siddharthnarayanan/RCI/schematics_review_240215_sidharth.xlsx

Sheet: Processor Design checklist
Schematics Review - T1020 based 12 port AFDX switch
Processor Design schematics from datasheet
S. No | PIN | SIGNAL | IN SCHEMATICS | IN DATASHEET | DESCRIPTION | COMMENTS
1 | L24 | D1_MECC0 | NO CONNECT | G1VDD | Error Correcting Code | why is it unconnected
2 | N23 | D1_MECC1 | NO CONNECT | G1VDD | Error Correcting Code | why is it unconnected
3 | T23 | D1_MECC2 | NO CONNECT | G1VDD | Error Correcting Code | why is it unconnected
4 | U23 | D1_MECC3 | NO CONNECT | G1VDD | Error Correcting Code | why is it unconnected
5 | L23 | D1_MECC4 | NO CONNECT | G1VDD | Error Correcting Code | why is it unconnected
6 | M23 | D1_MECC5 | NO CONNECT | G1VDD | Error Correcting Code | why is it unconnected
7 | R24 | D1_MECC6 | NO CONNECT | G1VDD | Error Correcting Code | why is it unconnected
8 | T24 | D1_MECC7 | NO CONNECT | G1VDD | Error Correcting Code | why is it unconnected
9 | C21 | D1_MDQ00 | DDR_DQ[0..63] | G1VDD | Data
10 | A22 | D1_MDQ01 | DDR_DQ[0..63] | G1VDD | Data
11 | A26 | D1_MDQ02 | DDR_DQ[0..63] | G1VDD | Data
12 | B26 | D1_MDQ03 | DDR_DQ[0..63] | G1VDD | Data
13 | B21 | D1_MDQ04 | DDR_DQ[0..63] | G1VDD | Data
14 | A21 | D1_MDQ05 | DDR_DQ[0..63] | G1VDD | Data
15 | B24 | D1_MDQ06 | DDR_DQ[0..63] | G1VDD | Data
16 | A25 | D1_MDQ07 | DDR_DQ[0..63] | G1VDD | Data
17 | C23 | D1_MDQ08 | DDR_DQ[0..63] | G1VDD | Data
18 | C24 | D1_MDQ09 | DDR_DQ[0..63] | G1VDD | Data
19 | F25 | D1_MDQ10 | DDR_DQ[0..63] | G1VDD | Data
20 | F26 | D1_MDQ11 | DDR_DQ[0..63] | G1VDD | Data
21 | D22 | D1_MDQ12 | DDR_DQ[0..63] | G1VDD | Data
22 | D23 | D1_MDQ13 | DDR_DQ[0..63] | G1VDD | Data
23 | B27 | D1_MDQ14 | DDR_DQ[0..63] | G1VDD | Data
24 | E25 | D1_MDQ15 | DDR_DQ[0..63] | G1VDD | Data
25 | E23 | D1_MDQ16 | DDR_DQ[0..63] | G1VDD | Data
26 | E24 | D1_MDQ17 | DDR_DQ[0..63] | G1VDD | Data
27 | J23 | D1_MDQ18 | DDR_DQ[0..63] | G1VDD | Data
28 | K23 | D1_MDQ19 | DDR_DQ[0..63] | G1VDD | Data
29 | F22 | D1_MDQ20 | DDR_DQ[0..63] | G1VDD | Data
30 | H22 | D1_MDQ21 | DDR_DQ[0..63] | G1VDD | Data
31 | H23 | D1_MDQ22 | DDR_DQ[0..63] | G1VDD | Data
32 | J24 | D1_MDQ23 | DDR_DQ[0..63] | G1VDD | Data
33 | H26 | D1_MDQ24 | DDR_DQ[0..63] | G1VDD | Data
34 | J25 | D1_MDQ25 | DDR_DQ[0..63] | G1VDD | Data
35 | P26 | D1_MDQ26 | DDR_DQ[0..63] | G1VDD | Data
36 | N25 | D1_MDQ27 | DDR_DQ[0..63] | G1VDD | Data
37 | G25 | D1_MDQ28 | DDR_DQ[0..63] | G1VDD | Data
38 | H25 | D1_MDQ29 | DDR_DQ[0..63] | G1VDD | Data
39 | M26 | D1_MDQ30 | DDR_DQ[0..63] | G1VDD | Data
40 | M25 | D1_MDQ31 | DDR_DQ[0..63] | G1VDD | Data
41 | T25 | D1_MDQ32 | DDR_DQ[0..63] | G1VDD | Data
42 | U25 | D1_MDQ33 | DDR_DQ[0..63] | G1VDD | Data
43 | AA26 | D1_MDQ34 | DDR_DQ[0..63] | G1VDD | Data
44 | AA25 | D1_MDQ35 | DDR_DQ[0..63] | G1VDD | Data
45 | P25 | D1_MDQ36 | DDR_DQ[0..63] | G1VDD | Data
46 | R25 | D1_MDQ37 | DDR_DQ[0..63] | G1VDD | Data
47 | W26 | D1_MDQ38 | DDR_DQ[0..63] | G1VDD | Data
48 | Y25 | D1_MDQ39 | DDR_DQ[0..63] | G1VDD | Data
49 | V24 | D1_MDQ40 | DDR_DQ[0..63] | G1VDD | Data
50 | W23 | D1_MDQ41 | DDR_DQ[0..63] | G1VDD | Data
51 | AA22 | D1_MDQ42 | DDR_DQ[0..63] | G1VDD | Data
52 | AC22 | D1_MDQ43 | DDR_DQ[0..63] | G1VDD | Data
53 | W22 | D1_MDQ44 | DDR_DQ[0..63] | G1VDD | Data
54 | V23 | D1_MDQ45 | DDR_DQ[0..63] | G1VDD | Data
55 | AB24 | D1_MDQ46 | DDR_DQ[0..63] | G1VDD | Data
56 | AB23 | D1_MDQ47 | DDR_DQ[0..63] | G1VDD | Data
57 | AD26 | D1_MDQ48 | DDR_DQ[0..63] | G1VDD | Data
58 | AD25 | D1_MDQ49 | DDR_DQ[0..63] | G1VDD | Data
59 | AD23 | D1_MDQ50 | DDR_DQ[0..63] | G1VDD | Data
60 | AE22 | D1_MDQ51 | DDR_DQ[0..63] | G1VDD | Data
61 | AB25 | D1_MDQ52 | DDR_DQ[0..63] | G1VDD | Data
62 | AC25 | D1_MDQ53 | DDR_DQ[0..63] | G1VDD | Data
63 | AC23 | D1_MDQ54 | DDR_DQ[0..63] | G1VDD | Data
64 | AE23 | D1_MDQ55 | DDR_DQ[0..63] | G1VDD | Data
65 | AG25 | D1_MDQ56 | DDR_DQ[0..63] | G1VDD | Data
66 | AH25 | D1_MDQ57 | DDR_DQ[0..63] | G1VDD | Data
67 | AH22 | D1_MDQ58 | DDR_DQ[0..63] | G1VDD | Data
68 | AF22 | D1_MDQ59 | DDR_DQ[0..63] | G1VDD | Data
69 | AF26 | D1_MDQ60 | DDR_DQ[0..63] | G1VDD | Data
70 | AH26 | D1_MDQ61 | DDR_DQ[0..63] | G1VDD | Data
71 | AH23 | D1_MDQ62 | DDR_DQ[0..63] | G1VDD | Data
72 | AF23 | D1_MDQ63 | DDR_DQ[0..63] | G1VDD | Data
73 | U28 | D1_MDIC1 |  |  | Driver Impedence Calibration
74 | P28 | D1_MDIC0 |  |  | Driver Impedence Calibration
75 | F28 | D1_MAPAR_ERR_B |  |  | Address Parity Error
76 | V27 | D1_MAPAR_OUT | NO CONNECT |  | Address Parity Out
77 | F20 | D1_MVREF |  |  | SSTL Reference Voltage
78 | J20 | D1_TPA | NO CONNECT |  | Reserved for internal use only
79 | T27 | D1_MCK0 | DDR_MCK0_P |  | Clock
80 | T28 | D1_MCK0_B | DDR_MCK0_N |  | Clock Complement
81 | R27 | D1_MCK1 | NO CONNECT |  | Clock
82 | R28 | D1_MCK1_B | NO CONNECT |  | Clock Complement
83 | K22 | TEST_OUT4 | NO CONNECT |  | Test Signal
84 | M22 | TEST_OUT5 | NO CONNECT |  | Test Signal
85 | U22 | TEST_OUT6 | NO CONNECT |  | Test Signal
86 | P22 | TEST_OUT7 | NO CONNECT |  | Test Signal
87 | A24 | D1_MDQS0 | DDR_MDQS0_P |  | Data Strobe
88 | D26 | D1_MDQS1 | DDR_MDQS1_P |  | Data Strobe
89 | G24 | D1_MDQS2 | DDR_MDQS2_P |  | Data Strobe
90 | L25 | D1_MDQS3 | DDR_MDQS3_P |  | Data Strobe
91 | W25 | D1_MDQS4 | DDR_MDQS4_P |  | Data Strobe
92 | AA23 | D1_MDQS5 | DDR_MDQS5_P |  | Data Strobe
93 | AE25 | D1_MDQS6 | DDR_MDQS6_P |  | Data Strobe
94 | AG24 | D1_MDQS7 | DDR_MDQS7_P |  | Data Strobe
95 | R23 | D1_MDQS8 | NO CONNECT |  | Data Strobe
96 | A23 | D1_MDQS0_B | DDR_MDQS0_N |  | Data Strobe
97 | D25 | D1_MDQS1_B | DDR_MDQS1_N |  | Data Strobe
98 | G23 | D1_MDQS2_B | DDR_MDQS2_N |  | Data Strobe
99 | K25 | D1_MDQS3_B | DDR_MDQS3_N |  | Data Strobe
100 | V25 | D1_MDQS4_B | DDR_MDQS4_N |  | Data Strobe
101 | Y23 | D1_MDQS5_B | DDR_MDQS5_N |  | Data Strobe
102 | AF25 | D1_MDQS6_B | DDR_MDQS6_N |  | Data Strobe
103 | AH24 | D1_MDQS7_B | DDR_MDQS7_N |  | Data Strobe
104 | P23 | D1_MDQS8_B | NO CONNECT |  | Data Strobe
105 | B22 | D1_MDM0 | DDR_MDM0 |  | Data Mask
106 | C25 | D1_MDM1 | DDR_MDM1 |  | Data Mask
107 | F23 | D1_MDM2 | DDR_MDM2 |  | Data Mask
108 | K26 | D1_MDM3 | DDR_MDM3 |  | Data Mask
109 | U26 | D1_MDM4 | DDR_MDM4 |  | Data Mask
110 | Y24 | D1_MDM5 | DDR_MDM5 |  | Data Mask
111 | AD24 | D1_MDM6 | DDR_MDM6 |  | Data Mask
112 | AF24 | D1_MDM7 | DDR_MDM7 |  | Data Mask
113 | N24 | D1_MDM8 | NO CONNECT |  | Data Mask
114 | Y28 | D1_MBA0 | DDR_MBA0 |  | Bank Select
115 | W28 | D1_MBA1 | DDR_MBA1 |  | Bank Select
116 | E28 | D1_MBA2 | DDR_MBA2 |  | Bank Select
117 | V28 | D1_MA00 | DDR_MA0 |  | Address
118 | N28 | D1_MA01 | DDR_MA1 |  | Address
119 | N27 | D1_MA02 | DDR_MA2 |  | Address
120 | M28 | D1_MA03 | DDR_MA3 |  | Address
121 | L27 | D1_MA04 | DDR_MA4 |  | Address
122 | L28 | D1_MA05 | DDR_MA5 |  | Address
123 | K28 | D1_MA06 | DDR_MA6 |  | Address
124 | J28 | D1_MA07 | DDR_MA7 |  | Address
125 | J27 | D1_MA08 | DDR_MA8 |  | Address
126 | G27 | D1_MA09 | DDR_MA9 |  | Address
127 | Y27 | D1_MA10 | DDR_MA10 |  | Address
128 | H28 | D1_MA11 | DDR_MA11 |  | Address
129 | G28 | D1_MA12 | DDR_MA12 |  | Address
130 | AE28 | D1_MA13 | DDR_MA13 |  | Address
131 | E27 | D1_MA14 | NO CONNECT |  | Address
132 | D28 | D1_MA15 | NO CONNECT |  | Address
133 | AC28 | D1_MRAS_B | DDR_MRAS_N |  | Row Address Strobe
134 | AA28 | D1_MCAS_B | DDR_MCAS_N |  | Column Address Strobe
135 | AB27 | D1_MWE_B | DDR_MWE_N |  | Write Enable
136 | AB28 | D1_MCS0_B | DDR_MCS0_N |  | Chip Select
137 | AC27 | D1_MCS1_B | NO CONNECT |  | Chip Select
138 | AG27 | D1_MCS2_B | NO CONNECT |  | Chip Select
139 | AF28 | D1_MCS3_B | NO CONNECT |  | Chip Select
140 | C27 | D1_MCKE0 | DDR_MCKE0 |  | Clock Enable
141 | C28 | D1_MCKE1 | NO CONNECT |  | Clock Enable
142 | H21 | TEST_OUT0 | NO CONNECT |  | Test Signal
143 | F21 | TEST_OUT1 | NO CONNECT |  | Test Signal
144 | AD28 | D1_MODT0 | DDR_MODT0 |  | On Die Termination
145 | AE27 | D1_MODT1 | NO CONNECT |  | On Die Termination
146 | W21 | TEST_OUT2 | NO CONNECT |  | Test Signal
147 | V21 | TEST_OUT3 | NO CONNECT |  | Test Signal
148 | A4 | IFC_AD00 | IFC_AD0 |  | IFC Address / Data
149 | B5 | IFC_AD01 | IFC_AD1 |  | IFC Address / Data
150 | A5 | IFC_AD02 | IFC_AD2 |  | IFC Address / Data
151 | B6 | IFC_AD03 | IFC_AD3 |  | IFC Address / Data
152 | A6 | IFC_AD04 | IFC_AD4 |  | IFC Address / Data
153 | A7 | IFC_AD05 | IFC_AD5 |  | IFC Address / Data
154 | B8 | IFC_AD06 | IFC_AD6 |  | IFC Address / Data
155 | A8 | IFC_AD07 | IFC_AD7 |  | IFC Address / Data
156 | B9 | IFC_AD08 | IFC_AD8 |  | IFC Address / Data
157 | A9 | IFC_AD09 | IFC_AD9 |  | IFC Address / Data
158 | A10 | IFC_AD10 | IFC_AD10 |  | IFC Address / Data
159 | B11 | IFC_AD11 | IFC_AD11 |  | IFC Address / Data
160 | A11 | IFC_AD12 | IFC_AD12 |  | IFC Address / Data
161 | B12 | IFC_AD13 | IFC_AD13 |  | IFC Address / Data
162 | A12 | IFC_AD14 | IFC_AD14 |  | IFC Address / Data
163 | A13 | IFC_AD15 | IFC_AD15 |  | IFC Address / Data
164 | C5 | IFC_A16 | IFC_A16 |  | IFC Address
165 | C6 | IFC_A17 | IFC_A17 |  | IFC Address
166 | D7 | IFC_A18 | IFC_A18 |  | IFC Address
167 | C7 | IFC_A19 | IFC_A19 |  | IFC Address
168 | D8 | IFC_A20 | IFC_A20 |  | IFC Address
169 | C8 | IFC_A21 | IFC_A21 |  | IFC Address
170 | D9 | IFC_A22 | IFC_A22 |  | IFC Address
171 | C9 | IFC_A23 | IFC_A23 |  | IFC Address
172 | D10 | IFC_A24 | IFC_A24 |  | IFC Address
173 | C10 | IFC_A25 | IFC_A25 |  | IFC Address
174 | E11 | IFC_A26 | IFC_A26 |  | IFC Address
175 | C11 | IFC_A27 | IFC_A27 |  | IFC Address
176 | D11 | IFC_A28 | IFC_A28 |  | IFC Address
177 | C12 | IFC_A29 | IFC_A29 |  | IFC Address
178 | D12 | IFC_A30 | IFC_A30 |  | IFC Address
179 | E12 | IFC_A31 | NO CONNECT |  | IFC Address
180 | C13 | IFC_CS0_B | IFC_CS0_N |  | IFC Chip Select
181 | E15 | IFC_CS1_B | NO CONNECT |  | IFC Chip Select
182 | D16 | IFC_CS2_B | NO CONNECT |  | IFC Chip Select
183 | C16 | IFC_CS3_B | NO CONNECT |  | IFC Chip Select
184 | E17 | IFC_CS4_B | NO CONNECT |  | IFC Chip Select
185 | C17 | IFC_CS5_B | NO CONNECT |  | IFC Chip Select
186 | D18 | IFC_CS6_B | NO CONNECT |  | IFC Chip Select
187 | C19 | IFC_CS7_B | NO CONNECT |  | IFC Chip Select
188 | D13 | IFC_WE0_B | IFC_WE_N |  | IFC Write Enable
189 | F16 | IFC_CLE | IFC_CLE |  | IFC Command Latch Enable
190 | D15 | IFC_OE_B |  |  | IFC Output Enable
191 | B15 | IFC_RB0_B |  |  | IFC Ready / Busy CS0
192 | A15 | IFC_RB1_B |  |  | IFC Ready / Busy CS1
193 | F17 | IFC_WP0_B |  |  | IFC Write Protect
194 | D17 | IFC_AVD |  |  | IFC Address Valid
195 | A14 | IFC_BCTL | NO CONNECT |  | IFC Buffer control
196 | B14 | IFC_TE |  |  | IFC External Transceiver Enable
197 | A17 | IFC_CLK0 | NO CONNECT |  | IFC Clock
198 | A19 | IFC_CLK1 | NO CONNECT |  | IFC Clock
199 | D14 | IFC_NDDDR_CLK | NO CONNECT |  | IFC NAND DDR Clock
200 | A16 | IFC_NDDQS | NO CONNECT |  | IFC DQS Strobe
201 | E14 | IFC_PERR_B |  |  | IFC Parity Error
202 | C15 | IFC_PAR0 |  |  | IFC Address & Data Parity
203 | C14 | IFC_PAR1 |  |  | IFC Address & Data Parity
204 | F9 | SCAN_MODE_B |  |  | Reserved
205 | G8 | TEST_SEL_B |  |  | Reserved
206 | F7 | IRQ00 |  |  | External Interrupt
207 | D3 | IRQ01 |  |  | External Interrupt
208 | E9 | IRQ02 |  |  | External Interrupt
209 | D1 | IRQ03 |  |  | External Interrupt
210 | D4 | IRQ04 |  |  | External Interrupt
211 | D5 | IRQ05 |  |  | External Interrupt
212 | AB4 | IRQ06 |  |  | External Interrupt
213 | AD5 | IRQ07 |  |  | External Interrupt
214 | AB1 | IRQ08 |  |  | External Interrupt
215 | AC5 | IRQ09 |  |  | External Interrupt
216 | L4 | IRQ10 |  |  | External Interrupt
217 | U3 | IRQ11 |  |  | External Interrupt
218 | A3 | IRQ_OUT_B |  |  | Interrupt Output
219 | F19 | TMP_DETECT_B |  |  | Tamper Detect
220 | F13 | PORESET_B |  |  | Power On Reset
221 | E8 | HRESET_B |  |  | Hard Reset
222 | B3 | RESET_REQ_B |  |  | Reset Request (POR or Hard)
223 | P5 | DMA1_DREQ0_B |  |  | DMA1 channel 0 request
224 | U5 | DMA1_DACK0_B | NO CONNECT |  | DMA1 channel 0 acknowledge
225 | R5 | DMA1_DDONE0_B | NO CONNECT |  | DMA1 channel 0 done
226 | V5 | DMA2_DREQ0_B |  |  | DMA2 channel 0 request
227 | AA5 | DMA2_DACK0_B |  |  | DMA2 channel 0 acknowledge
228 | Y5 | DMA2_DDONE0_B |  |  | DMA2 channel 0 done
229 | A18 | TDI |  |  | Test Data In
230 | C18 | TDO |  |  | Test Data Out
231 | E18 | TCK |  |  | Test Clock
232 | B18 | TMS |  |  | Test Mode Select
233 | D19 | TRST_B |  |  | Test Reset
234 | G15 | SYSCLK |  |  | System Clock
235 | J21 | DDRCLK |  |  | DDR Controller Clock
236 | G14 | DIFF_SYSCLK |  |  | Single Oscillator Source Reference Clock Differential (positive)
237 | F14 | DIFF_SYSCLK_B |  |  | Single Oscillator Source Reference Clock Differential (negative)
238 | B17 | RTC |  |  | General Purpose Input/Output
239 | E21 | TD1_ANODE | NO CONNECT |  | Thermal diode anode
240 | G21 | TD1_CATHODE | NO CONNECT |  | Thermal diode cathode
241 | D6 | EVT0_B |  |  | Event 0
242 | C4 | EVT1_B |  |  | Event 1
243 | C1 | EVT2_B | EVT_PWR_EN |  | Event 2
244 | C2 | EVT3_B |  |  | Event 3
245 | C3 | EVT4_B |  |  | Event 4
246 | W1 | IIC1_SCL |  |  | Serial Clock (supports PBL)
247 | V1 | IIC1_SDA |  |  | Serial Clock (supports PBL)
248 | V3 | IIC2_SCL |  |  | Serial Clock
249 | Y3 | IIC2_SDA |  |  | Serial Data
250 | V2 | IIC3_SCL |  |  | Serial Clock
251 | W3 | IIC3_SDA |  |  | Serial Data
252 | AA3 | IIC4_SCL |  |  | Serial Clock
253 | AB3 | IIC4_SDA |  |  | Serial Data
254 | AA1 | UART1_SIN |  |  | General Purpose Input/Output
255 | AA2 | UART1_SOUT |  |  | General Purpose Input/Output
256 | Y2 | UART1_CTS_B |  |  | General Purpose Input/Output
257 | Y1 | UART1_RTS_B | NO CONNECT |  | General Purpose Input/Output
258 | W4 | UART2_SIN |  |  | General Purpose Input/Output
259 | AA4 | UART2_SOUT |  |  | General Purpose Input/Output
260 | Y4 | UART2_CTS_B |  |  | General Purpose Input/Output
261 | V4 | UART2_RTS_B | NO CONNECT |  | General Purpose Input/Output
262 | B2 | ASLEEP |  |  | General Purpose Input/Output
263 | F18 | CKSTP_OUT_B |  |  | Checkstop Out
264 | E6 | CLK_OUT |  |  | Clock Out
265 | B20 | FA_ANALOG_PIN |  |  | Reserved for internal use only
266 | C20 | FA_ANALOG_G_V |  |  | Reserved for internal use only
267 | AE3 | EC1_TXD0
268 | AE4 | EC1_TXD1
269 | AD3 | EC1_TXD2
270 | AC3 | EC1_TXD3
271 | AF4 | EC1_TX_CTL
272 | AF3 | EC1_GTX_CLK
273 | AC4 | EC1_TX_ER
274 | AF2 | EC1_RXD0
275 | AF1 | EC1_RXD1
276 | AE1 | EC1_RXD2
277 | AD2 | EC1_RXD3
278 | AG2 | EC1_RX_CTL
279 | AD1 | EC1_RX_CLK
280 | AG3 | EC1_GTX_CLK125
281 | AC2 | EC1_RX_ER
282 | AC1 | EC1_COL
283 | AH3 | EMI1_MDC
284 | AH4 | EMI1_MDIO
285 | AC8 | TSEC_1588_CLK_IN
286 | AB6 | TSEC_1588_TRIG_IN1
287 | AE5 | TSEC_1588_TRIG_IN2
288 | AE7 | EC2_TXD0
289 | AF7 | EC2_TXD1
290 | AF6 | EC2_TXD2
291 | AG5 | EC2_TXD3
292 | AF8 | EC2_TX_CTL
293 | AE8 | EC2_GTX_CLK
294 | AH8 | EC2_RXD0
295 | AG7 | EC2_RXD1
296 | AH7 | EC2_RXD2
297 | AH6 | EC2_RXD3
298 | AG8 | EC2_RX_CTL
299 | AH5 | EC2_RX_CLK
300 | AC6 | EC2_GTX_CLK125
301 | AD7 | TSEC_1588_CLK_OUT
302 | AF5 | TSEC_1588_ALARM_OUT1
303 | AC7 | TSEC_1588_ALARM_OUT2
304 | AE6 | TSEC_1588_PULSE_OUT1
305 | AD8 | TSEC_1588_PULSE_OUT2
306 | AH10 | SD1_RX0_P
307 | AG10 | SD1_RX0_N
308 | AH11 | SD1_RX1_P
309 | AG11 | SD1_RX1_N
310 | AH13 | SD1_RX2_P
311 | AG13 | SD1_RX2_N
312 | AH14 | SD1_RX3_P
313 | AG14 | SD1_RX3_N
314 | AH16 | SD1_RX4_P
315 | AG16 | SD1_RX4_N
316 | AH17 | SD1_RX5_P
317 | AG17 | SD1_RX5_N
318 | AH19 | SD1_RX6_P
319 | AG19 | SD1_RX6_N
320 | AH20 | SD1_RX7_P
321 | AG20 | SD1_RX7_N
322 | AB14 | SD1_REF_CLK1_P
323 | AA14 | SD1_REF_CLK1_N
324 | Y15 | SD1_PLL1_TPA
325 | AB15 | SD1_PLL1_TPD
326 | Y19 | SD1_PLL2_TPA
327 | AB19 | SD1_PLL2_TPD
328 | AD10 | SD1_TX0_P
329 | AE10 | SD1_TX0_N
330 | AD11 | SD1_TX1_P
331 | AE11 | SD1_TX1_N
332 | AD13 | SD1_TX2_P
333 | AE13 | SD1_TX2_N
334 | AD14 | SD1_TX3_P
335 | AE14 | SD1_TX3_N
336 | AD16 | SD1_TX4_P
337 | AE16 | SD1_TX4_N
338 | AD17 | SD1_TX5_P
339 | AE17 | SD1_TX5_N
340 | AD19 | SD1_TX6_P
341 | AE19 | SD1_TX6_N
342 | AD20 | SD1_TX7_P
343 | AE20 | SD1_TX7_N
344 | AB18 | SD1_REF_CLK2_P
345 | AA18 | SD1_REF_CLK2_N
346 | Y20 | SD1_IMP_CAL_TX
347 | AA12 | SD1_IMP_CAL_RX
348 | U2 | TDMA_RXD
349 | U1 | TDMA_RSYNC
350 | T1 | TDMA_TXD
351 | R1 | TDMA_TSYNC
352 | R2 | TDMA_RQ
353 | U4 | TDMB_RXD
354 | T3 | TDMB_RSYNC
355 | T4 | TDMB_TXD
356 | R3 | TDMB_TSYNC
357 | R4 | TDMB_RQ
358 | P4 | CLK09
359 | P3 | CLK10
360 | N4 | CLK11
361 | M4 | CLK12
362 | F5 | USB1_PWRFAULT
363 | H5 | USB2_PWRFAULT
364 | G4 | USB_IBIAS_REXT
365 | F8 | USBCLK
366 | F6 | USB1_DRVVBUS
367 | F1 | USB1_UDP
368 | F2 | USB1_UDM
369 | E4 | USB1_VBUSCLMP
370 | F4 | USB1_UID
371 | J5 | USB2_DRVVBUS
372 | H1 | USB2_UDP
373 | H2 | USB2_UDM
374 | J4 | USB2_VBUSCLMP
375 | H4 | USB2_UID
376 | D27 | G1VDD01
377 | F27 | G1VDD02
378 | H27 | G1VDD03
379 | K21 | G1VDD04
380 | K27 | G1VDD05
381 | L21 | G1VDD06
382 | M21 | G1VDD07
383 | M27 | G1VDD08
384 | N21 | G1VDD09
385 | P21 | G1VDD10
386 | P27 | G1VDD11
387 | R21 | G1VDD12
388 | T21 | G1VDD13
389 | U21 | G1VDD14
390 | U27 | G1VDD15
391 | W27 | G1VDD16
392 | AA27 | G1VDD17
393 | AD27 | G1VDD18
394 | AF27 | G1VDD19
395 | V8 | LVDD1
396 | W8 | LVDD2
397 | T8 | LV1DD1
398 | U8 | LV1DD2
399 | J14 | OVDD1
400 | J15 | OVDD2
401 | J16 | OVDD3
402 | J17 | OVDD4
403 | J18 | OVDD5
404 | J19 | OVDD6
405 | J11 | O1VDD1
406 | J12 | O1VDD2
407 | J13 | O1VDD3
408 | N8 | DVDD1
409 | P8 | DVDD2
410 | R8 | DVDD3
411 | M8 | CVDD1
412 | L8 | EVDD1
413 | F12 | PROG_SFP
414 | F11 | PROG_MTR
415 | G18 | FA_VL
416 | G9 | TH_VDD
418 | W15 | S1VDD1
419 | W16 | S1VDD2
420 | W17 | S1VDD3
421 | W18 | S1VDD4
422 | W19 | S1VDD5
423 | W20 | S1VDD6
424 | Y13 | S1VDD7
425 | AC9 | X1VDD1
426 | AC12 | X1VDD2
427 | AC15 | X1VDD3
428 | AC18 | X1VDD4
429 | AC21 | X1VDD5
430 | K15 | VDD01
431 | K17 | VDD02
432 | K19 | VDD03
433 | L12 | VDD04
434 | L14 | VDD05
435 | L16 | VDD06
436 | L18 | VDD07
437 | L20 | VDD08
438 | M9 | VDD09
439 | M13 | VDD10
440 | M15 | VDD11
441 | M17 | VDD12
442 | M19 | VDD13
443 | N12 | VDD14
444 | N14 | VDD15
445 | N16 | VDD16
446 | N18 | VDD17
447 | N20 | VDD18
448 | P9 | VDD19
449 | P11 | VDD20
450 | P13 | VDD21
451 | P15 | VDD22
452 | P17 | VDD23
453 | P19 | VDD24
454 | R12 | VDD25
455 | R14 | VDD26
456 | R16 | VDD27
457 | R18 | VDD28
458 | R20 | VDD29
459 | T9 | VDD30
460 | T13 | VDD31
461 | T15 | VDD32
462 | T17 | VDD33
463 | T19 | VDD34
464 | U14 | VDD35
465 | U16 | VDD36
466 | U18 | VDD37
467 | U20 | VDD38
468 | V9 | VDD39
469 | V13 | VDD40
470 | V15 | VDD41
471 | V17 | VDD42
472 | V19 | VDD43
473 | W14 | VDD44
474 | Y8 | VDD45
475 | Y9 | VDD46
476 | Y11 | VDD47
477 | K11 | VDDC01
478 | K13 | VDDC02
479 | L10 | VDDC03
480 | M11 | VDDC04
481 | N10 | VDDC05
482 | R10 | VDDC06
483 | K9 | USB_SVDD1
484 | K10 | USB_SVDD2
485 | J8 | USB_HVDD1
486 | K8 | USB_HVDD2
487 | J9 | USB_OVDD1
488 | J10 | USB_OVDD2
489 | AB9 | SENSEVDDC
490 | AB10 | SENSEGNDC
491 | G19 | SENSEVDD
492 | G20 | SENSEGND
493 | T11 | VDDC07
494 | U10 | VDDC08
495 | U12 | VDDC09
496 | V11 | VDDC10
497 | W10 | VDDC11
498 | W12 | VDDC12
499 | AG28 | NC_DET | NO CONNECT
500 | G17 | NC01 | NO CONNECT
501 | N6 | NC02 | NO CONNECT
502 | T6 | NC03 | NO CONNECT
503 | U6 | NC04 | NO CONNECT
504 | V6 | NC05 | NO CONNECT
505 | W6 | NC06 | NO CONNECT
506 | Y6 | NC07 | NO CONNECT
507 | AA6 | NC08 | NO CONNECT
508 | AA7 | NC09 | NO CONNECT
509 | AA8 | NC10 | NO CONNECT
510 | AA9 | NC11 | NO CONNECT
511 | AA10 | NC12 | NO CONNECT
512 | AB8 | NC13 | NO CONNECT
513 | AB11 | NC14 | NO CONNECT
514 | AB12 | NC15 | NO CONNECT
515 | AH27 | DEV_DET | NO CONNECT
516 | G6 | SPARE1 | NO CONNECT
517 | H6 | SPARE2 | NO CONNECT
518 | J6 | SPARE3 | NO CONNECT
519 | F10 | TH_TPA | NO CONNECT
520 | G11 | AVDD_CGA1 | AVDD_CGA1
521 | G12 | AVDD_CGA2 | AVDD_CGA2
522 | G10 | AVDD_PLAT | AVDD_PLAT
523 | E20 | AVDD_D1 | AVDD_DDR1
524 | AB16 | AVDD_SD1_PLL1 | AVDD_SD1_PLL1
525 | AA16 | AGND_SD1_PLL1 | AGND_SD1_PLL1
526 | AB20 | AVDD_SD1_PLL2 | AVDD_SD1_PLL2
527 | AA20 | AGND_SD1_PLL2 | AGND_SD1_PLL2
528 | A2 | GND001 | GND
529 | A20 | GND002 | GND
530 | A27 | GND003 | GND
531 | B1 | GND004 | GND
532 | B4 | GND005 | GND
533 | B7 | GND006 | GND
534 | B10 | GND007 | GND
535 | B13 | GND008 | GND
536 | B16 | GND009 | GND
537 | B19 | GND010 | GND
538 | B23 | GND011 | GND
539 | B25 | GND012 | GND
540 | B28 | GND013 | GND
541 | C22 | GND014 | GND
542 | C26 | GND015 | GND
543 | D2 | GND016 | GND
544 | D20 | GND017 | GND
545 | D21 | GND018 | GND
546 | D24 | GND019 | GND
547 | E5 | GND020 | GND
548 | E7 | GND021 | GND
549 | E10 | GND022 | GND
550 | E13 | GND023 | GND
551 | E16 | GND024 | GND
552 | E19 | GND025 | GND
553 | E22 | GND026 | GND
554 | E26 | GND027 | GND
555 | F15 | GND028 | GND
556 | F24 | GND029 | GND
557 | G7 | GND030 | GND
558 | G13 | GND031 | GND
559 | G16 | GND032 | GND
560 | G22 | GND033 | GND
561 | G26 | GND034 | GND
562 | H7 | GND035 | GND
563 | H8 | GND036 | GND
564 | H9 | GND037 | GND
565 | H10 | GND038 | GND
566 | H11 | GND039 | GND
567 | H12 | GND040 | GND
568 | H13 | GND041 | GND
569 | H14 | GND042 | GND
570 | H15 | GND043 | GND
571 | H16 | GND044 | GND
572 | H17 | GND045 | GND
573 | H18 | GND046 | GND
574 | H19 | GND047 | GND
575 | H20 | GND048 | GND
576 | H24 | GND049 | GND
577 | J7 | GND050 | GND
578 | J22 | GND051 | GND
579 | J26 | GND052 | GND
580 | K2 | GND053 | GND
581 | K5 | GND054 | GND
582 | K6 | GND055 | GND
583 | K7 | GND056 | GND
584 | K12 | GND057 | GND
585 | K14 | GND058 | GND
586 | K16 | GND059 | GND
587 | K18 | GND060 | GND
588 | K20 | GND061 | GND
589 | K24 | GND062 | GND
590 | L7 | GND063 | GND
591 | L9 | GND064 | GND
592 | L11 | GND065 | GND
593 | L13 | GND066 | GND
594 | L15 | GND067 | GND
595 | L17 | GND068 | GND
596 | L19 | GND069 | GND
597 | L22 | GND070 | GND
598 | L26 | GND071 | GND
599 | M7 | GND072 | GND
600 | M10 | GND073 | GND
601 | M12 | GND074 | GND
602 | M14 | GND075 | GND
603 | M16 | GND076 | GND
604 | M18 | GND077 | GND
605 | M20 | GND078 | GND
606 | M24 | GND079 | GND
607 | N2 | GND080 | GND
608 | N5 | GND081 | GND
609 | N7 | GND082 | GND
610 | N9 | GND083 | GND
611 | N11 | GND084 | GND
612 | N13 | GND085 | GND
613 | N15 | GND086 | GND
614 | N17 | GND087 | GND
615 | N19 | GND088 | GND
616 | N22 | GND089 | GND
617 | N26 | GND090 | GND
618 | P7 | GND091 | GND
619 | P10 | GND092 | GND
620 | P12 | GND093 | GND
621 | P14 | GND094 | GND
622 | P16 | GND095 | GND
623 | P18 | GND096 | GND
624 | P20 | GND097 | GND
625 | P24 | GND098 | GND
626 | R7 | GND099 | GND
627 | R9 | GND100 | GND
628 | R11 | GND101 | GND
629 | R13 | GND102 | GND
630 | R15 | GND103 | GND
631 | R17 | GND104 | GND
632 | R19 | GND105 | GND
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
751 | AC20 | X1GND08 | GND
752 | AD9 | X1GND09 | GND
753 | AD12 | X1GND10 | GND
754 | AD15 | X1GND11 | GND
755 | AD18 | X1GND12 | GND
756 | AD21 | X1GND13 | GND
757 | AE9 | X1GND14 | GND
758 | AE12 | X1GND15 | GND
759 | AE15 | X1GND16 | GND
760 | AE18 | X1GND17 | GND
761 | AE21 | X1GND18 | GND

Sheet: DDR3L Interface
Schematics Review - T1020 based 12 port AFDX switch
DDR3L Interface schematics from datasheet
S. No | PIN | SIGNAL | IN SCHEMATICS | IN DATASHEET | TYPE | DESCRIPTION | COMMENTS
MT41K128M16JT-125-AATK (U2)
1 | A1 | VDDQ | 1V35 | 1.35V, 1.283–1.45V operational | Supply | DQ power supply
2 | A8 | VDDQ | 1V35 | 1.35V, 1.283–1.45V operational | Supply | DQ power supply
3 | C1 | VDDQ | 1V35 | 1.35V, 1.283–1.45V operational | Supply | DQ power supply
4 | C9 | VDDQ | 1V35 | 1.35V, 1.283–1.45V operational | Supply | DQ power supply
5 | D2 | VDDQ | 1V35 | 1.35V, 1.283–1.45V operational | Supply | DQ power supply
6 | E9 | VDDQ | 1V35 | 1.35V, 1.283–1.45V operational | Supply | DQ power supply
7 | F1 | VDDQ | 1V35 | 1.35V, 1.283–1.45V operational | Supply | DQ power supply
8 | H2 | VDDQ | 1V35 | 1.35V, 1.283–1.45V operational | Supply | DQ power supply
9 | H9 | VDDQ | 1V35 | 1.35V, 1.283–1.45V operational | Supply | DQ power supply
10 | B1 | VSSQ | Ground | Ground | Supply | DQ ground | Isolated on the device
11 | B9 | VSSQ | Ground | Ground | Supply | DQ ground | Isolated on the device
12 | D1 | VSSQ | Ground | Ground | Supply | DQ ground | Isolated on the device
13 | D8 | VSSQ | Ground | Ground | Supply | DQ ground | Isolated on the device
14 | E2 | VSSQ | Ground | Ground | Supply | DQ ground | Isolated on the device
15 | E8 | VSSQ | Ground | Ground | Supply | DQ ground | Isolated on the device
16 | F9 | VSSQ | Ground | Ground | Supply | DQ ground | Isolated on the device
17 | G1 | VSSQ | Ground | Ground | Supply | DQ ground | Isolated on the device
18 | G9 | VSSQ | Ground | Ground | Supply | DQ ground | Isolated on the device
19 | A9 | VSS | Ground | Ground | Supply | Ground
20 | B3 | VSS | Ground | Ground | Supply | Ground
21 | E1 | VSS | Ground | Ground | Supply | Ground
22 | G8 | VSS | Ground | Ground | Supply | Ground
23 | J2 | VSS | Ground | Ground | Supply | Ground
24 | J8 | VSS | Ground | Ground | Supply | Ground
25 | M1 | VSS | Ground | Ground | Supply | Ground
26 | M9 | VSS | Ground | Ground | Supply | Ground
27 | P1 | VSS | Ground | Ground | Supply | Ground
28 | P9 | VSS | Ground | Ground | Supply | Ground
29 | T1 | VSS | Ground | Ground | Supply | Ground
30 | T9 | VSS | Ground | Ground | Supply | Ground
31 | B2 | VDD | 1V35 | 1.35V, 1.283–1.45V operational | Supply | Power supply
32 | D9 | VDD | 1V35 | 1.35V, 1.283–1.45V operational | Supply | Power supply
33 | G7 | VDD | 1V35 | 1.35V, 1.283–1.45V operational | Supply | Power supply
34 | K2 | VDD | 1V35 | 1.35V, 1.283–1.45V operational | Supply | Power supply
35 | K8 | VDD | 1V35 | 1.35V, 1.283–1.45V operational | Supply | Power supply
36 | N1 | VDD | 1V35 | 1.35V, 1.283–1.45V operational | Supply | Power supply
37 | N9 | VDD | 1V35 | 1.35V, 1.283–1.45V operational | Supply | Power supply
38 | R1 | VDD | 1V35 | 1.35V, 1.283–1.45V operational | Supply | Power supply
39 | R9 | VDD | 1V35 | 1.35V, 1.283–1.45V operational | Supply | Power supply
40 | M8 | VREFCA | MVREF |  | Supply | Reference voltage for control, command, and address
41 | H1 | VREFDQ | MVREF |  | Supply | Reference voltage for data
42 | J1 | NC | NO CONNECT | NO CONNECT | - | NO CONNECT
43 | J9 | NC | NO CONNECT | NO CONNECT | - | NO CONNECT
44 | L1 | NC | NO CONNECT | NO CONNECT | - | NO CONNECT
45 | L9 | NC | NO CONNECT | NO CONNECT | - | NO CONNECT
46 | M7 | NC | NO CONNECT | NO CONNECT | - | NO CONNECT
47 | T7 | NC | NO CONNECT | NO CONNECT | - | NO CONNECT
48 | L8 | ZQ | GND | 240Ω resistor (RZQ), which is tied to VSSQ |  | External reference ball for output drive calibration
49 | T3 | A13 | DDR_MA13 | Input | Input | Address inputs
50 | N7 | A12/BC# | DDR_MA12 | Input | Input | Address inputs
51 | R7 | A11 | DDR_MA11 | Input | Input | Address inputs
52 | L7 | A10/AP | DDR_MA10 | Input | Input | Address inputs
53 | R3 | A9 | DDR_MA9 | Input | Input | Address inputs
54 | T8 | A8 | DDR_MA8 | Input | Input | Address inputs
55 | R2 | A7 | DDR_MA7 | Input | Input | Address inputs
56 | R8 | A6 | DDR_MA6 | Input | Input | Address inputs
57 | P2 | A5 | DDR_MA5 | Input | Input | Address inputs
58 | P8 | A4 | DDR_MA4 | Input | Input | Address inputs
59 | N2 | A3 | DDR_MA3 | Input | Input | Address inputs
60 | P3 | A2 | DDR_MA2 | Input | Input | Address inputs
61 | P7 | A1 | DDR_MA1 | Input | Input | Address inputs
62 | N3 | A0 | DDR_MA0 | Input | Input | Address inputs
63 | M3 | BA2 | DDR_MBA2 | Input | Input | Address inputs
64 | N8 | BA1 | DDR_MBA1 | Input | Input | Address inputs
65 | M2 | BA0 | DDR_MBA0 | Input | Input | Address inputs
66 | J3 | RAS# | DDR_MRAS_N | Command inputs | Input | Command inputs
67 | K3 | CAS# | DDR_MCAS_N | Command inputs | Input | Command inputs
68 | E3 | DQ0 | DDR_DQ0 | Data input/output | I/O | Data input/output
69 | F7 | DQ1 | DDR_DQ1 | Data input/output | I/O | Data input/output
70 | F2 | DQ2 | DDR_DQ2 | Data input/output | I/O | Data input/output
71 | F8 | DQ3 | DDR_DQ3 | Data input/output | I/O | Data input/output
72 | H3 | DQ4 | DDR_DQ4 | Data input/output | I/O | Data input/output
73 | H8 | DQ5 | DDR_DQ5 | Data input/output | I/O | Data input/output
74 | G2 | DQ6 | DDR_DQ6 | Data input/output | I/O | Data input/output
75 | H7 | DQ7 | DDR_DQ7 | Data input/output | I/O | Data input/output
76 | D7 | DQ8 | DDR_DQ8 | Data input/output | I/O | Data input/output
77 | C3 | DQ9 | DDR_DQ9 | Data input/output | I/O | Data input/output
78 | C8 | DQ10 | DDR_DQ10 | Data input/output | I/O | Data input/output
79 | C2 | DQ11 | DDR_DQ11 | Data input/output | I/O | Data input/output
80 | A7 | DQ12 | DDR_DQ12 | Data input/output | I/O | Data input/output
81 | A2 | DQ13 | DDR_DQ13 | Data input/output | I/O | Data input/output
82 | B8 | DQ14 | DDR_DQ14 | Data input/output | I/O | Data input/output
83 | A3 | DQ15 | DDR_DQ15 | Data input/output | I/O | Data input/output
84 | F3 | LDQS | DDR_MDQS0_P | Lower byte data strobe | I/O | Lower byte data strobe
85 | G3 | LDQS# | DDR_MDQS0_N | Lower byte data strobe | I/O | Lower byte data strobe
86 | C7 | UDQS | DDR_MDQS1_P | Upper byte data strobe | I/O | Upper byte data strobe
87 | B7 | UDQS# | DDR_MDQS1_N | Upper byte data strobe | I/O | Upper byte data strobe
88 | E7 | LDM | DDR_MDM0 | Input data mask | Input | Input data mask
89 | D3 | UDM | DDR_MDM1 | Input data mask | Input | Input data mask
90 | J7 | CK | DDR_MCK0_P | Clock | Input | Clock
91 | K7 | CK# | DDR_MCK0_N | Clock | Input | Clock
92 | K9 | CKE | DDR_MCKE0 | Clock enable | Input | Clock enable
93 | L2 | CS# | DDR_MCS0_N | Chip select | Input | Chip select
94 | L3 | WE# | DDR_MWE_N | Command inputs | Input | Command inputs
95 | T2 | RESET# | DDR_RST_N | Reset | Input | Reset
96 | K1 | ODT | D1_MODT0 | On-die termination | Input | On-die termination
MT41K128M16JT-125-AATK (U3)
1 | A1 | VDDQ | 1V35 | 1.35V, 1.283–1.45V operational | Supply | DQ power supply
2 | A8 | VDDQ | 1V35 | 1.35V, 1.283–1.45V operational | Supply | DQ power supply
3 | C1 | VDDQ | 1V35 | 1.35V, 1.283–1.45V operational | Supply | DQ power supply
4 | C9 | VDDQ | 1V35 | 1.35V, 1.283–1.45V operational | Supply | DQ power supply
5 | D2 | VDDQ | 1V35 | 1.35V, 1.283–1.45V operational | Supply | DQ power supply
6 | E9 | VDDQ | 1V35 | 1.35V, 1.283–1.45V operational | Supply | DQ power supply
7 | F1 | VDDQ | 1V35 | 1.35V, 1.283–1.45V operational | Supply | DQ power supply
8 | H2 | VDDQ | 1V35 | 1.35V, 1.283–1.45V operational | Supply | DQ power supply
9 | H9 | VDDQ | 1V35 | 1.35V, 1.283–1.45V operational | Supply | DQ power supply
10 | B1 | VSSQ | Ground | Ground | Supply | DQ ground | Isolated on the device
11 | B9 | VSSQ | Ground | Ground | Supply | DQ ground | Isolated on the device
12 | D1 | VSSQ | Ground | Ground | Supply | DQ ground | Isolated on the device
13 | D8 | VSSQ | Ground | Ground | Supply | DQ ground | Isolated on the device
14 | E2 | VSSQ | Ground | Ground | Supply | DQ ground | Isolated on the device
15 | E8 | VSSQ | Ground | Ground | Supply | DQ ground | Isolated on the device
16 | F9 | VSSQ | Ground | Ground | Supply | DQ ground | Isolated on the device
17 | G1 | VSSQ | Ground | Ground | Supply | DQ ground | Isolated on the device
18 | G9 | VSSQ | Ground | Ground | Supply | DQ ground | Isolated on the device
19 | A9 | VSS | Ground | Ground | Supply | Ground
20 | B3 | VSS | Ground | Ground | Supply | Ground
21 | E1 | VSS | Ground | Ground | Supply | Ground
22 | G8 | VSS | Ground | Ground | Supply | Ground
23 | J2 | VSS | Ground | Ground | Supply | Ground
24 | J8 | VSS | Ground | Ground | Supply | Ground
25 | M1 | VSS | Ground | Ground | Supply | Ground
26 | M9 | VSS | Ground | Ground | Supply | Ground
27 | P1 | VSS | Ground | Ground | Supply | Ground
28 | P9 | VSS | Ground | Ground | Supply | Ground
29 | T1 | VSS | Ground | Ground | Supply | Ground
30 | T9 | VSS | Ground | Ground | Supply | Ground
31 | B2 | VDD | 1V35 | 1.35V, 1.283–1.45V operational | Supply | Power supply
32 | D9 | VDD | 1V35 | 1.35V, 1.283–1.45V operational | Supply | Power supply
33 | G7 | VDD | 1V35 | 1.35V, 1.283–1.45V operational | Supply | Power supply
34 | K2 | VDD | 1V35 | 1.35V, 1.283–1.45V operational | Supply | Power supply
35 | K8 | VDD | 1V35 | 1.35V, 1.283–1.45V operational | Supply | Power supply
36 | N1 | VDD | 1V35 | 1.35V, 1.283–1.45V operational | Supply | Power supply
37 | N9 | VDD | 1V35 | 1.35V, 1.283–1.45V operational | Supply | Power supply
38 | R1 | VDD | 1V35 | 1.35V, 1.283–1.45V operational | Supply | Power supply
39 | R9 | VDD | 1V35 | 1.35V, 1.283–1.45V operational | Supply | Power supply
40 | M8 | VREFCA | MVREF |  | Supply | Reference voltage for control, command, and address
41 | H1 | VREFDQ | MVREF |  | Supply | Reference voltage for data
42 | J1 | NC | NO CONNECT | NO CONNECT | - | NO CONNECT
43 | J9 | NC | NO CONNECT | NO CONNECT | - | NO CONNECT
44 | L1 | NC | NO CONNECT | NO CONNECT | - | NO CONNECT
45 | L9 | NC | NO CONNECT | NO CONNECT | - | NO CONNECT
46 | M7 | NC | NO CONNECT | NO CONNECT | - | NO CONNECT
47 | T7 | NC | NO CONNECT | NO CONNECT | - | NO CONNECT
48 | L8 | ZQ | GND | 240Ω resistor (RZQ), which is tied to VSSQ |  | External reference ball for output drive calibration
49 | T3 | A13 | DDR_MA13 | Input | Input | Address inputs
50 | N7 | A12/BC# | DDR_MA12 | Input | Input | Address inputs
51 | R7 | A11 | DDR_MA11 | Input | Input | Address inputs
52 | L7 | A10/AP | DDR_MA10 | Input | Input | Address inputs
53 | R3 | A9 | DDR_MA9 | Input | Input | Address inputs
54 | T8 | A8 | DDR_MA8 | Input | Input | Address inputs
55 | R2 | A7 | DDR_MA7 | Input | Input | Address inputs
56 | R8 | A6 | DDR_MA6 | Input | Input | Address inputs
57 | P2 | A5 | DDR_MA5 | Input | Input | Address inputs
58 | P8 | A4 | DDR_MA4 | Input | Input | Address inputs
59 | N2 | A3 | DDR_MA3 | Input | Input | Address inputs
60 | P3 | A2 | DDR_MA2 | Input | Input | Address inputs
61 | P7 | A1 | DDR_MA1 | Input | Input | Address inputs
62 | N3 | A0 | DDR_MA0 | Input | Input | Address inputs
63 | M3 | BA2 | DDR_MBA2 | Input | Input | Address inputs
64 | N8 | BA1 | DDR_MBA1 | Input | Input | Address inputs
65 | M2 | BA0 | DDR_MBA0 | Input | Input | Address inputs
66 | J3 | RAS# | DDR_MRAS_N | Command inputs | Input | Command inputs
67 | K3 | CAS# | DDR_MCAS_N | Command inputs | Input | Command inputs
68 | E3 | DQ0 | DDR_DQ16 | Data input/output | I/O | Data input/output
69 | F7 | DQ1 | DDR_DQ17 | Data input/output | I/O | Data input/output
70 | F2 | DQ2 | DDR_DQ18 | Data input/output | I/O | Data input/output
71 | F8 | DQ3 | DDR_DQ19 | Data input/output | I/O | Data input/output
72 | H3 | DQ4 | DDR_DQ20 | Data input/output | I/O | Data input/output
73 | H8 | DQ5 | DDR_DQ21 | Data input/output | I/O | Data input/output
74 | G2 | DQ6 | DDR_DQ22 | Data input/output | I/O | Data input/output
75 | H7 | DQ7 | DDR_DQ23 | Data input/output | I/O | Data input/output
76 | D7 | DQ8 | DDR_DQ24 | Data input/output | I/O | Data input/output
77 | C3 | DQ9 | DDR_DQ25 | Data input/output | I/O | Data input/output
78 | C8 | DQ10 | DDR_DQ26 | Data input/output | I/O | Data input/output
79 | C2 | DQ11 | DDR_DQ27 | Data input/output | I/O | Data input/output
80 | A7 | DQ12 | DDR_DQ28 | Data input/output | I/O | Data input/output
81 | A2 | DQ13 | DDR_DQ29 | Data input/output | I/O | Data input/output
82 | B8 | DQ14 | DDR_DQ30 | Data input/output | I/O | Data input/output
83 | A3 | DQ15 | DDR_DQ31 | Data input/output | I/O | Data input/output
84 | F3 | LDQS | DDR_MDQS2_P | Lower byte data strobe | I/O | Lower byte data strobe
85 | G3 | LDQS# | DDR_MDQS2_N | Lower byte data strobe | I/O | Lower byte data strobe
86 | C7 | UDQS | DDR_MDQS3_P | Upper byte data strobe | I/O | Upper byte data strobe
87 | B7 | UDQS# | DDR_MDQS3_N | Upper byte data strobe | I/O | Upper byte data strobe
88 | E7 | LDM | DDR_MDM2 | Input data mask | Input | Input data mask
89 | D3 | UDM | DDR_MDM3 | Input data mask | Input | Input data mask
90 | J7 | CK | DDR_MCK0_P | Clock | Input | Clock
91 | K7 | CK# | DDR_MCK0_N | Clock | Input | Clock
92 | K9 | CKE | DDR_MCKE0 | Clock enable | Input | Clock enable
93 | L2 | CS# | DDR_MCS0_N | Chip select | Input | Chip select
94 | L3 | WE# | DDR_MWE_N | Command inputs | Input | Command inputs
95 | T2 | RESET# | DDR_RST_N | Reset | Input | Reset
96 | K1 | ODT | D1_MODT0 | On-die termination | Input | On-die termination
MT41K128M16JT-125-AATK (U4)
1 | A1 | VDDQ | 1V35 | 1.35V, 1.283–1.45V operational | Supply | DQ power supply
2 | A8 | VDDQ | 1V35 | 1.35V, 1.283–1.45V operational | Supply | DQ power supply
3 | C1 | VDDQ | 1V35 | 1.35V, 1.283–1.45V operational | Supply | DQ power supply
4 | C9 | VDDQ | 1V35 | 1.35V, 1.283–1.45V operational | Supply | DQ power supply
5 | D2 | VDDQ | 1V35 | 1.35V, 1.283–1.45V operational | Supply | DQ power supply
6 | E9 | VDDQ | 1V35 | 1.35V, 1.283–1.45V operational | Supply | DQ power supply
7 | F1 | VDDQ | 1V35 | 1.35V, 1.283–1.45V operational | Supply | DQ power supply
8 | H2 | VDDQ | 1V35 | 1.35V, 1.283–1.45V operational | Supply | DQ power supply
9 | H9 | VDDQ | 1V35 | 1.35V, 1.283–1.45V operational | Supply | DQ power supply
10 | B1 | VSSQ | Ground | Ground | Supply | DQ ground | Isolated on the device
11 | B9 | VSSQ | Ground | Ground | Supply | DQ ground | Isolated on the device
12 | D1 | VSSQ | Ground | Ground | Supply | DQ ground | Isolated on the device
13 | D8 | VSSQ | Ground | Ground | Supply | DQ ground | Isolated on the device
14 | E2 | VSSQ | Ground | Ground | Supply | DQ ground | Isolated on the device
15 | E8 | VSSQ | Ground | Ground | Supply | DQ ground | Isolated on the device
16 | F9 | VSSQ | Ground | Ground | Supply | DQ ground | Isolated on the device
17 | G1 | VSSQ | Ground | Ground | Supply | DQ ground | Isolated on the device
18 | G9 | VSSQ | Ground | Ground | Supply | DQ ground | Isolated on the device
19 | A9 | VSS | Ground | Ground | Supply | Ground
20 | B3 | VSS | Ground | Ground | Supply | Ground
21 | E1 | VSS | Ground | Ground | Supply | Ground
22 | G8 | VSS | Ground | Ground | Supply | Ground
23 | J2 | VSS | Ground | Ground | Supply | Ground
24 | J8 | VSS | Ground | Ground | Supply | Ground
25 | M1 | VSS | Ground | Ground | Supply | Ground
26 | M9 | VSS | Ground | Ground | Supply | Ground
27 | P1 | VSS | Ground | Ground | Supply | Ground
28 | P9 | VSS | Ground | Ground | Supply | Ground
29 | T1 | VSS | Ground | Ground | Supply | Ground
30 | T9 | VSS | Ground | Ground | Supply | Ground
31 | B2 | VDD | 1V35 | 1.35V, 1.283–1.45V operational | Supply | Power supply
32 | D9 | VDD | 1V35 | 1.35V, 1.283–1.45V operational | Supply | Power supply
33 | G7 | VDD | 1V35 | 1.35V, 1.283–1.45V operational | Supply | Power supply
34 | K2 | VDD | 1V35 | 1.35V, 1.283–1.45V operational | Supply | Power supply
35 | K8 | VDD | 1V35 | 1.35V, 1.283–1.45V operational | Supply | Power supply
36 | N1 | VDD | 1V35 | 1.35V, 1.283–1.45V operational | Supply | Power supply
37 | N9 | VDD | 1V35 | 1.35V, 1.283–1.45V operational | Supply | Power supply
38 | R1 | VDD | 1V35 | 1.35V, 1.283–1.45V operational | Supply | Power supply
39 | R9 | VDD | 1V35 | 1.35V, 1.283–1.45V operational | Supply | Power supply
40 | M8 | VREFCA | MVREF |  | Supply | Reference voltage for control, command, and address
41 | H1 | VREFDQ | MVREF |  | Supply | Reference voltage for data
42 | J1 | NC | NO CONNECT | NO CONNECT | - | NO CONNECT
43 | J9 | NC | NO CONNECT | NO CONNECT | - | NO CONNECT
44 | L1 | NC | NO CONNECT | NO CONNECT | - | NO CONNECT
45 | L9 | NC | NO CONNECT | NO CONNECT | - | NO CONNECT
46 | M7 | NC | NO CONNECT | NO CONNECT | - | NO CONNECT
47 | T7 | NC | NO CONNECT | NO CONNECT | - | NO CONNECT
48 | L8 | ZQ | GND | 240Ω resistor (RZQ), which is tied to VSSQ |  | External reference ball for output drive calibration
49 | T3 | A13 | DDR_MA13 | Input | Input | Address inputs
50 | N7 | A12/BC# | DDR_MA12 | Input | Input | Address inputs
51 | R7 | A11 | DDR_MA11 | Input | Input | Address inputs
52 | L7 | A10/AP | DDR_MA10 | Input | Input | Address inputs
53 | R3 | A9 | DDR_MA9 | Input | Input | Address inputs
54 | T8 | A8 | DDR_MA8 | Input | Input | Address inputs
55 | R2 | A7 | DDR_MA7 | Input | Input | Address inputs
56 | R8 | A6 | DDR_MA6 | Input | Input | Address inputs
57 | P2 | A5 | DDR_MA5 | Input | Input | Address inputs
58 | P8 | A4 | DDR_MA4 | Input | Input | Address inputs
59 | N2 | A3 | DDR_MA3 | Input | Input | Address inputs
60 | P3 | A2 | DDR_MA2 | Input | Input | Address inputs
61 | P7 | A1 | DDR_MA1 | Input | Input | Address inputs
62 | N3 | A0 | DDR_MA0 | Input | Input | Address inputs
63 | M3 | BA2 | DDR_MBA2 | Input | Input | Address inputs
64 | N8 | BA1 | DDR_MBA1 | Input | Input | Address inputs
65 | M2 | BA0 | DDR_MBA0 | Input | Input | Address inputs
66 | J3 | RAS# | DDR_MRAS_N | Command inputs | Input | Command inputs
67 | K3 | CAS# | DDR_MCAS_N | Command inputs | Input | Command inputs
68 | E3 | DQ0 | DDR_DQ32 | Data input/output | I/O | Data input/output
69 | F7 | DQ1 | DDR_DQ33 | Data input/output | I/O | Data input/output
70 | F2 | DQ2 | DDR_DQ34 | Data input/output | I/O | Data input/output
71 | F8 | DQ3 | DDR_DQ35 | Data input/output | I/O | Data input/output
72 | H3 | DQ4 | DDR_DQ36 | Data input/output | I/O | Data input/output
73 | H8 | DQ5 | DDR_DQ37 | Data input/output | I/O | Data input/output
74 | G2 | DQ6 | DDR_DQ38 | Data input/output | I/O | Data input/output
75 | H7 | DQ7 | DDR_DQ39 | Data input/output | I/O | Data input/output
76 | D7 | DQ8 | DDR_DQ40 | Data input/output | I/O | Data input/output
77 | C3 | DQ9 | DDR_DQ41 | Data input/output | I/O | Data input/output
78 | C8 | DQ10 | DDR_DQ42 | Data input/output | I/O | Data input/output
79 | C2 | DQ11 | DDR_DQ43 | Data input/output | I/O | Data input/output
80 | A7 | DQ12 | DDR_DQ44 | Data input/output | I/O | Data input/output
81 | A2 | DQ13 | DDR_DQ45 | Data input/output | I/O | Data input/output
82 | B8 | DQ14 | DDR_DQ46 | Data input/output | I/O | Data input/output
83 | A3 | DQ15 | DDR_DQ47 | Data input/output | I/O | Data input/output
84 | F3 | LDQS | DDR_MDQS4_P | Lower byte data strobe | I/O | Lower byte data strobe
85 | G3 | LDQS# | DDR_MDQS4_N | Lower byte data strobe | I/O | Lower byte data strobe
86 | C7 | UDQS | DDR_MDQS5_P | Upper byte data strobe | I/O | Upper byte data strobe
87 | B7 | UDQS# | DDR_MDQS5_N | Upper byte data strobe | I/O | Upper byte data strobe
88 | E7 | LDM | DDR_MDM4 | Input data mask | Input | Input data mask
89 | D3 | UDM | DDR_MDM5 | Input data mask | Input | Input data mask
90 | J7 | CK | DDR_MCK0_P | Clock | Input | Clock
91 | K7 | CK# | DDR_MCK0_N | Clock | Input | Clock
92 | K9 | CKE | DDR_MCKE0 | Clock enable | Input | Clock enable
93 | L2 | CS# | DDR_MCS0_N | Chip select | Input | Chip select
94 | L3 | WE# | DDR_MWE_N | Command inputs | Input | Command inputs
95 | T2 | RESET# | DDR_RST_N | Reset | Input | Reset
96 | K1 | ODT | D1_MODT0 | On-die termination | Input | On-die termination
MT41K128M16JT-125-AATK (U5)
1 | A1 | VDDQ | 1V35 | 1.35V, 1.283–1.45V operational | Supply | DQ power supply
2 | A8 | VDDQ | 1V35 | 1.35V, 1.283–1.45V operational | Supply | DQ power supply
3 | C1 | VDDQ | 1V35 | 1.35V, 1.283–1.45V operational | Supply | DQ power supply
4 | C9 | VDDQ | 1V35 | 1.35V, 1.283–1.45V operational | Supply | DQ power supply
5 | D2 | VDDQ | 1V35 | 1.35V, 1.283–1.45V operational | Supply | DQ power supply
6 | E9 | VDDQ | 1V35 | 1.35V, 1.283–1.45V operational | Supply | DQ power supply
7 | F1 | VDDQ | 1V35 | 1.35V, 1.283–1.45V operational | Supply | DQ power supply
8 | H2 | VDDQ | 1V35 | 1.35V, 1.283–1.45V operational | Supply | DQ power supply
9 | H9 | VDDQ | 1V35 | 1.35V, 1.283–1.45V operational | Supply | DQ power supply
10 | B1 | VSSQ | Ground | Ground | Supply | DQ ground | Isolated on the device
11 | B9 | VSSQ | Ground | Ground | Supply | DQ ground | Isolated on the device
12 | D1 | VSSQ | Ground | Ground | Supply | DQ ground | Isolated on the device
13 | D8 | VSSQ | Ground | Ground | Supply | DQ ground | Isolated on the device
14 | E2 | VSSQ | Ground | Ground | Supply | DQ ground | Isolated on the device
15 | E8 | VSSQ | Ground | Ground | Supply | DQ ground | Isolated on the device
16 | F9 | VSSQ | Ground | Ground | Supply | DQ ground | Isolated on the device
17 | G1 | VSSQ | Ground | Ground | Supply | DQ ground | Isolated on the device
18 | G9 | VSSQ | Ground | Ground | Supply | DQ ground | Isolated on the device
19 | A9 | VSS | Ground | Ground | Supply | Ground
20 | B3 | VSS | Ground | Ground | Supply | Ground
21 | E1 | VSS | Ground | Ground | Supply | Ground
22 | G8 | VSS | Ground | Ground | Supply | Ground
23 | J2 | VSS | Ground | Ground | Supply | Ground
24 | J8 | VSS | Ground | Ground | Supply | Ground
25 | M1 | VSS | Ground | Ground | Supply | Ground
26 | M9 | VSS | Ground | Ground | Supply | Ground
27 | P1 | VSS | Ground | Ground | Supply | Ground
28 | P9 | VSS | Ground | Ground | Supply | Ground
29 | T1 | VSS | Ground | Ground | Supply | Ground
30 | T9 | VSS | Ground | Ground | Supply | Ground
31 | B2 | VDD | 1V35 | 1.35V, 1.283–1.45V operational | Supply | Power supply
32 | D9 | VDD | 1V35 | 1.35V, 1.283–1.45V operational | Supply | Power supply
33 | G7 | VDD | 1V35 | 1.35V, 1.283–1.45V operational | Supply | Power supply
34 | K2 | VDD | 1V35 | 1.35V, 1.283–1.45V operational | Supply | Power supply
35 | K8 | VDD | 1V35 | 1.35V, 1.283–1.45V operational | Supply | Power supply
36 | N1 | VDD | 1V35 | 1.35V, 1.283–1.45V operational | Supply | Power supply
37 | N9 | VDD | 1V35 | 1.35V, 1.283–1.45V operational | Supply | Power supply
38 | R1 | VDD | 1V35 | 1.35V, 1.283–1.45V operational | Supply | Power supply
39 | R9 | VDD | 1V35 | 1.35V, 1.283–1.45V operational | Supply | Power supply
40 | M8 | VREFCA | MVREF |  | Supply | Reference voltage for control, command, and address
41 | H1 | VREFDQ | MVREF |  | Supply | Reference voltage for data
42 | J1 | NC | NO CONNECT | NO CONNECT | - | NO CONNECT
43 | J9 | NC | NO CONNECT | NO CONNECT | - | NO CONNECT
44 | L1 | NC | NO CONNECT | NO CONNECT | - | NO CONNECT
45 | L9 | NC | NO CONNECT | NO CONNECT | - | NO CONNECT
46 | M7 | NC | NO CONNECT | NO CONNECT | - | NO CONNECT
47 | T7 | NC | NO CONNECT | NO CONNECT | - | NO CONNECT
48 | L8 | ZQ | GND | 240Ω resistor (RZQ), which is tied to VSSQ |  | External reference ball for output drive calibration
49 | T3 | A13 | DDR_MA13 | Input | Input | Address inputs
50 | N7 | A12/BC# | DDR_MA12 | Input | Input | Address inputs
51 | R7 | A11 | DDR_MA11 | Input | Input | Address inputs
52 | L7 | A10/AP | DDR_MA10 | Input | Input | Address inputs
53 | R3 | A9 | DDR_MA9 | Input | Input | Address inputs
54 | T8 | A8 | DDR_MA8 | Input | Input | Address inputs
55 | R2 | A7 | DDR_MA7 | Input | Input | Address inputs
56 | R8 | A6 | DDR_MA6 | Input | Input | Address inputs
57 | P2 | A5 | DDR_MA5 | Input | Input | Address inputs
58 | P8 | A4 | DDR_MA4 | Input | Input | Address inputs
59 | N2 | A3 | DDR_MA3 | Input | Input | Address inputs
60 | P3 | A2 | DDR_MA2 | Input | Input | Address inputs
61 | P7 | A1 | DDR_MA1 | Input | Input | Address inputs
62 | N3 | A0 | DDR_MA0 | Input | Input | Address inputs
63 | M3 | BA2 | DDR_MBA2 | Input | Input | Address inputs
64 | N8 | BA1 | DDR_MBA1 | Input | Input | Address inputs
65 | M2 | BA0 | DDR_MBA0 | Input | Input | Address inputs
66 | J3 | RAS# | DDR_MRAS_N | Command inputs | Input | Command inputs
67 | K3 | CAS# | DDR_MCAS_N | Command inputs | Input | Command inputs
68 | E3 | DQ0 | DDR_DQ48 | Data input/output | I/O | Data input/output
69 | F7 | DQ1 | DDR_DQ49 | Data input/output | I/O | Data input/output
70 | F2 | DQ2 | DDR_DQ50 | Data input/output | I/O | Data input/output
71 | F8 | DQ3 | DDR_DQ51 | Data input/output | I/O | Data input/output
72 | H3 | DQ4 | DDR_DQ52 | Data input/output | I/O | Data input/output
73 | H8 | DQ5 | DDR_DQ53 | Data input/output | I/O | Data input/output
74 | G2 | DQ6 | DDR_DQ54 | Data input/output | I/O | Data input/output
75 | H7 | DQ7 | DDR_DQ55 | Data input/output | I/O | Data input/output
76 | D7 | DQ8 | DDR_DQ56 | Data input/output | I/O | Data input/output
77 | C3 | DQ9 | DDR_DQ57 | Data input/output | I/O | Data input/output
78 | C8 | DQ10 | DDR_DQ58 | Data input/output | I/O | Data input/output
79 | C2 | DQ11 | DDR_DQ59 | Data input/output | I/O | Data input/output
80 | A7 | DQ12 | DDR_DQ60 | Data input/output | I/O | Data input/output
81 | A2 | DQ13 | DDR_DQ61 | Data input/output | I/O | Data input/output
82 | B8 | DQ14 | DDR_DQ62 | Data input/output | I/O | Data input/output
83 | A3 | DQ15 | DDR_DQ63 | Data input/output | I/O | Data input/output
84 | F3 | LDQS | DDR_MDQS6_P | Lower byte data strobe | I/O | Lower byte data strobe
85 | G3 | LDQS# | DDR_MDQS6_N | Lower byte data strobe | I/O | Lower byte data strobe
86 | C7 | UDQS | DDR_MDQS7_P | Upper byte data strobe | I/O | Upper byte data strobe
87 | B7 | UDQS# | DDR_MDQS7_N | Upper byte data strobe | I/O | Upper byte data strobe
88 | E7 | LDM | DDR_MDM6 | Input data mask | Input | Input data mask
89 | D3 | UDM | DDR_MDM7 | Input data mask | Input | Input data mask
90 | J7 | CK | DDR_MCK0_P | Clock | Input | Clock
91 | K7 | CK# | DDR_MCK0_N | Clock | Input | Clock
92 | K9 | CKE | DDR_MCKE0 | Clock enable | Input | Clock enable
93 | L2 | CS# | DDR_MCS0_N | Chip select | Input | Chip select
94 | L3 | WE# | DDR_MWE_N | Command inputs | Input | Command inputs
95 | T2 | RESET# | DDR_RST_N | Reset | Input | Reset
96 | K1 | ODT | D1_MODT0 | On-die termination | Input | On-die termination

Sheet: IFC Interface
Schematics Review - T1020 based 12 port AFDX switch
IFC Interface schematics from datasheet
S. No | PIN | SIGNAL | IN SCHEMATICS | IN DATASHEET | DESCRIPTION | COMMENTS
SN74LVC16373ADL (U6)
1 | 1D1 | 47 | IFC_AD5 |  | Input
2 | 1D2 | 46 | IFC_AD6 |  | Input
3 | 1D3 | 44 | IFC_AD7 |  | Input
4 | 1D4 | 43 | IFC_AD8 |  | Input
5 | 1D5 | 41 | IFC_AD9 |  | Input
6 | 1D6 | 40 | IFC_AD10 |  | Input
7 | 1D7 | 38 | IFC_AD11 |  | Input
8 | 1D8 | 37 | IFC_AD12 |  | Input
9 | LE1 | 48 | IFC_AVD |  | Latch Enable 1
10 | OE1/ | 1 | Ground |  | Output Enable 1
11 | 2D1 | 36 | IFC_AD13 |  | Input
12 | 2D2 | 35 | IFC_AD14 |  | Input
13 | 2D3 | 33 | IFC_AD15 |  | Input
14 | 2D4 | 32 | Ground |  | Input
15 | 2D5 | 30 | Ground |  | Input
16 | 2D6 | 29 | Ground |  | Input
17 | 2D7 | 27 | Ground |  | Input
18 | 2D8 | 26 | Ground |  | Input
19 | LE2 | 25 | IFC_AVD |  | Latch Enable 2
20 | OE2/ | 24 | Ground |  | Output Enable 2
21 | VCC | 7 | OVDD |  | Power
22 | VCC | 18 | OVDD |  | Power
23 | VCC | 31 | OVDD |  | Power
24 | VCC | 42 | OVDD |  | Power
25 | 1Q1 | 2 | IFC_A5 |  | Output
26 | 1Q2 | 3 | IFC_A6 |  | Output
27 | 1Q3 | 5 | IFC_A7 |  | Output
28 | 1Q4 | 6 | IFC_A8 |  | Output
29 | 1Q5 | 8 | IFC_A9 |  | Output
30 | 1Q6 | 9 | IFC_A10 |  | Output
31 | 1Q7 | 11 | IFC_A11 |  | Output
32 | 1Q8 | 12 | IFC_A12 |  | Output
33 | 2Q1 | 13 | IFC_A13 |  | Output
34 | 2Q2 | 14 | IFC_A14 |  | Output
35 | 2Q3 | 16 | IFC_A15 |  | Output
36 | 2Q4 | 17 | NO CONNECT |  | Output
37 | 2Q5 | 19 | NO CONNECT |  | Output
38 | 2Q6 | 20 | NO CONNECT |  | Output
39 | 2Q7 | 22 | NO CONNECT |  | Output
40 | 2Q8 | 23 | NO CONNECT |  | Output
41 | GND | 4 | Ground |  | Ground
42 | GND | 10 | Ground |  | Ground
43 | GND | 15 | Ground |  | Ground
44 | GND | 21 | Ground |  | Ground
45 | GND | 28 | Ground |  | Ground
46 | GND | 34 | Ground |  | Ground
47 | GND | 39 | Ground |  | Ground
48 | GND | 45 | Ground |  | Ground

Sheet: Flash Reset
Schematics Review - T1020 based 12 port AFDX switch
Flash Reset schematics from datasheet
S. No | PIN | SIGNAL | IN SCHEMATICS | IN DATASHEET | DESCRIPTION | COMMENTS
JS28F00AM29EWHA (U9)
1 | 16 | VPP//WP | OVDD
2 | 31 | A0 | IFC_A30
3 | 26 | A1 | IFC_A29
4 | 25 | A2 | IFC_A28
5 | 24 | A3 | IFC_A27
6 | 23 | A4 | IFC_A26
7 | 22 | A5 | IFC_A25
8 | 21 | A6 | IFC_A24
9 | 20 | A7 | IFC_A23
10 | 10 | A8 | IFC_A22
11 | 9 | A9 | IFC_A21
12 | 8 | A10 | IFC_A20
13 | 7 | A11 | IFC_A19
14 | 6 | A12 | IFC_A18
15 | 5 | A13 | IFC_A17
16 | 4 | A14 | IFC_A16
17 | 3 | A15 | IFC_A15
18 | 54 | A16 | IFC_A14
19 | 19 | A17 | IFC_A13
20 | 18 | A18 | IFC_A12
21 | 11 | A19 | IFC_A11
22 | 12 | A20 | IFC_A10
23 | 15 | A21 | IFC_A9
24 | 2 | A22 | IFC_A8
25 | 1 | A23 | IFC_A7
26 | 56 | A24 | IFC_A6
27 | 55 | A25 | IFC_A5
28 | 32 | /CE | IFC_CS0_N/OVDD
29 | 34 | /OE | IFC_OE_N
30 | 13 | /WE | IFC_WE_N
31 | 14 | /RST | NOR_RST_N/OVDD
32 | 53 | /BYTE | OVDD
33 | 35 | DQ0 | IFC_AD15
34 | 37 | DQ1 | IFC_AD14
35 | 39 | DQ2 | IFC_AD13
36 | 41 | DQ3 | IFC_AD12
37 | 44 | DQ4 | IFC_AD11
38 | 46 | DQ5 | IFC_AD10
39 | 48 | DQ6 | IFC_AD9
40 | 50 | DQ7 | IFC_AD8
41 | 36 | DQ8 | IFC_AD7
42 | 38 | DQ9 | IFC_AD6
43 | 40 | DQ10 | IFC_AD5
44 | 42 | DQ11 | IFC_AD4
45 | 45 | DQ12 | IFC_AD3
46 | 47 | DQ13 | IFC_AD2
47 | 49 | DQ14 | IFC_AD1
48 | 51 | DQ15/A-1 | IFC_AD0
49 | 17 | RY//BY | OVDD
50 | 28 | RFU1 | NO CONNECT
51 | 27 | RFU2 | NO CONNECT
52 | 30 | RFU3 | NO CONNECT
53 | 33 | VSS1 | GND
54 | 52 | VSS2 | GND
55 | 43 | VCC | 3V3
56 | 29 | VCCQ | OVDD

Sheet: System Logic Interface
Schematics Review - T1020 based 12 port AFDX switch
System Logic Interface schematics from datasheet
S. No | PIN | SIGNAL | IN SCHEMATICS | IN DATASHEET | DESCRIPTION | COMMENTS
HTST-108-01-L-DV (J1)
1 | 1 |  | COP_TDO
2 | 3 |  | COP_TDI
3 | 5
4 | 7 |  | COP_TCK
5 | 9 |  | COP_TMS
6 | 11
7 | 13
8 | 15 |  | COP_CKSTP_OUT_N
9 | 2 |  | NO CONNECT
10 | 4
11 | 6
12 | 8 |  | NO CONNECT
13 | 10 |  | NO CONNECT
14 | 12
15 | 14 |  | NO CONNECT
16 | 16
TXB0106PWR (U12)
1 | 2 | VCCA | OVDD
2 | 1 | A1 | JTAG_TDI
3 | 3 | A2 | JTAG_TDO
4 | 4 | A3 | JTAG_TCK
5 | 5 | A4 | JTAG_TMS
6 | 6 | A5 | CKSTP_OUT_N
7 | 7 | A6 | NO CONNECT
8 | 8 | OE | OVDD
9 | 15 | VCCB | 3V3
10 | 16 | B1 | COP_TDI
11 | 14 | B2 | COP_TDO
12 | 13 | B3 | COP_TCK
13 | 12 | B4 | COP_TMS
14 | 11 | B5 | COP_CKSTP_OUT_N
15 | 10 | B6 | NO CONNECT
16 | 9 | GND | GND

Sheet: QE & USB Interface
Schematics Review - T1020 based 12 port AFDX switch
QE & USB Interface schematics from datasheet
S. No | PIN | SIGNAL | IN SCHEMATICS | IN DATASHEET | DESCRIPTION | COMMENTS
ACSL-6400 (U13)
1 | 1 | A1 | CON_DIP0
2 | 2 | C1 | DIP_LOW
3 | 3 | A2 | CON_DIP1
4 | 4 | C2 | DIP_LOW
5 | 5 | A3 | CON_DIP2
6 | 6 | C3 | DIP_LOW
7 | 7 | A4 | CON_DIP3
8 | 8 | C4 | DIP_LOW
9 | 14 | VO1 | DIP0/3V3
10 | 13 | VO2 | DIP1/3V3
11 | 12 | VO3 | DIP2/3V3
12 | 11 | VO4 | DIP3/3V3
13 | 9 | GND | GND
14 | 16 | GND | GND
15 | 15 | VDD | 3V3
16 | 10 | VDD | 3V3
ACSL-6400 (U14)
1 | 1 | A1 | CON_DIP4
2 | 2 | C1 | DIP_LOW
3 | 3 | A2 | CON_DIP5
4 | 4 | C2 | DIP_LOW
5 | 5 | A3 | CON_DIP6
6 | 6 | C3 | DIP_LOW
7 | 7 | A4 | CON_DIP7
8 | 8 | C4 | DIP_LOW
9 | 14 | VO1 | DIP4/3V3
10 | 13 | VO2 | DIP5/3V3
11 | 12 | VO3 | DIP6/3V3
12 | 11 | VO4 | DIP7/3V3
13 | 9 | GND | GND
14 | 16 | GND | GND
15 | 15 | VDD | 3V3
16 | 10 | VDD | 3V3
ACSL-6400 (U15)
1 | 1 | A1 | CON_DIP8
2 | 2 | C1 | DIP_LOW
3 | 3 | A2 | CON_DIP9
4 | 4 | C2 | DIP_LOW
5 | 5 | A3 | CON_DIP10
6 | 6 | C3 | DIP_LOW
7 | 7 | A4 | CON_DIP11
8 | 8 | C4 | DIP_LOW
9 | 14 | VO1 | DIP8/3V3
10 | 13 | VO2 | DIP9/3V3
11 | 12 | VO3 | DIP10/3V3
12 | 11 | VO4 | DIP11/3V3
13 | 9 | GND | GND
14 | 16 | GND | GND
15 | 15 | VDD | 3V3
16 | 10 | VDD | 3V3
ACSL-6400 (U16)
1 | 1 | A1 | CON_DIP12
2 | 2 | C1 | DIP_LOW
3 | 3 | A2 | CON_DIP13
4 | 4 | C2 | DIP_LOW
5 | 5 | A3 | CON_DIP14
6 | 6 | C3 | DIP_LOW
7 | 7 | A4 | CON_DIP15
8 | 8 | C4 | DIP_LOW
9 | 14 | VO1 | DIP12/3V3
10 | 13 | VO2 | DIP13/3V3
11 | 12 | VO3 | DIP14/3V3
12 | 11 | VO4 | DIP15/3V3
13 | 9 | GND | GND
14 | 16 | GND | GND
15 | 15 | VDD | 3V3
16 | 10 | VDD | 3V3
ACSL-6400 (U17)
1 | 1 | A1 | CON_DIP16
2 | 2 | C1 | DIP_LOW
3 | 3 | A2 | CON_DIP17
4 | 4 | C2 | DIP_LOW
5 | 5 | A3 | CON_DIP18
6 | 6 | C3 | DIP_LOW
7 | 7 | A4 | CON_DIP19
8 | 8 | C4 | DIP_LOW
9 | 14 | VO1 | DIP16/3V3
10 | 13 | VO2 | DIP17/3V3
11 | 12 | VO3 | DIP18/3V3
12 | 11 | VO4 | DIP19/3V3
13 | 9 | GND | GND
14 | 16 | GND | GND
15 | 15 | VDD | 3V3
16 | 10 | VDD | 3V3

Sheet: RGMII PHY
Schematics Review - T1020 based 12 port AFDX switch
RGMII PHY schematics from datasheet
S. No | PIN | SIGNAL | IN SCHEMATICS | IN DATASHEET | DESCRIPTION | COMMENTS
1 | H16 | RGMII0_RXCLK | EC1_RXCLK
2 | L15 | RGMII0_RXD0 | EC1_RXD0
3 | L16 | RGMII0_RXD1 | EC1_RXD1
4 | M15 | RGMII0_RXD2 | EC1_RXD2
5 | M16 | RGMII0_RXD3 | EC1_RXD3
6 | J13 | RGMII0_RXCTL | EC1_RXCTL
7 | K4 | RGMII1_RXCLK | EC2_RXCLK
8 | J13 | RGMII1_RXD0 | EC2_RXD0
9 | J2 | RGMII1_RXD1 | EC2_RXD1
10 | J3 | RGMII1_RXD2 | EC2_RXD2
11 | J4 | RGMII1_RXD3 | EC2_RXD3
12 | K3 | RGMII1_RXCTL | EC2_RXCTL
13 | G15 | RGMII0_TXCLK | EC1_GTXCLK
14 | F15 | RGMII0_TXD0 | EC1_TXD0
15 | F13 | RGMII0_TXD1 | EC1_TXD1
16 | E14 | RGMII0_TXD2 | EC1_TXD2
17 | D14 | RGMII0_TXD3 | EC1_TXD3
18 | H15 | RGMII0_TXCTL | EC1_TXCTL
19 | K1 | RGMII1_TXCLK | EC2_GTXCLK
20 | L1 | RGMII1_TXD0 | EC2_TXD0
21 | M1 | RGMII1_TXD1 | EC2_TXD1
22 | N1 | RGMII1_TXD2 | EC2_TXD2
23 | P1 | RGMII1_TXD3 | EC2_TXD3
24 | K2 | RGMII1_TXCTL | EC2_TXCTL
25 | A2 | N/C | NO CONNECT
26 | A3 | N/C | NO CONNECT
27 | A4 | N/C | NO CONNECT
28 | A5 | N/C | NO CONNECT
29 | A6 | N/C | NO CONNECT
30 | A7 | N/C | NO CONNECT
31 | A8 | N/C | NO CONNECT
32 | A9 | N/C | NO CONNECT
33 | B2 | N/C | NO CONNECT
34 | B3 | N/C | NO CONNECT
35 | B4 | N/C | NO CONNECT
36 | B5 | N/C | NO CONNECT
37 | B6 | N/C | NO CONNECT
38 | B7 | N/C | NO CONNECT
39 | B8 | N/C | NO CONNECT
40 | B9 | N/C | NO CONNECT
41 | R2 | N/C | NO CONNECT
42 | R3 | N/C | NO CONNECT
43 | R4 | N/C | NO CONNECT
44 | R5 | N/C | NO CONNECT
45 | R6 | N/C | NO CONNECT
46 | R7 | N/C | NO CONNECT
47 | R8 | N/C | NO CONNECT
48 | R9 | N/C | NO CONNECT
49 | T2 | N/C | NO CONNECT
50 | T3 | N/C | NO CONNECT
51 | T4 | N/C | NO CONNECT
52 | T5 | N/C | NO CONNECT
53 | T6 | N/C | NO CONNECT
54 | T7 | N/C | NO CONNECT
55 | T8 | N/C | NO CONNECT
56 | T9 | N/C | NO CONNECT
57 | E5 | VDD1
58 | E12 | VDD1
59 | F5 | VDD1
60 | F12 | VDD1
61 | G5 | VDD1
62 | G12 | VDD1
63 | H5 | VDD1
64 | H12 | VDD1
65 | J5 | VDD1
66 | J12 | VDD1
67 | K5 | VDD1
68 | K12 | VDD1
69 | L5 | VDD1
70 | L12 | VDD1
71 | M5 | VDD1
72 | M12 | VDD1
73 | N5 | VDD1
74 | N12 | VDD1
75 | P3 | VDD25
76 | M4 | VDD25
77 | H13 | VDD25
78 | M13 | VDD25
79 | C7 | VDD1A
80 | C8 | VDD1A
81 | C9 | VDD1A
82 | C13 | VDD1A
83 | P6 | VDD1A
84 | P7 | VDD1A
85 | P8 | VDD1A
86 | P9 | VDD1A
87 | P10 | VDD1A
88 | P11 | VDD1A
89 | C2 | VDD25A
90 | C4 | VDD25A
91 | C6 | VDD25A
92 | C11 | VDD25A
93 | C14 | VDD25A
94 | E4 | VDD25A
95 | E13 | VDD25A
96 | P5 | VDD25A
97 | P12 | VDD25A
98 | P13 | VDD25A
99 | D1 | REFCLK+ | RGPHY_REFCLK_P
100 | C1 | REFCLK- | RGPHY_REFCLK_N
101 | D3 | REF_FILT | GND
102 | D4 | REF_REXT | GND
103 | E1 | REFCLK_SEL2 | NO CONNECT
104 | N13 | SERDES_REXT0
105 | P14 | SERDES_REXT1
106 | N14 | GPIO0/SIGDET0 | NO CONNECT
107 | M14 | GPIO1/SIGDET1 | NO CONNECT
108 | L13 | GPIO4/I2C_SCL0 | NO CONNECT
109 | L14 | GPIO5/I2C_SCL1 | NO CONNECT
110 | K13 | GPIO8/I2C_SDA | NO CONNECT
111 | K14 | GPIO9/FASTLINKFAIL | NO CONNECT
112 | F3 | TCK | NO CONNECT
113 | F2 | TDI | NO CONNECT
114 | F1 | TDO | NO CONNECT
115 | E2 | TMS | NO CONNECT
116 | E3 | TRSTB
117 | C3 | VSS/THERMDA
118 | D2 | VSS/ERMDC
119 | A1 | NC1 | NO CONNECT
120 | A16 | NC2 | NO CONNECT
121 | L4 | NC4/HSTST_P | NO CONNECT
122 | P4 | NC5/HSTST_N | NO CONNECT
123 | T1 | NC6 | NO CONNECT
124 | T16 | NC7 | NO CONNECT
125 | F16 | RCVRD_CLK1 | EC1_REFCLK
126 | G16 | RCVRD_CLK2 | EC2_REFCLK
127 | E15 | CLK_SQUELCH_IN | NO CONNECT
128 | K16 | GPIO10/1588_PPS_0 | NO CONNECT
129 | N3 | GPIO15/1588_PPS_1 | NO CONNECT
130 | N4 | GPIO16 | NO CONNECT
131 | L2 | GPIO17 | NO CONNECT
132 | J15 | 1588_REFCLK+ | GND
133 | J16 | 1588_REFCLK- | GND
134 | K15 | GPIO11/1588_LOAD_SAVE | NO CONNECT
135 | E16 | GPIO14/1588_SPI_SCLK | NO CONNECT
136 | H14 | GPIO13/1588_SPI_MISO | NO CONNECT
137 | J14 | GPIO12/1588_SPI_SSN | NO CONNECT
138 | P2 | MDC | EMI1_MDC
139 | N2 | MDIO | EMI1_MDIO
140 | M2 | MDINT | RGMII_PHY_INT
141 | G13 | PHYAD2
142 | G14 | PHYAD3
143 | F14 | PHYAD4
144 | L3 | COMA_MODE
145 | M3 | NRESET | RGMII_RST
146 | C10 | TANA_1/RSVD1 | NO CONNECT
147 | D13 | TANA_0/RSVD2 | NO CONNECT
148 | B1 | VSS | GND
149 | B16 | VSS | GND
150 | C5 | VSS | GND
151 | C12 | VSS | GND
152 | D5 | VSS | GND
153 | D6 | VSS | GND
154 | D7 | VSS | GND
155 | D8 | VSS | GND
156 | D9 | VSS | GND
157 | D10 | VSS | GND
158 | D11 | VSS | GND
159 | D12 | VSS | GND
160 | E6 | VSS | GND
161 | E7 | VSS | GND
162 | E8 | VSS | GND
163 | E9 | VSS | GND
164 | E10 | VSS | GND
165 | E11 | VSS | GND
166 | F4 | VSS | GND
167 | F5 | VSS | GND
168 | F6 | VSS | GND
169 | F7 | VSS | GND
170 | F8 | VSS | GND
171 | F9 | VSS | GND
172 | F10 | VSS | GND
173 | F11 | VSS | GND
174 | G6 | VSS | GND
175 | G7 | VSS | GND
176 | G8 | VSS | GND
177 | G9 | VSS | GND
178 | G10 | VSS | GND
179 | G11 | VSS | GND
180 | H6 | VSS | GND
181 | H7 | VSS | GND
182 | H8 | VSS | GND
183 | H9 | VSS | GND
184 | H10 | VSS | GND
185 | H11 | VSS | GND
186 | J6 | VSS | GND
187 | J7 | VSS | GND
188 | J8 | VSS | GND
189 | J9 | VSS | GND
190 | J10 | VSS | GND
191 | J11 | VSS | GND
192 | K6 | VSS | GND
193 | K7 | VSS | GND
194 | K8 | VSS | GND
195 | K9 | VSS | GND
196 | K10 | VSS | GND
197 | K11 | VSS | GND
198 | L6 | VSS | GND
199 | L7 | VSS | GND
200 | L8 | VSS | GND
201 | L9 | VSS | GND
202 | L10 | VSS | GND
203 | L11 | VSS | GND
204 | M6 | VSS | GND
205 | M7 | VSS | GND
206 | M8 | VSS | GND
207 | M9 | VSS | GND
208 | M10 | VSS | GND
209 | M11 | VSS | GND
210 | N6 | VSS | GND
211 | N7 | VSS | GND
212 | N8 | VSS | GND
213 | N9 | VSS | GND
214 | N10 | VSS | GND
215 | N11 | VSS | GND
216 | R1 | VSS | GND
217 | R16 | VSS | GND
218 | R13 | TDINP_1 | GND
219 | T13 | TDINN_1 | GND
220 | R12 | RDOUTP_1 | NO CONNECT
221 | T12 | RDOUTN_1 | NO CONNECT
222 | H1 | LED0_1 | NO CONNECT
223 | H2 | LED1_1 | NO CONNECT
224 | H3 | LED2_1 | NO CONNECT
225 | H4 | LED3_1 | NO CONNECT
226 | A10 | TXVPA_1 | RGMII2_TXVA_P
227 | B10 | TXVNA_1 | RGMII2_TXVA_N
228 | A11 | TXVPB_1 | RGMII2_TXVB_P
229 | B11 | TXVNB_1 | RGMII2_TXVB_N
230 | A12 | TXVPC_1 | RGMII2_TXVC_P
231 | B12 | TXVNC_1 | RGMII2_TXVC_N
232 | A13 | TXVPD_1 | RGMII2_TXVD_P
233 | B13 | TXVND_1 | RGMII2_TXVD_N
234 | R11 | FIBR_DIP1 | GND
235 | T11 | FIBR_DIN1 | GND
236 | R10 | FIBR_DOP1 | NO CONNECT
237 | T10 | FIBR_DON1 | NO CONNECT
238 | N15 | TDINP_0 | GND
239 | N16 | TDINN_0 | GND
240 | P15 | RDOUTP_0 | NO CONNECT
241 | P16 | RDOUTN_0 | NO CONNECT
242 | G1 | LED0_0 | NO CONNECT
243 | G2 | LED1_0 | NO CONNECT
244 | G3 | LED2_0 | NO CONNECT
245 | G4 | LED3_0 | NO CONNECT
246 | A14 | TXVPA_0 | RGMII1_TXVA_P
247 | B14 | TXVNA_0 | RGMII1_TXVA_N
248 | A15 | TXVPB_0 | RGMII1_TXVB_P
249 | B15 | TXVNB_0 | RGMII1_TXVB_N
250 | C16 | TXVPC_0 | RGMII1_TXVC_P
251 | C15 | TXVNC_0 | RGMII1_TXVC_N
252 | D16 | TXVPD_0 | RGMII1_TXVD_P
253 | D15 | TXVND_0 | RGMII1_TXVD_N
254 | R15 | FIBR_DIP0 | GND
255 | T15 | FIBR_DIN0 | GND
256 | R14 | FIBR_DOP0 | NO CONNECT
257 | T14 | FIBR_DON0 | NO CONNECT

Sheet: SGMII PHY
Schematics Review - T1020 based 12 port AFDX switch
SGMII PHY schematics from datasheet
S. No | PIN | SIGNAL | IN SCHEMATICS | IN DATASHEET | DESCRIPTION | COMMENTS
1 | H16 | RGMII0_RXCLK | NO CONNECT
2 | L15 | RGMII0_RXD0 | NO CONNECT
3 | L16 | RGMII0_RXD1 | NO CONNECT
4 | M15 | RGMII0_RXD2 | NO CONNECT
5 | M16 | RGMII0_RXD3 | NO CONNECT
6 | J13 | RGMII0_RXCTL | NO CONNECT
7 | K4 | RGMII1_RXCLK | NO CONNECT
8 | J13 | RGMII1_RXD0 | NO CONNECT
9 | J2 | RGMII1_RXD1 | NO CONNECT
10 | J3 | RGMII1_RXD2 | NO CONNECT
11 | J4 | RGMII1_RXD3 | NO CONNECT
12 | K3 | RGMII1_RXCTL | NO CONNECT
13 | G15 | RGMII0_TXCLK | GND
14 | F15 | RGMII0_TXD0 | GND
15 | F13 | RGMII0_TXD1 | GND
16 | E14 | RGMII0_TXD2 | GND
17 | D14 | RGMII0_TXD3 | GND
18 | H15 | RGMII0_TXCTL | GND
19 | K1 | RGMII1_TXCLK | GND
20 | L1 | RGMII1_TXD0 | GND
21 | M1 | RGMII1_TXD1 | GND
22 | N1 | RGMII1_TXD2 | GND
23 | P1 | RGMII1_TXD3 | GND
24 | K2 | RGMII1_TXCTL | GND
25 | A2 | N/C | NO CONNECT
26 | A3 | N/C | NO CONNECT
27 | A4 | N/C | NO CONNECT
28 | A5 | N/C | NO CONNECT
29 | A6 | N/C | NO CONNECT
30 | A7 | N/C | NO CONNECT
31 | A8 | N/C | NO CONNECT
32 | A9 | N/C | NO CONNECT
33 | B2 | N/C | NO CONNECT
34 | B3 | N/C | NO CONNECT
35 | B4 | N/C | NO CONNECT
36 | B5 | N/C | NO CONNECT
37 | B6 | N/C | NO CONNECT
38 | B7 | N/C | NO CONNECT
39 | B8 | N/C | NO CONNECT
40 | B9 | N/C | NO CONNECT
41 | R2 | N/C | NO CONNECT
42 | R3 | N/C | NO CONNECT
43 | R4 | N/C | NO CONNECT
44 | R5 | N/C | NO CONNECT
45 | R6 | N/C | NO CONNECT
46 | R7 | N/C | NO CONNECT
47 | R8 | N/C | NO CONNECT
48 | R9 | N/C | NO CONNECT
49 | T2 | N/C | NO CONNECT
50 | T3 | N/C | NO CONNECT
51 | T4 | N/C | NO CONNECT
52 | T5 | N/C | NO CONNECT
53 | T6 | N/C | NO CONNECT
54 | T7 | N/C | NO CONNECT
55 | T8 | N/C | NO CONNECT
56 | T9 | N/C | NO CONNECT
57 | E5 | VDD1 | 1V0_PHY
58 | E12 | VDD1 | 1V0_PHY
59 | F5 | VDD1 | 1V0_PHY
60 | F12 | VDD1 | 1V0_PHY
61 | G5 | VDD1 | 1V0_PHY
62 | G12 | VDD1 | 1V0_PHY
63 | H5 | VDD1 | 1V0_PHY
64 | H12 | VDD1 | 1V0_PHY
65 | J5 | VDD1 | 1V0_PHY
66 | J12 | VDD1 | 1V0_PHY
67 | K5 | VDD1 | 1V0_PHY
68 | K12 | VDD1 | 1V0_PHY
69 | L5 | VDD1 | 1V0_PHY
70 | L12 | VDD1 | 1V0_PHY
71 | M5 | VDD1 | 1V0_PHY
72 | M12 | VDD1 | 1V0_PHY
73 | N5 | VDD1 | 1V0_PHY
74 | N12 | VDD1 | 1V0_PHY
75 | P3 | VDD25 | 2V5
76 | M4 | VDD25 | 2V6
77 | H13 | VDD25 | 2V7
78 | M13 | VDD25 | 2V8
79 | C7 | VDD1A | 1V0_SGMII/1V0_PHY
80 | C8 | VDD1A | 1V0_SGMII/1V0_PHY
81 | C9 | VDD1A | 1V0_SGMII/1V0_PHY
82 | C13 | VDD1A | 1V0_SGMII/1V0_PHY
83 | P6 | VDD1A | 1V0_SGMII/1V0_PHY
84 | P7 | VDD1A | 1V0_SGMII/1V0_PHY
85 | P8 | VDD1A | 1V0_SGMII/1V0_PHY
86 | P9 | VDD1A | 1V0_SGMII/1V0_PHY
87 | P10 | VDD1A | 1V0_SGMII/1V0_PHY
88 | P11 | VDD1A | 1V0_SGMII/1V0_PHY
89 | C2 | VDD25A | 2V5A_SGMII/2V5
90 | C4 | VDD25A | 2V5A_SGMII/2V5
91 | C6 | VDD25A | 2V5A_SGMII/2V5
92 | C11 | VDD25A | 2V5A_SGMII/2V5
93 | C14 | VDD25A | 2V5A_SGMII/2V5
94 | E4 | VDD25A | 2V5A_SGMII/2V5
95 | E13 | VDD25A | 2V5A_SGMII/2V5
96 | P5 | VDD25A | 2V5A_SGMII/2V5
97 | P12 | VDD25A | 2V5A_SGMII/2V5
98 | P13 | VDD25A | 2V5A_SGMII/2V5
99 | D1 | REFCLK+ | SGPHY_REFCLK_P
100 | C1 | REFCLK- | SGPHY_REFCLK_N
101 | D3 | REF_FILT | GND
102 | D4 | REF_REXT | GND
103 | E1 | REFCLK_SEL2 | NO CONNECT
104 | N13 | SERDES_REXT0
105 | P14 | SERDES_REXT1
106 | N14 | GPIO0/SIGDET0 | NO CONNECT
107 | M14 | GPIO1/SIGDET1 | NO CONNECT
108 | L13 | GPIO4/I2C_SCL0 | NO CONNECT
109 | L14 | GPIO5/I2C_SCL1 | NO CONNECT
110 | K13 | GPIO8/I2C_SDA | NO CONNECT
111 | K14 | GPIO9/FASTLINKFAIL | NO CONNECT
112 | F3 | TCK | NO CONNECT
113 | F2 | TDI | NO CONNECT
114 | F1 | TDO | NO CONNECT
115 | E2 | TMS | NO CONNECT
116 | E3 | TRSTB
117 | C3 | VSS/THERMDA | GND
118 | D2 | VSS/ERMDC | GND
119 | A1 | NC1 | NO CONNECT
120 | A16 | NC2 | NO CONNECT
121 | L4 | NC4/HSTST_P | NO CONNECT
122 | P4 | NC5/HSTST_N | NO CONNECT
123 | T1 | NC6 | NO CONNECT
124 | T16 | NC7 | NO CONNECT
125 | F16 | RCVRD_CLK1 | NO CONNECT
126 | G16 | RCVRD_CLK2 | NO CONNECT
127 | E15 | CLK_SQUELCH_IN | NO CONNECT
128 | K16 | GPIO10/1588_PPS_0 | NO CONNECT
129 | N3 | GPIO15/1588_PPS_1 | NO CONNECT
130 | N4 | GPIO16 | NO CONNECT
131 | L2 | GPIO17 | NO CONNECT
132 | J15 | 1588_REFCLK+ | GND
133 | J16 | 1588_REFCLK- | GND
134 | K15 | GPIO11/1588_LOAD_SAVE | NO CONNECT
135 | E16 | GPIO14/1588_SPI_SCLK | NO CONNECT
136 | H14 | GPIO13/1588_SPI_MISO | NO CONNECT
137 | J14 | GPIO12/1588_SPI_SSN | NO CONNECT
138 | P2 | MDC | EMI1_MDC
139 | N2 | MDIO | EMI1_MDIO
140 | M2 | MDINT | SGMII_PHY_INT/2V5
141 | G13 | PHYAD2 | 2V5
142 | G14 | PHYAD3 | 2V5
143 | F14 | PHYAD4 | 2V5
144 | L3 | COMA_MODE | GND
145 | M3 | NRESET | SGMII_RST/2V5
146 | C10 | TANA_1/RSVD1 | NO CONNECT
147 | D13 | TANA_0/RSVD2 | NO CONNECT
148 | B1 | VSS | GND
149 | B16 | VSS | GND
150 | C5 | VSS | GND
151 | C12 | VSS | GND
152 | D5 | VSS | GND
153 | D6 | VSS | GND
154 | D7 | VSS | GND
155 | D8 | VSS | GND
156 | D9 | VSS | GND
157 | D10 | VSS | GND
158 | D11 | VSS | GND
159 | D12 | VSS | GND
160 | E6 | VSS | GND
161 | E7 | VSS | GND
162 | E8 | VSS | GND
163 | E9 | VSS | GND
164 | E10 | VSS | GND
165 | E11 | VSS | GND
166 | F4 | VSS | GND
167 | F5 | VSS | GND
168 | F6 | VSS | GND
169 | F7 | VSS | GND
170 | F8 | VSS | GND
171 | F9 | VSS | GND
172 | F10 | VSS | GND
173 | F11 | VSS | GND
174 | G6 | VSS | GND
175 | G7 | VSS | GND
176 | G8 | VSS | GND
177 | G9 | VSS | GND
178 | G10 | VSS | GND
179 | G11 | VSS | GND
180 | H6 | VSS | GND
181 | H7 | VSS | GND
182 | H8 | VSS | GND
183 | H9 | VSS | GND
184 | H10 | VSS | GND
185 | H11 | VSS | GND
186 | J6 | VSS | GND
187 | J7 | VSS | GND
188 | J8 | VSS | GND
189 | J9 | VSS | GND
190 | J10 | VSS | GND
191 | J11 | VSS | GND
192 | K6 | VSS | GND
193 | K7 | VSS | GND
194 | K8 | VSS | GND
195 | K9 | VSS | GND
196 | K10 | VSS | GND
197 | K11 | VSS | GND
198 | L6 | VSS | GND
199 | L7 | VSS | GND
200 | L8 | VSS | GND
201 | L9 | VSS | GND
202 | L10 | VSS | GND
203 | L11 | VSS | GND
204 | M6 | VSS | GND
205 | M7 | VSS | GND
206 | M8 | VSS | GND
207 | M9 | VSS | GND
208 | M10 | VSS | GND
209 | M11 | VSS | GND
210 | N6 | VSS | GND
211 | N7 | VSS | GND
212 | N8 | VSS | GND
213 | N9 | VSS | GND
214 | N10 | VSS | GND
215 | N11 | VSS | GND
216 | R1 | VSS | GND
217 | R16 | VSS | GND
218 | R13 | TDINP_1 | SGMII2_TX_P
219 | T13 | TDINN_1 | SGMII2_TX_N
220 | R12 | RDOUTP_1 | SGMII2_RX_P
221 | T12 | RDOUTN_1 | SGMII2_RX_N
222 | H1 | LED0_1 | NO CONNECT
223 | H2 | LED1_1 | NO CONNECT
224 | H3 | LED2_1 | NO CONNECT
225 | H4 | LED3_1 | NO CONNECT
226 | A10 | TXVPA_1 | SGMII2_TXVA_P
227 | B10 | TXVNA_1 | SGMII2_TXVA_N
228 | A11 | TXVPB_1 | SGMII2_TXVB_P
229 | B11 | TXVNB_1 | SGMII2_TXVB_N
230 | A12 | TXVPC_1 | SGMII2_TXVC_P
231 | B12 | TXVNC_1 | SGMII2_TXVC_N
232 | A13 | TXVPD_1 | SGMII2_TXVD_P
233 | B13 | TXVND_1 | SGMII2_TXVD_N
234 | R11 | FIBR_DIP1 | GND
235 | T11 | FIBR_DIN1 | GND
236 | R10 | FIBR_DOP1 | NO CONNECT
237 | T10 | FIBR_DON1 | NO CONNECT
238 | N15 | TDINP_0 | SGMII1_TX_P
239 | N16 | TDINN_0 | SGMII1_TX_N
240 | P15 | RDOUTP_0 | SGMII1_RX_P
241 | P16 | RDOUTN_0 | SGMII1_RX_N
242 | G1 | LED0_0 | NO CONNECT
243 | G2 | LED1_0 | NO CONNECT
244 | G3 | LED2_0 | NO CONNECT
245 | G4 | LED3_0 | NO CONNECT
246 | A14 | TXVPA_0 | SGMII1_TXVA_P
247 | B14 | TXVNA_0 | SGMII1_TXVA_N
248 | A15 | TXVPB_0 | SGMII1_TXVB_P
249 | B15 | TXVNB_0 | SGMII1_TXVB_N
250 | C16 | TXVPC_0 | SGMII1_TXVC_P
251 | C15 | TXVNC_0 | SGMII1_TXVC_N
252 | D16 | TXVPD_0 | SGMII1_TXVD_P
253 | D15 | TXVND_0 | SGMII1_TXVD_N
254 | R15 | FIBR_DIP0 | GND
255 | T15 | FIBR_DIN0 | GND
256 | R14 | FIBR_DOP0 | NO CONNECT
257 | T14 | FIBR_DON0 | NO CONNECT

Sheet: QSGMII PHY 1
Schematics Review - T1020 based 12 port AFDX switch
QSGMII PHY 1 schematics from datasheet
S. No | PIN | SIGNAL | IN SCHEMATICS | IN DATASHEET | DESCRIPTION | COMMENTS
1 | D31 | P0_D0P
2 | D30 | P0_D0N
3 | C25 | P0_D1P
4 | C24 | P0_D1N
5 | D29 | P0_D2P
6 | C23 | P0_D2N
7 | C22 | P0_D3P
8 | C21 | P0_D3N
9 | E2 | LED0_PHY0 | NO CONNECT
10 | D1 | LED1_PHY0 | NO CONNECT
11 | D2 | LED2_PHY0 | NO CONNECT
12 | C2 | LED3_PHY0 | NO CONNECT
13 | C33 | P2_D0P
14 | C32 | P2_D0N
15 | B20 | P2_D1P
16 | B19 | P2_D1N
17 | A10 | P2_D2P
18 | A9 | P2_D2N
19 | C31 | P2_D3P
20 | C30 | P2_D3N
21 | C5 | LED0_PHY2 | NO CONNECT
22 | D5 | LED1_PHY2 | NO CONNECT
23 | B3 | LED2_PHY2 | NO CONNECT
24 | D6 | LED3_PHY2 | NO CONNECT
25 | D16 | QSGMII0_TXP
26 | D15 | QSGMII0_TXN
27 | D11 | REFCLK_P
28 | D12 | REFCLK_N
29 | D27 | CLK_SQUELCH_IN | NO CONNECT
30 | B8 | REFCLK_SEL0
31 | B7 | REFCLK_SEL1
32 | C11 | MDC
33 | D10 | MDIO
34 | B5 | /RESET
35 | D8 | COMA_MODE
36 | D19 | GPIO0 | NO CONNECT
37 | C14 | GPIO1 | NO CONNECT
38 | D20 | GPIO2 | NO CONNECT
39 | C15 | GPIO3 | NO CONNECT
40 | B9 | GPIO4 | NO CONNECT
41 | C16 | GPIO5 | NO CONNECT
42 | D21 | GPIO6 | NO CONNECT
43 | B10 | GPIO7 | NO CONNECT
44 | C9 | JTAG_DI | NO CONNECT
45 | A3 | JTAG_TMS | NO CONNECT
46 | B6 | JTAG_CLK | NO CONNECT
47 | C7 | /JTAG_TRST
48 | A8 | REF_REXT
49 | A7 | REF_FILT
50 | A10 | NC1 | NO CONNECT
51 | A4 | NC2 | NO CONNECT
52 | A5 | NC3 | NO CONNECT
53 | A6 | NC4 | NO CONNECT
54 | B18 | P1_D0P
55 | B17 | P1_D0N
56 | C29 | P1_D1P
57 | C28 | P1_D1N
58 | B16 | P1_D2P
59 | B15 | P1_D2N
60 | C27 | P1_D3P
61 | C26 | P1_D3N
62 | C3 | LED0_PHY1 | NO CONNECT
63 | B20 | LED1_PHY1 | NO CONNECT
64 | C4 | LED2_PHY1 | NO CONNECT
65 | D4 | LED3_PHY1 | NO CONNECT
66 | C1 | P3_D0P
67 | C36 | P3_D0N
68 | D35 | P3_D1P
69 | D34 | P3_D1N
70 | C35 | P3_D2P
71 | C34 | P3_D2N
72 | D33 | P3_D3P
73 | D32 | P3_D3N
74 | B4 | LED0_PHY3 | NO CONNECT
75 | C6 | LED1_PHY3 | NO CONNECT
76 | A2 | LED2_PHY3 | NO CONNECT
77 | D7 | LED3_PHY3 | NO CONNECT
78 | D14 | QSGMII0_RXP
79 | D13 | QSGMII0_RXN
80 | B13 | RCVRD_CLK0 | NO CONNECT
81 | C20 | RCVRD_CLK1 | NO CONNECT
82 | C10 | MDINT | QSG1_INT_N
83 | C19 | PHYADD2
84 | B12 | PHYADD3
85 | D26 | PHYADD4
86 | C17 | GPIO8 | NO CONNECT
87 | D22 | GPIO9 | NO CONNECT
88 | D24 | GPIO10 | NO CONNECT
89 | D23 | GPIO11 | NO CONNECT
90 | C18 | GPIO12 | NO CONNECT
91 | B11 | GPIO13 | NO CONNECT
92 | D25 | GPIO14 | NO CONNECT
93 | C8 | JTAG_DO | NO CONNECT
94 | D17 | SEDES_REXT_0
95 | D18 | SEDES_REXT_1
96 | C12 | HSTST_P/NC | NO CONNECT
97 | C13 | HSTST_N/NC | NO CONNECT
98 | D28 | TANA_0/NC | NO CONNECT
99 | B14 | TANA_1/NC | NO CONNECT
100 | E5 | VDD1 | 1V0_PHY
101 | E7 | VDD1 | 1V0_PHY
102 | E10 | VDD1 | 1V0_PHY
103 | E13 | VDD1 | 1V0_PHY
104 | E15 | VDD1 | 1V0_PHY
105 | E17 | VDD1 | 1V0_PHY
106 | E19 | VDD1 | 1V0_PHY
107 | E21 | VDD1 | 1V0_PHY
108 | E23 | VDD1 | 1V0_PHY
109 | E25 | VDD1 | 1V0_PHY
110 | E1 | VDD1A | 1V0_PHY/1V0A_QSG1
111 | E11 | VDD1A | 1V0_PHY/1V0A_QSG1
112 | E14 | VDD1A | 1V0_PHY/1V0A_QSG1
113 | E16 | VDD1A | 1V0_PHY/1V0A_QSG1
114 | E28 | VDD1A | 1V0_PHY/1V0A_QSG1
115 | E30 | VDD1A | 1V0_PHY/1V0A_QSG1
116 | E32 | VDD1A | 1V0_PHY/1V0A_QSG1
117 | E34 | VDD1A | 1V0_PHY/1V0A_QSG1
118 | E36 | VDD1A | 1V0_PHY/1V0A_QSG1
119 | B1 | THERMDA | NO CONNECT
120 | D3 | THEEMDC_VSS | NO CONNECT
121 | E3 | VDD25 | 2V5
122 | E4 | VDD25 | 2V5
123 | E6 | VDD25 | 2V5
124 | E8 | VDD25 | 2V5
125 | E12 | VDD25 | 2V5
126 | E18 | VDD25 | 2V5
127 | E20 | VDD25 | 2V5
128 | E22 | VDD25 | 2V5
129 | E24 | VDD25 | 2V5
130 | E26 | VDD25 | 2V5
131 | E27 | VDD25A | 2V5
132 | E29 | VDD25A | 2V5
133 | E31 | VDD25A | 2V5
134 | E33 | VDD25A | 2V5
135 | E35 | VDD25A | 2V5
136 | E37 | VDD25A | 2V5A_QSG1
137 | E9 | VDDMDIO | 2V5
138 | D9 | VSS/EFUSE | GND
139 | ?? | VSS_CASE | GND |  |  | Not Found in datasheet

Sheet: QSGMII PHY 2
Schematics Review - T1020 based 12 port AFDX switch
QSGMII PHY 2 schematics from datasheet
S. No | PIN | SIGNAL | IN SCHEMATICS | IN DATASHEET | DESCRIPTION | COMMENTS
1 | D31 | P0_D0P | QSG6_MDI0_P
2 | D30 | P0_D0N | QSG6_MDI0_N
3 | C25 | P0_D1P | QSG6_MDI1_P
4 | C24 | P0_D1N | QSG6_MDI1_N
5 | D29 | P0_D2P | GND
6 | C23 | P0_D2N | GND
7 | C22 | P0_D3P | GND
8 | C21 | P0_D3N | GND
9 | E2 | LED0_PHY0 | NO CONNECT
10 | D1 | LED1_PHY0 | NO CONNECT
11 | D2 | LED2_PHY0 | NO CONNECT
12 | C2 | LED3_PHY0 | NO CONNECT
13 | C33 | P2_D0P | QSG8_MDI0_P
14 | C32 | P2_D0N | QSG8_MDI0_N
15 | B20 | P2_D1P | QSG8_MDI1_P
16 | B19 | P2_D1N | QSG8_MDI1_N
17 | A10 | P2_D2P | GND
18 | A9 | P2_D2N | GND
19 | C31 | P2_D3P | GND
20 | C30 | P2_D3N | GND
21 | C5 | LED0_PHY2 | NO CONNECT
22 | D5 | LED1_PHY2 | NO CONNECT
23 | B3 | LED2_PHY2 | NO CONNECT
24 | D6 | LED3_PHY2 | NO CONNECT
25 | D16 | QSGMII0_TXP | QSGM112_TX_P
26 | D15 | QSGMII0_TXN | QSGM112_TX_N
27 | D11 | REFCLK_P | QSG2_REFCLK_P
28 | D12 | REFCLK_N | QSG2_REFCLK_N
29 | D27 | CLK_SQUELCH_IN | NO CONNECT
30 | B8 | REFCLK_SEL0 | GND |  |  | REFCLK_SEL[1:0] = 00 For 125MHz Clock
31 | B7 | REFCLK_SEL1 | GND |  |  | REFCLK_SEL[1:0] = 00 For 125MHz Clock
32 | C11 | MDC | EMI1_MDC
33 | D10 | MDIO | EMI1_MDIO
34 | B5 | /RESET | QSG2_RST_N/2V5
35 | D8 | COMA_MODE | GND
36 | D19 | GPIO0 | NO CONNECT
37 | C14 | GPIO1 | NO CONNECT
38 | D20 | GPIO2 | NO CONNECT
39 | C15 | GPIO3 | NO CONNECT
40 | B9 | GPIO4 | NO CONNECT
41 | C16 | GPIO5 | NO CONNECT
42 | D21 | GPIO6 | NO CONNECT
43 | B10 | GPIO7 | NO CONNECT
44 | C9 | JTAG_DI | NO CONNECT
45 | A3 | JTAG_TMS | NO CONNECT
46 | B6 | JTAG_CLK | NO CONNECT
47 | C7 | /JTAG_TRST | GND
48 | A8 | REF_REXT | GND
49 | A7 | REF_FILT | GND
50 | A10 | NC1 | NO CONNECT
51 | A4 | NC2 | NO CONNECT
52 | A5 | NC3 | NO CONNECT
53 | A6 | NC4 | NO CONNECT
54 | B18 | P1_D0P | QSG5_MDI0_P
55 | B17 | P1_D0N | QSG5_MDI0_N
56 | C29 | P1_D1P | QSG5_MDI1_P
57 | C28 | P1_D1N | QSG5_MDI1_N
58 | B16 | P1_D2P | GND
59 | B15 | P1_D2N | GND
60 | C27 | P1_D3P | GND
61 | C26 | P1_D3N | GND
62 | C3 | LED0_PHY1 | NO CONNECT
63 | B20 | LED1_PHY1 | NO CONNECT
64 | C4 | LED2_PHY1 | NO CONNECT
65 | D4 | LED3_PHY1 | NO CONNECT
66 | C1 | P3_D0P | QSG7_MDI0_P
67 | C36 | P3_D0N | QSG7_MDI0_N
68 | D35 | P3_D1P | QSG7_MDI1_P
69 | D34 | P3_D1N | QSG7_MDI1_N
70 | C35 | P3_D2P | GND
71 | C34 | P3_D2N | GND
72 | D33 | P3_D3P | GND
73 | D32 | P3_D3N | GND
74 | B4 | LED0_PHY3 | NO CONNECT
75 | C6 | LED1_PHY3 | NO CONNECT
76 | A2 | LED2_PHY3 | NO CONNECT
77 | D7 | LED3_PHY3 | NO CONNECT
78 | D14 | QSGMII0_RXP | QSGM112_RX_P
79 | D13 | QSGMII0_RXN | QSGM112_RX_N
80 | B13 | RCVRD_CLK0 | NO CONNECT
81 | C20 | RCVRD_CLK1 | NO CONNECT
82 | C10 | MDINT | QSG1_INT_N
83 | C19 | PHYADD2 | 2V5
84 | B12 | PHYADD3 | 2V5
85 | D26 | PHYADD4 | 2V5
86 | C17 | GPIO8 | NO CONNECT
87 | D22 | GPIO9 | NO CONNECT
88 | D24 | GPIO10 | NO CONNECT
89 | D23 | GPIO11 | NO CONNECT
90 | C18 | GPIO12 | NO CONNECT
91 | B11 | GPIO13 | NO CONNECT
92 | D25 | GPIO14 | NO CONNECT
93 | C8 | JTAG_DO | NO CONNECT
94 | D17 | SEDES_REXT_0 | SHORT
95 | D18 | SEDES_REXT_1 | SHORT
96 | C12 | HSTST_P/NC | NO CONNECT
97 | C13 | HSTST_N/NC | NO CONNECT
98 | D28 | TANA_0/NC | NO CONNECT
99 | B14 | TANA_1/NC | NO CONNECT
100 | E5 | VDD1 | 1V0_PHY
101 | E7 | VDD1 | 1V0_PHY
102 | E10 | VDD1 | 1V0_PHY
103 | E13 | VDD1 | 1V0_PHY
104 | E15 | VDD1 | 1V0_PHY
105 | E17 | VDD1 | 1V0_PHY
106 | E19 | VDD1 | 1V0_PHY
107 | E21 | VDD1 | 1V0_PHY
108 | E23 | VDD1 | 1V0_PHY
109 | E25 | VDD1 | 1V0_PHY
110 | E1 | VDD1A | 1V0_PHY/1V0A_QSG2
111 | E11 | VDD1A | 1V0_PHY/1V0A_QSG2
112 | E14 | VDD1A | 1V0_PHY/1V0A_QSG2
113 | E16 | VDD1A | 1V0_PHY/1V0A_QSG2
114 | E28 | VDD1A | 1V0_PHY/1V0A_QSG2
115 | E30 | VDD1A | 1V0_PHY/1V0A_QSG2
116 | E32 | VDD1A | 1V0_PHY/1V0A_QSG2
117 | E34 | VDD1A | 1V0_PHY/1V0A_QSG2
118 | E36 | VDD1A | 1V0_PHY/1V0A_QSG2
119 | B1 | THERMDA | NO CONNECT
120 | D3 | THEEMDC_VSS | NO CONNECT
121 | E3 | VDD25 | 2V5
122 | E4 | VDD25 | 2V5
123 | E6 | VDD25 | 2V5
124 | E8 | VDD25 | 2V5
125 | E12 | VDD25 | 2V5
126 | E18 | VDD25 | 2V5
127 | E20 | VDD25 | 2V5
128 | E22 | VDD25 | 2V5
129 | E24 | VDD25 | 2V5
130 | E26 | VDD25 | 2V5
131 | E27 | VDD25A | 2V5
132 | E29 | VDD25A | 2V5
133 | E31 | VDD25A | 2V5
134 | E33 | VDD25A | 2V5
135 | E35 | VDD25A | 2V5
136 | E37 | VDD25A | 2V5A_QSG2
137 | E9 | VDDMDIO | 2V5
138 | D9 | VSS/EFUSE | GND
139 | ?? | VSS_CASE | GND |  |  | Not Found in datasheet

Sheet: QSGMII Ethernet Ports
Schematics Review - T1020 based 12 port AFDX switch
QSGMII Ethernet Ports schematics from datasheet
S. No | PIN | SIGNAL | IN SCHEMATICS | IN DATASHEET | DESCRIPTION | COMMENTS
1000B-5003F/X (T3)
1 | 1 | QSG1_MDI0_P | QSG1_MDI0_P
2 | 2 | GND | GND
3 | 3 | QSG1_MDI0_N | QSG1_MDI0_N
4 | 4 | QSG1_MDI1_P | QSG1_MDI1_P
5 | 5 | GND | GND
6 | 6 | QSG1_MDI1_N | QSG1_MDI1_N
7 | 7 | QSG2_MDI0_P | QSG2_MDI0_P
8 | 8 | GND | GND
9 | 9 | QSG2_MDI0_N | QSG2_MDI0_N
10 | 10 | QSG2_MDI1_P | QSG2_MDI1_P
11 | 11 | GND | GND
12 | 12 | QSG2_MDI1_N | QSG2_MDI1_N
13 | 14 | QSG3_MDI0_P | QSG3_MDI0_P
14 | 15 | GND | GND
15 | 16 | QSG3_MDI0_N | QSG3_MDI0_N
16 | 17 | QSG3_MDI1_P | QSG3_MDI1_P
17 | 18 | GND | GND
18 | 19 | QSG3_MDI1_N | QSG3_MDI1_N
19 | 20 | QSG4_MDI0_P | QSG4_MDI0_P
20 | 21 | GND | GND
21 | 22 | QSG4_MDI0_N | QSG4_MDI0_N
22 | 23 | QSG4_MDI1_P | QSG4_MDI1_P
23 | 24 | GND | GND
24 | 25 | QSG4_MDI1_N | QSG4_MDI1_N
25 | 48 | QSG1_MDX0_P | QSG1_MDX0_P
26 | 49 | GND | GND
27 | 50 | QSG1_MDX0_N | QSG1_MDX0_N
28 | 47 | QSG1_MDX1_P | QSG1_MDX1_P
29 | 46 | GND | GND
30 | 45 | QSG1_MDX1_N | QSG1_MDX1_N
31 | 42 | QSG2_MDX0_P | QSG2_MDX0_P
32 | 43 | GND | GND
33 | 44 | QSG2_MDX0_N | QSG2_MDX0_N
34 | 41 | QSG2_MDX1_P | QSG2_MDX1_P
35 | 40 | GND | GND
36 | 39 | QSG2_MDX1_N | QSG2_MDX1_N
37 | 35 | QSG3_MDX0_P | QSG3_MDX0_P
38 | 36 | GND | GND
39 | 37 | QSG3_MDX0_N | QSG3_MDX0_N
40 | 34 | QSG3_MDX1_P | QSG3_MDX1_P
41 | 33 | GND | GND
42 | 32 | QSG3_MDX1_N | QSG3_MDX1_N
43 | 29 | QSG4_MDX0_P | QSG4_MDX0_P
44 | 30 | GND | GND
45 | 31 | QSG4_MDX0_N | QSG4_MDX0_N
46 | 28 | QSG4_MDX1_P | QSG4_MDX1_P
47 | 27 | GND | GND
48 | 26 | QSG4_MDX1_N | QSG4_MDX1_N
1000B-5003F/X (T4)
1 | 1 | QSG5_MDI0_P | QSG5_MDI0_P
2 | 2 | GND | GND
3 | 3 | QSG5_MDI0_N | QSG5_MDI0_N
4 | 4 | QSG5_MDI1_P | QSG5_MDI1_P
5 | 5 | GND | GND
6 | 6 | QSG5_MDI1_N | QSG5_MDI1_N
7 | 7 | QSG6_MDI0_P | QSG6_MDI0_P
8 | 8 | GND | GND
9 | 9 | QSG6_MDI0_N | QSG6_MDI0_N
10 | 10 | QSG6_MDI1_P | QSG6_MDI1_P
11 | 11 | GND | GND
12 | 12 | QSG6_MDI1_N | QSG6_MDI1_N
13 | 14 | QSG7_MDI0_P | QSG7_MDI0_P
14 | 15 | GND | GND
15 | 16 | QSG7_MDI0_N | QSG7_MDI0_N
16 | 17 | QSG7_MDI1_P | QSG7_MDI1_P
17 | 18 | GND | GND
18 | 19 | QSG7_MDI1_N | QSG7_MDI1_N
19 | 20 | QSG8_MDI0_P | QSG8_MDI0_P
20 | 21 | GND | GND
21 | 22 | QSG8_MDI0_N | QSG8_MDI0_N
22 | 23 | QSG8_MDI1_P | QSG8_MDI1_P
23 | 24 | GND | GND
24 | 25 | QSG8_MDI1_N | QSG8_MDI1_N
25 | 48 | QSG5_MDX0_P | QSG5_MDX0_P
26 | 49 | GND | GND
27 | 50 | QSG5_MDX0_N | QSG5_MDX0_N
28 | 47 | QSG5_MDX1_P | QSG5_MDX1_P
29 | 46 | GND | GND
30 | 45 | QSG5_MDX1_N | QSG5_MDX1_N
31 | 42 | QSG6_MDX0_P | QSG6_MDX0_P
32 | 43 | GND | GND
33 | 44 | QSG6_MDX0_N | QSG6_MDX0_N
34 | 41 | QSG6_MDX1_P | QSG6_MDX1_P
35 | 40 | GND | GND
36 | 39 | QSG6_MDX1_N | QSG6_MDX1_N
37 | 35 | QSG7_MDX0_P | QSG7_MDX0_P
38 | 36 | GND | GND
39 | 37 | QSG7_MDX0_N | QSG7_MDX0_N
40 | 34 | QSG7_MDX1_P | QSG7_MDX1_P
41 | 33 | GND | GND
42 | 32 | QSG7_MDX1_N | QSG7_MDX1_N
43 | 29 | QSG8_MDX0_P | QSG8_MDX0_P
44 | 30 | GND | GND
45 | 31 | QSG8_MDX0_N | QSG8_MDX0_N
46 | 28 | QSG8_MDX1_P | QSG8_MDX1_P
47 | 27 | GND | GND
48 | 26 | QSG8_MDX1_N | QSG8_MDX1_N
9FGV0241AKILF (U37)
1 | 1 | X1_25
2 | 2 | X2
3 | 12 | /OE0
4 | 19 | /OE1
5 | 23 | SS_EN_TRI
6 | 4 | SA/DR//REF1.8
7 | 22 | /CKPWRGD_PD
8 | 8 | SCLK_3.3
9 | 9 | SDATA_3.3
10 | 3 | VDDXTAL1.8
11 | 24 | GNDXTAL
12 | 13 | DIF0
13 | 14 | /DIF0
14 | 17 | DIF1
15 | 18 | /DIF1
16 | 7 | VDDDIG1.8
17 | 20 | VDD1.8
18 | 11 | VDD1.8
19 | 16 | VDDA1.8
20 | 15 | GNDA
21 | 10 | GND
22 | 21 | GND
23 | 5 | GNDREF
24 | 6 | GNDDIG
SRV05-4 (U30)
1 | 1 |  | QSG6_MDI0_P
2 | 2 |  | GND
3 | 3 |  | QSG6_MDI0_N
4 | 6 |  | QSG6_MDI1_P
5 | 5 |  | GND
6 | 4 |  | QSG6_MDI1_N
SRV05-4 (U31)
1 | 1 |  | QSG1_MDI0_P
2 | 2 |  | GND
3 | 3 |  | QSG1_MDI0_N
4 | 6 |  | QSG1_MDI1_P
5 | 5 |  | GND
6 | 4 |  | QSG1_MDI1_N
SRV05-4 (U32)
1 | 1 |  | QSG2_MDI0_P
2 | 2 |  | GND
3 | 3 |  | QSG2_MDI0_N
4 | 6 |  | QSG2_MDI1_P
5 | 5 |  | GND
6 | 4 |  | QSG2_MDI1_N
SRV05-4 (U33)
1 | 1 |  | QSG7_MDI0_P
2 | 2 |  | GND
3 | 3 |  | QSG7_MDI0_N
4 | 6 |  | QSG7_MDI1_P
5 | 5 |  | GND
6 | 4 |  | QSG7_MDI1_N
SRV05-4 (U34)
1 | 1 |  | QSG8_MDI0_P
2 | 2 |  | GND
3 | 3 |  | QSG8_MDI0_N
4 | 6 |  | QSG8_MDI1_P
5 | 5 |  | GND
6 | 4 |  | QSG8_MDI1_N
SRV05-4 (U35)
1 | 1 |  | QSG5_MDI0_P
2 | 2 |  | GND
3 | 3 |  | QSG5_MDI0_N
4 | 6 |  | QSG5_MDI1_P
5 | 5 |  | GND
6 | 4 |  | QSG5_MDI1_N
SRV05-4 (U36)
1 | 1 |  | QSG3_MDI0_P
2 | 2 |  | GND
3 | 3 |  | QSG3_MDI0_N
4 | 6 |  | QSG3_MDI1_P
5 | 5 |  | GND
6 | 4 |  | QSG3_MDI1_N
SRV05-4 (U38)
1 | 1 |  | QSG4_MDI0_P
2 | 2 |  | GND
3 | 3 |  | QSG4_MDI0_N
4 | 6 |  | QSG4_MDI1_P
5 | 5 |  | GND
6 | 4 |  | QSG4_MDI1_N

Sheet: System Clock generators
Schematics Review - T1020 based 12 port AFDX switch
QSGMII PHY 2 schematics from datasheet
S. No | PIN | SIGNAL | IN SCHEMATICS | IN DATASHEET | DESCRIPTION | COMMENTS
X2C64A-VQ44 (U41)
1 | 15 | VCC
2 | 7 | VCCIO1
3 | 39 | I/O29
4 | 40 | I/O28
5 | 41 | I/O27
6 | 42 | I/O26
7 | 43 | I/O25
8 | 44 | I/O24
9 | 1 | I/O10
10 | 2 | I/O11
11 | 3 | I/O12
12 | 5 | I/O13
13 | 6 | I/O14
14 | 8 | I/O15
15 | 12 | I/O1
16 | 13 | I/O2
17 | 14 | I/O3
18 | 16 | I/O4
19 | 9 | TDI
20 | 24 | TDO
21 | 10 | TMS
22 | 11 | TCK
23 | 35 | VAUX
24 | 26 | VCCIO2
25 | 38 | I/O30 | NO CONNECT
26 | 37 | I/O31
27 | 36 | I/O32
28 | 34 | I/O33
29 | 33 | I/O16
30 | 32 | I/O17
31 | 31 | I/O18
32 | 30 | I/O19
33 | 29 | I/O20
34 | 28 | I/O21
35 | 27 | I/O22
36 | 23 | I/O23
37 | 22 | I/O9
38 | 21 | I/O8
39 | 20 | I/O7
40 | 19 | I/O6
41 | 18 | I/O5
42 | 17 | GND
43 | 25 | GND
44 | 4 | GND
849S625BYILF (U40)
1 | 7 | VCC
2 | 48 | VCC
3 | 40 | VCCA
4 | 1 | XTAL_IN
5 | 2 | XTAL_OUT | NO CONNECT
6 | 42 | SELA0
7 | 41 | SELA1
8 | 6 | OEA
9 | 10 | SELB0 | NO CONNECT
10 | 11 | SELB1 | NO CONNECT
11 | 8 | OEB
12 | 4 | SELC0 | NO CONNECT
13 | 5 | SELC1 | NO CONNECT
14 | 9 | OEC
15 | 43 | SEL_OUT
16 | 44 | MR
17 | 45 | BYPASS
18 | 18 | NC | NO CONNECT
19 | 47 | REF_CLK
20 | 3 | VEE
21 | 12 | VEE
22 | 31 | VEE
23 | 46 | VEE
24 | 37 | VCCO | VCCO
25 | 32 | VCCO | VCCO
26 | 24 | VCCO | VCCO
27 | 19 | VCCO | VCCO
28 | 13 | VCCO | VCCO
29 | 39 | QA0
30 | 38 | NQA0
31 | 36 | QA1
32 | 35 | NQA1
33 | 34 | QA2
34 | 33 | NQA2
35 | 30 | QA3
36 | 29 | NQA3
37 | 28 | QA4
38 | 27 | NQA4
39 | 26 | QA5
40 | 25 | NQA5
41 | 23 | QB0 | NO CONNECT
42 | 22 | NQB0 | NO CONNECT
43 | 21 | QB1 | NO CONNECT
44 | 20 | NQB1 | NO CONNECT
45 | 17 | QC0 | NO CONNECT
46 | 16 | NQC0 | NO CONNECT
47 | 15 | QC1 | NO CONNECT
48 | 14 | NQC1 | NO CONNECT
QT88R_OSC_100MHZ (U42)
1 | 1
2 | 4
3 | 2
4 | 3
