siddharthnarayanan/RCI/switch_schematics_24022015.pdf

# Version Control

# Version

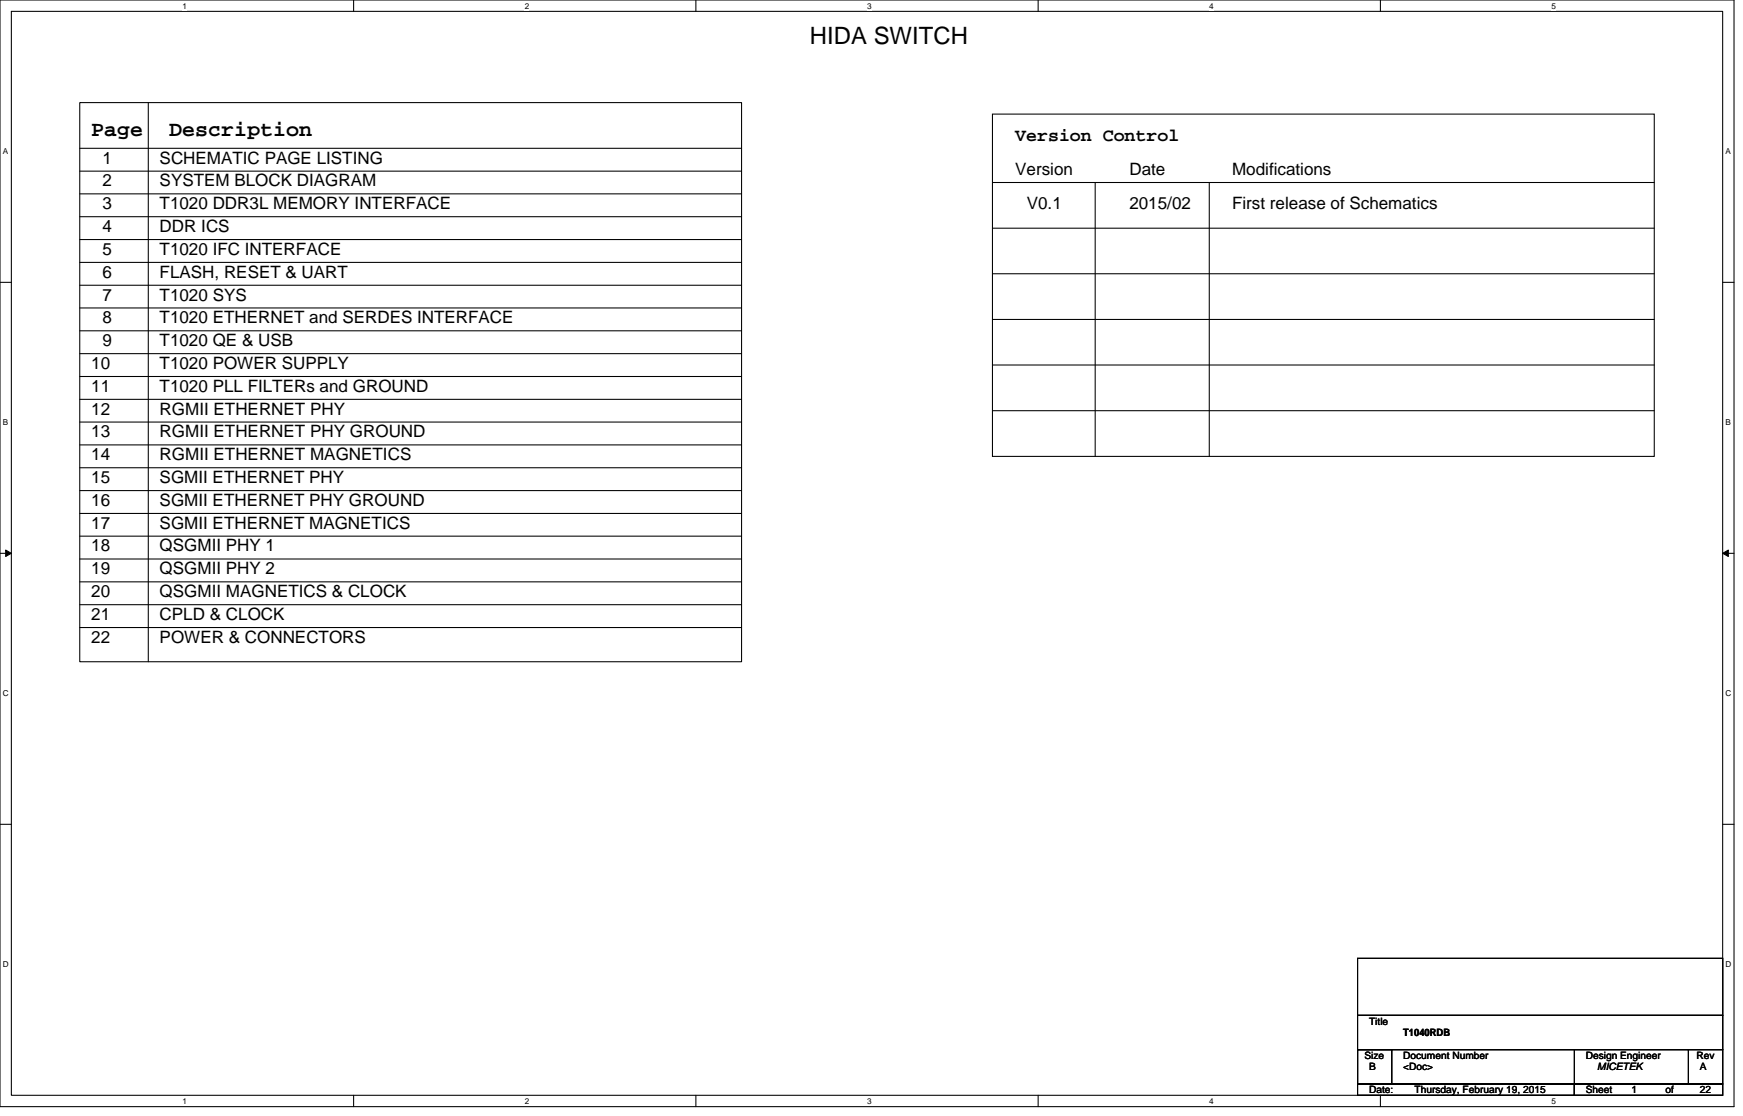
[picture p1: page 1]
Date; HIDA SWITCH; Page; Description; SCHEMATIC PAGE LISTING; Title; T1040RDB

Modifications
First release of Schematics

SYSTEM BLOCK DIAGRAM
T1020 DDR3L MEMORY INTERFACE
DDR ICS
T1020 IFC INTERFACE
FLASH, RESET & UART
T1020 SYS
T1020 ETHERNET and SERDES INTERFACE
T1020 QE & USB
T1020 POWER SUPPLY
T1020 PLL FILTERs and GROUND
RGMII ETHERNET PHY
RGMII ETHERNET PHY GROUND
RGMII ETHERNET MAGNETICS
SGMII ETHERNET PHY
SGMII ETHERNET PHY GROUND
SGMII ETHERNET MAGNETICS
QSGMII PHY 1
QSGMII PHY 2
QSGMII MAGNETICS & CLOCK
CPLD & CLOCK
POWER & CONNECTORS

Size Size Size B B B | Document Number Document Number Document Number <Doc> <Doc> <Doc> | Design Engineer Design Engineer Design Engineer MICETEK MICETEK MICETEK | Rev Rev Rev A A A

Date: Date: Date: Thursday, February 19, 2015 Thursday, February 19, 2015 Thursday, February 19, 2015 | | Sheet Sheet Sheet 1 1 1 of of of 22 22 22

# SYSTEM BLOCK DIAGRAM

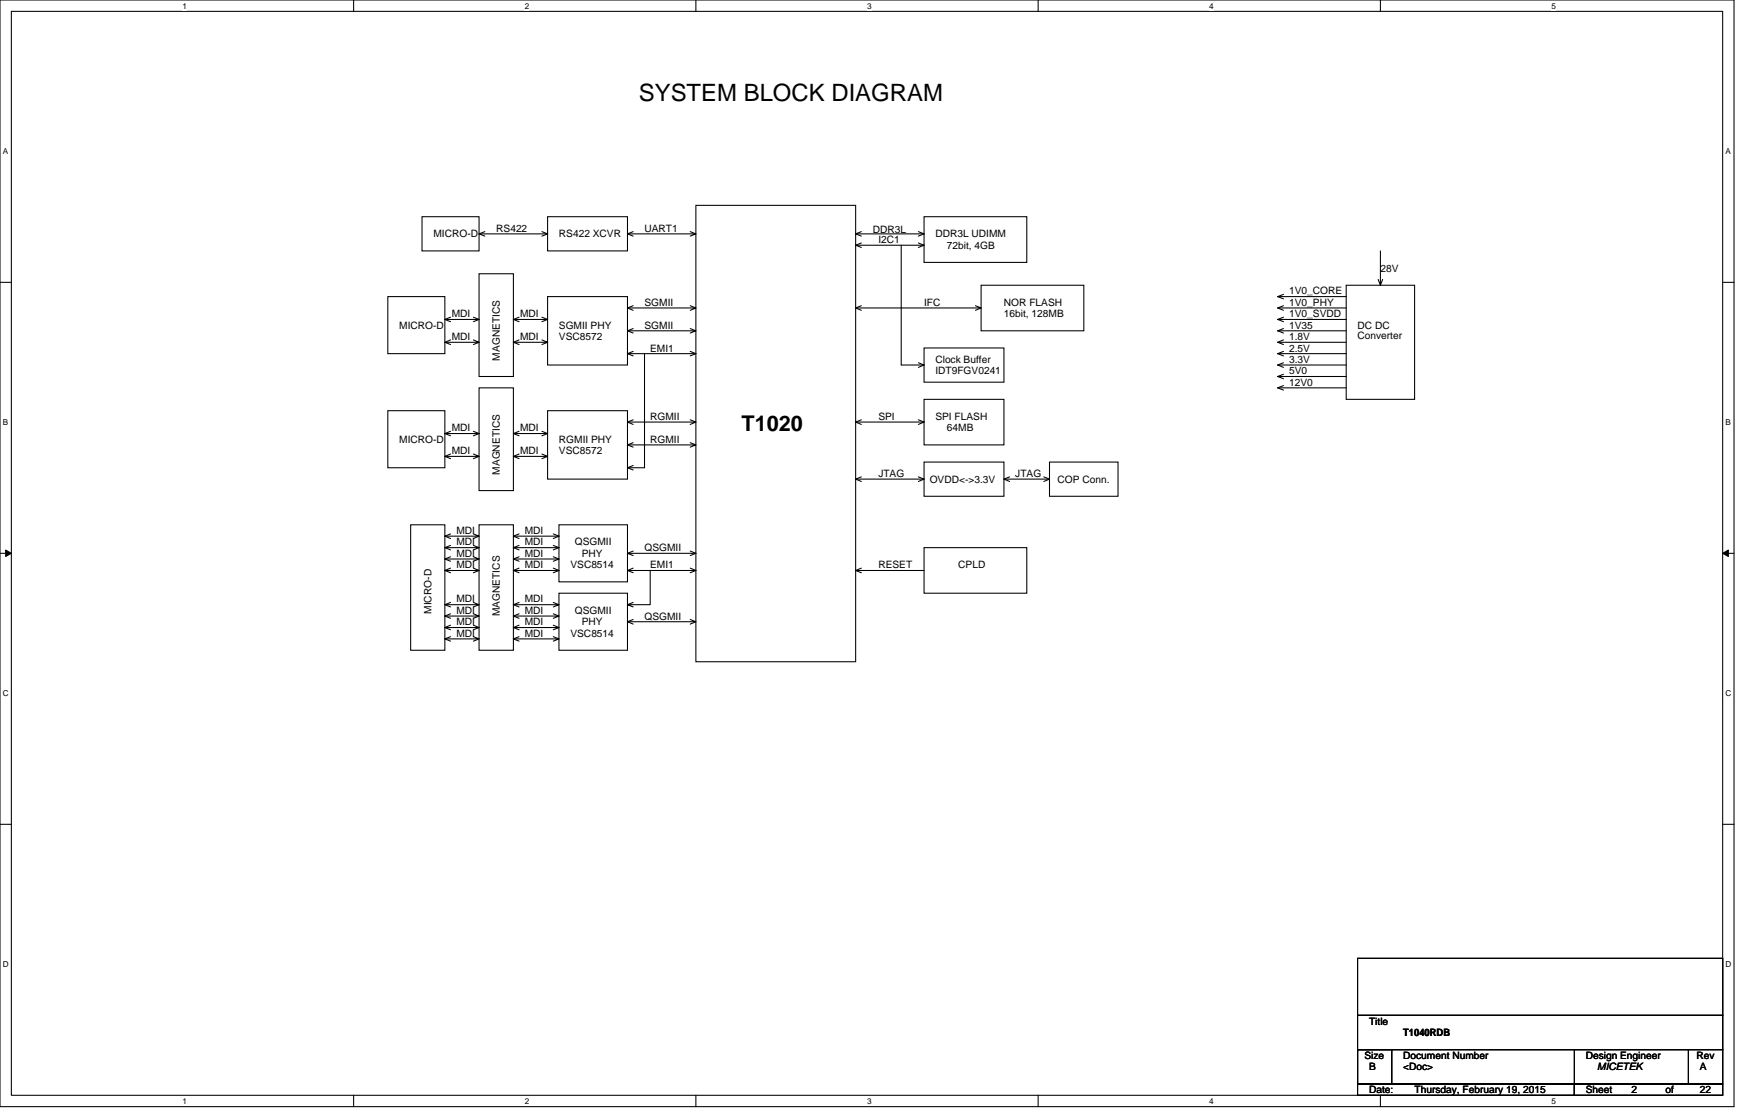
[picture p2: page 2]
DC DC Converter; 1V0_PHY 1V0_SVDD; DDR3L UDIMM; QSGMII PHY; MDI MDI MDI MDI; MAGNETICS; QSGMII; VSC8514; 72bit, 4GB; NOR FLASH 16bit, 128MB; CPLD; IFC; SPI; SPI FLASH; RS422 XCVR RS422; UART1 MICRO-D; RGMII; SGMII PHY; SGMII; MDI; JTAG; OVDD<->3.3V; COP Conn.; QSGMII PHY VSC8514; EMI1; MICRO-D; DDR3L I2C1; Clock Buffer IDT9FGV0241; VSC8572; 1V0_CORE; RESET; RGMII PHY; Title; T1040RDB

MAGNETICS MDI MDI MICRO-D

MAGNETICS MDI MDI MICRO-D VSC8572 RGMII

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

Date: Date: Date: Thursday, February 19, 2015 Thursday, February 19, 2015 Thursday, February 19, 2015 | | Sheet Sheet Sheet 2 2 2 of of of 22 22 22

# T1040 DDR3L MEMORY INTERFACE

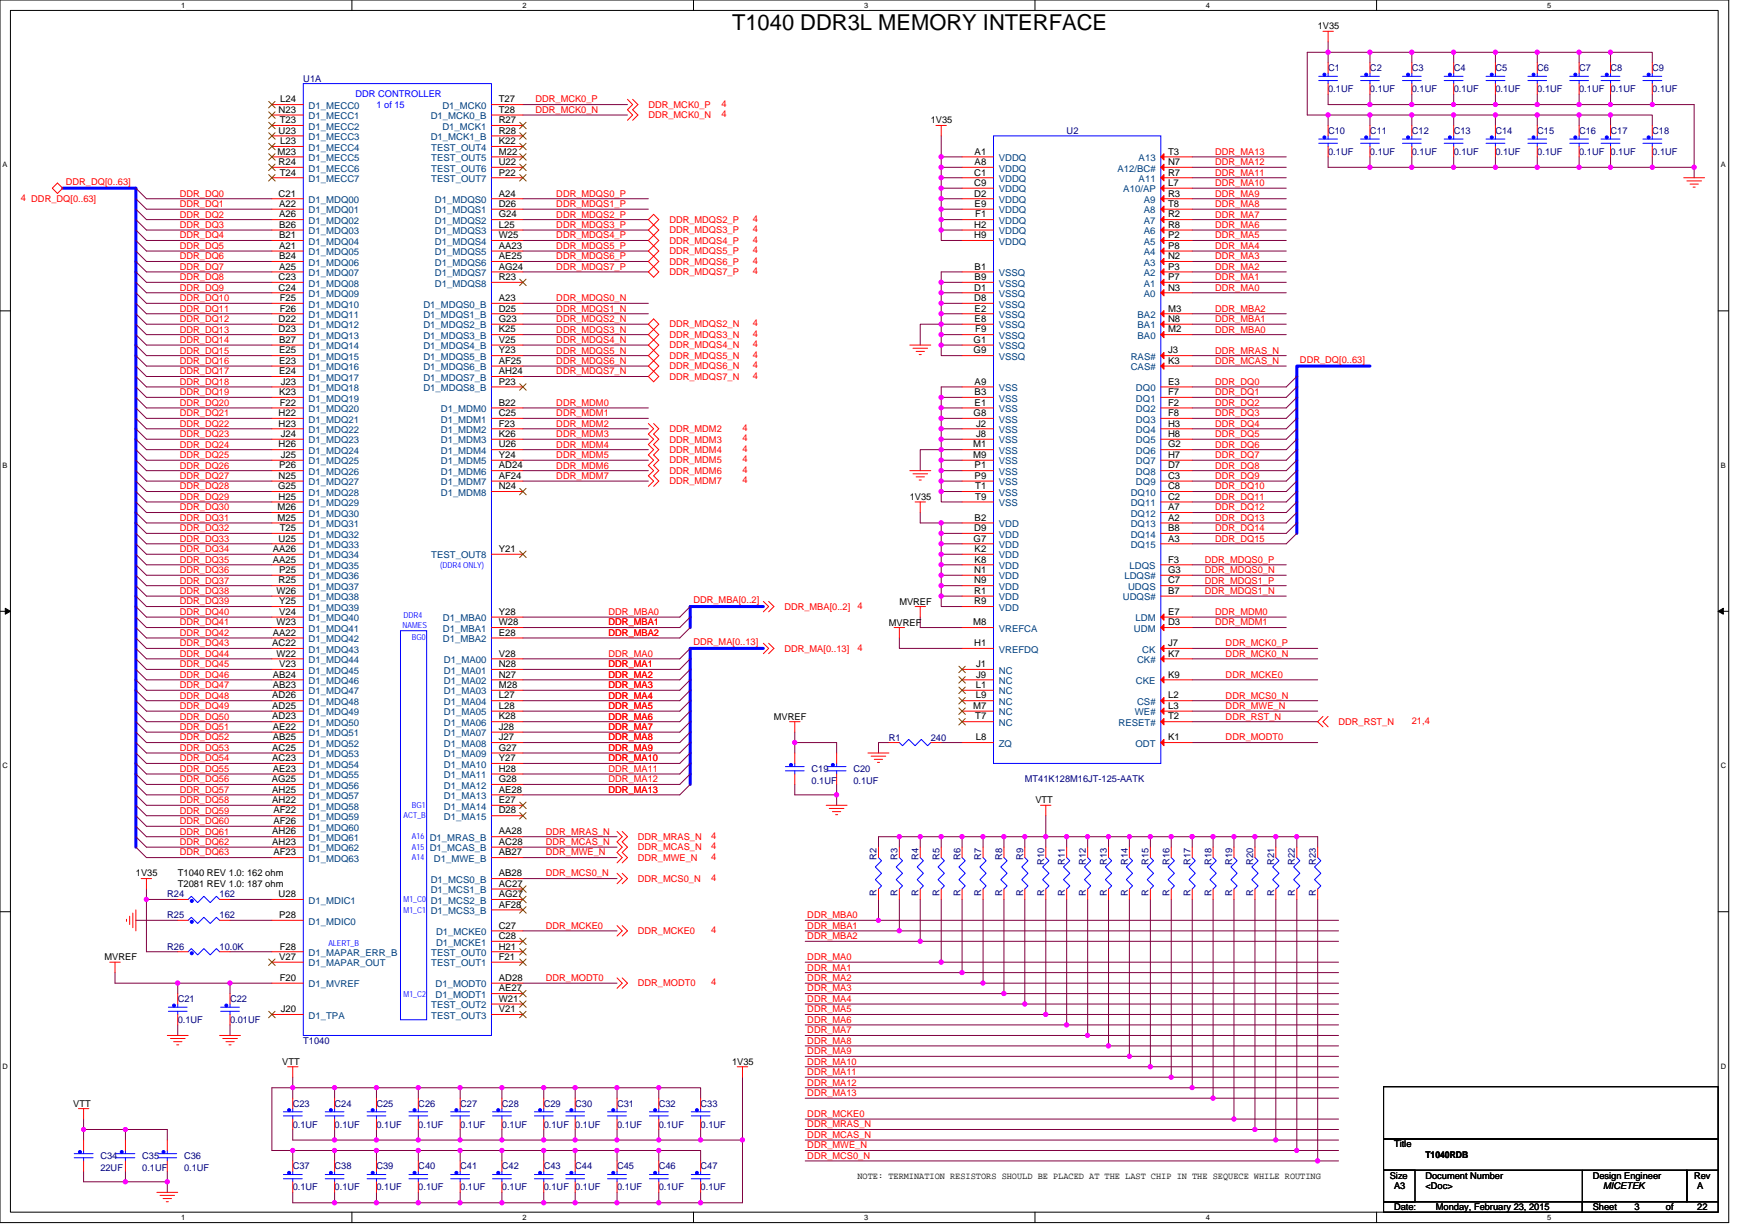
[picture p3: page 3]

Size Size Size A3 A3 A3 | Document Number Document Number Document Number <Doc> <Doc> <Doc> | Design Engineer Design Engineer Design Engineer MICETEK MICETEK MICETEK | Rev Rev Rev A A A

NOTE: TERMINATION RESISTORS SHOULD BE PLACED AT THE LAST CHIP IN THE SEQUECE WHILE ROUTING

Date: Date: Date: Monday, February 23, 2015 Monday, February 23, 2015 Monday, February 23, 2015 | | Sheet Sheet Sheet 3 3 3 of of of 22 22 22

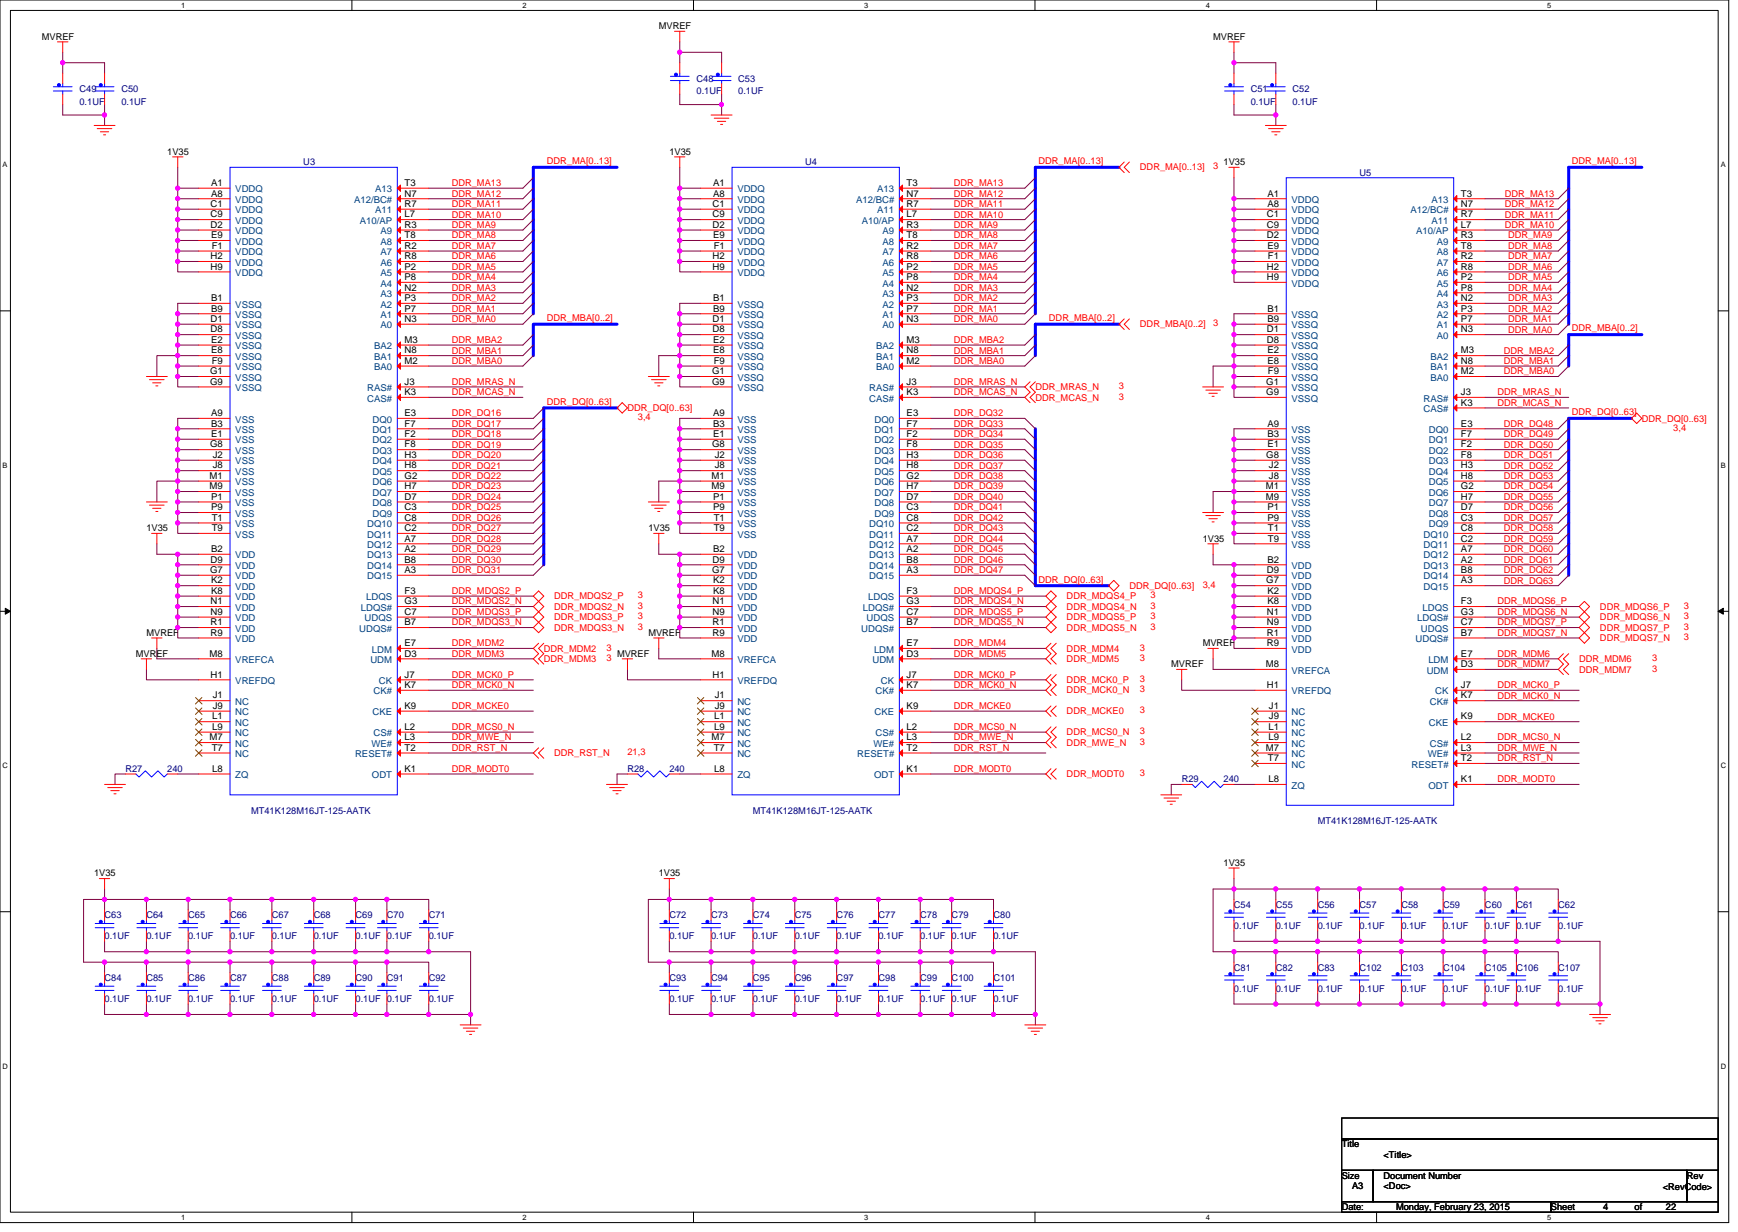
[picture p4: page 4]

Size Size Size A3 A3 A3 | Document Number Document Number Document Number <Doc> <Doc> <Doc> <RevCode> <RevCode> <RevCode> | Rev Rev Rev

Date: Date: Date: Monday, February 23, 2015 Monday, February 23, 2015 Monday, February 23, 2015 | Sheet Sheet Sheet 4 4 4 of of of 22 22 22

# T1040 IFC INTERFACE

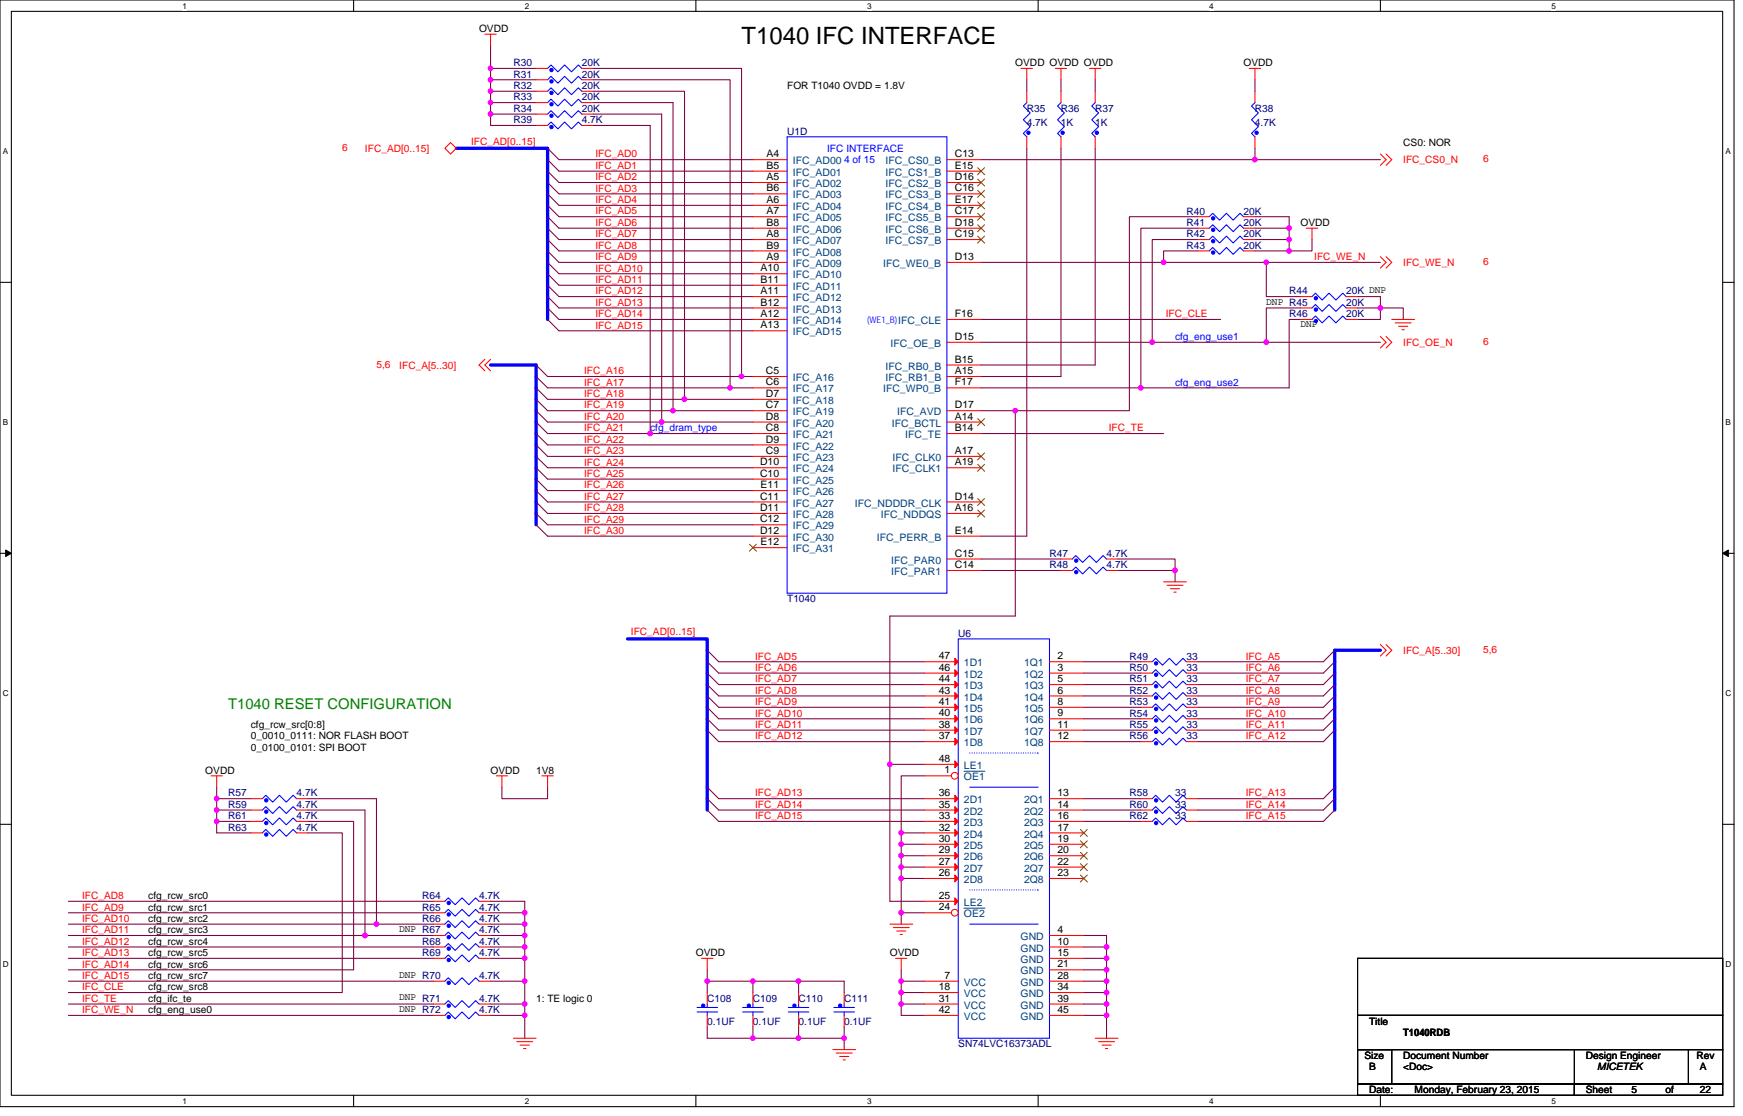
[picture p5: page 5]

cfg_eng_use1

cfg_eng_use2

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

Date: Date: Date: Monday, February 23, 2015 Monday, February 23, 2015 Monday, February 23, 2015 | | Sheet Sheet Sheet 5 5 5 of of of 22 22 22

# T1040 FLASH RESET RS-422

## RS-422 TRANSMIT

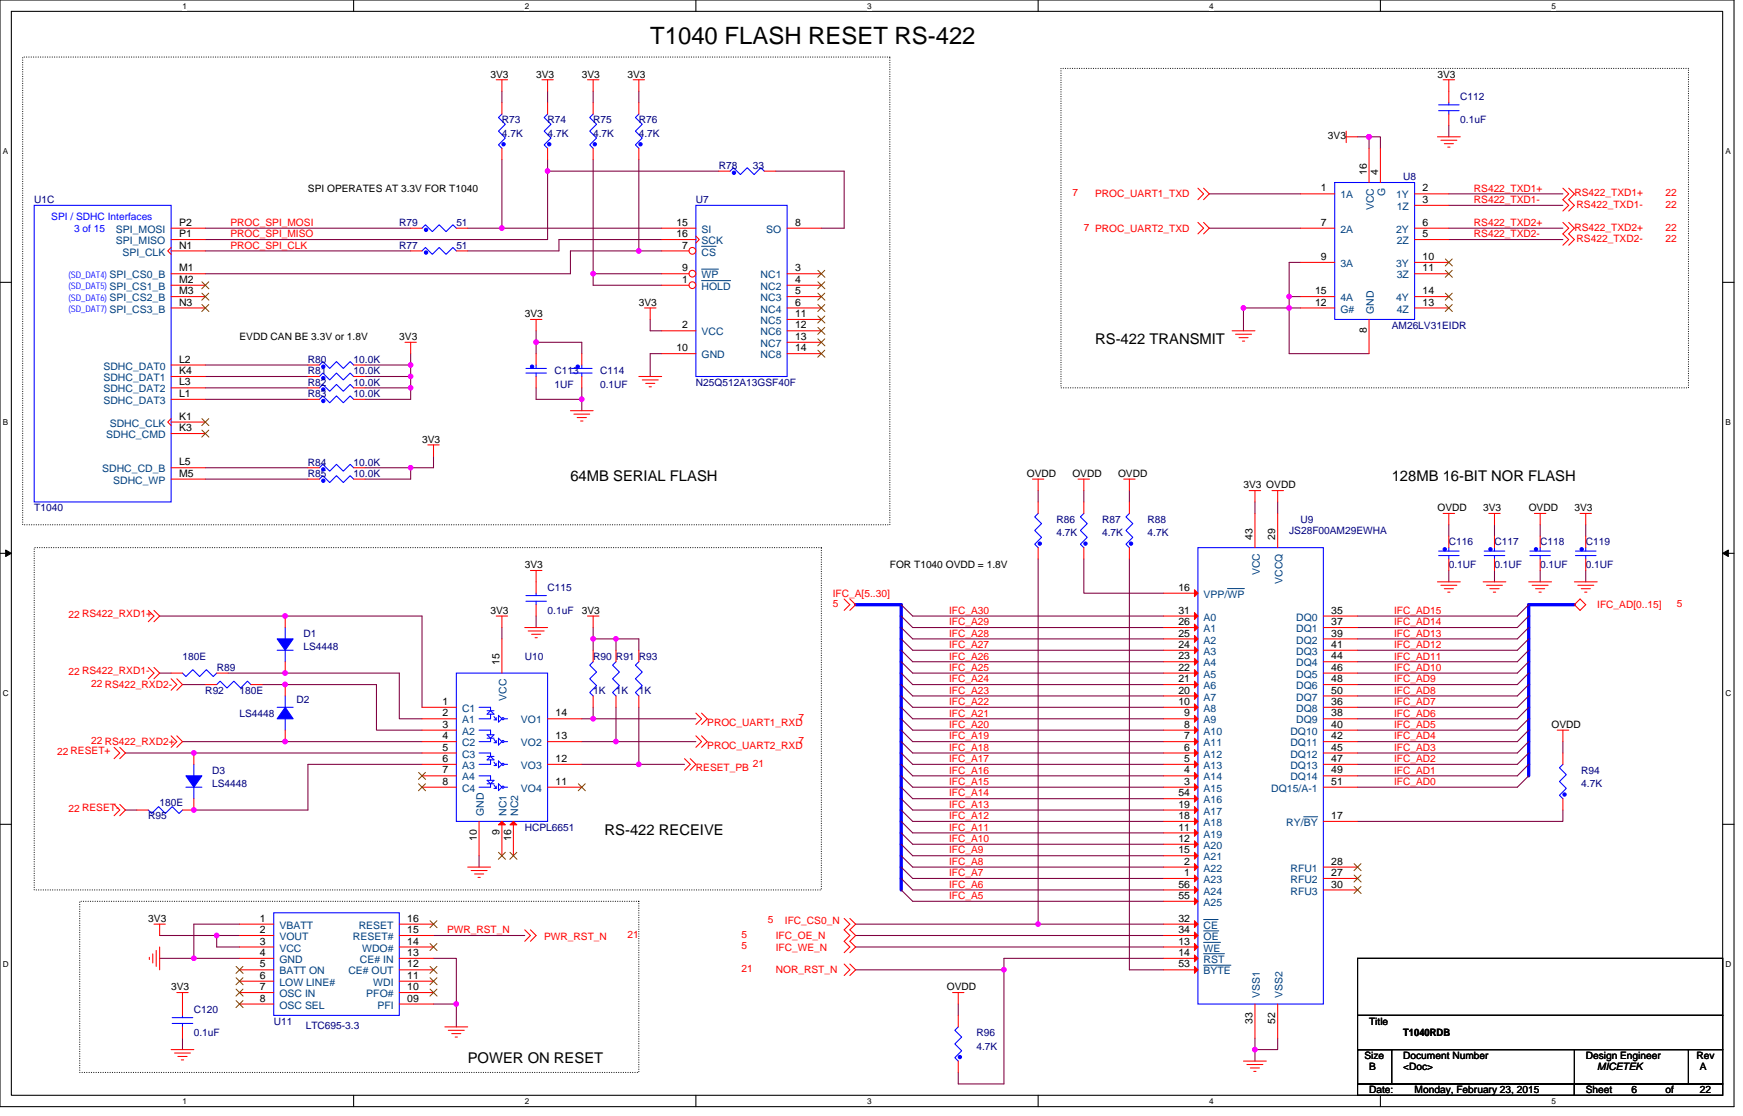
[picture p6: page 6]

SPI OPERATES AT 3.3V FOR T1040

EVDD CAN BE 3.3V or 1.8V

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

Date: Date: Date: Monday, February 23, 2015 Monday, February 23, 2015 Monday, February 23, 2015 | | Sheet Sheet Sheet 6 6 6 of of of 22 22 22

# T1040 SYSTEM LOGIC INTERFACE

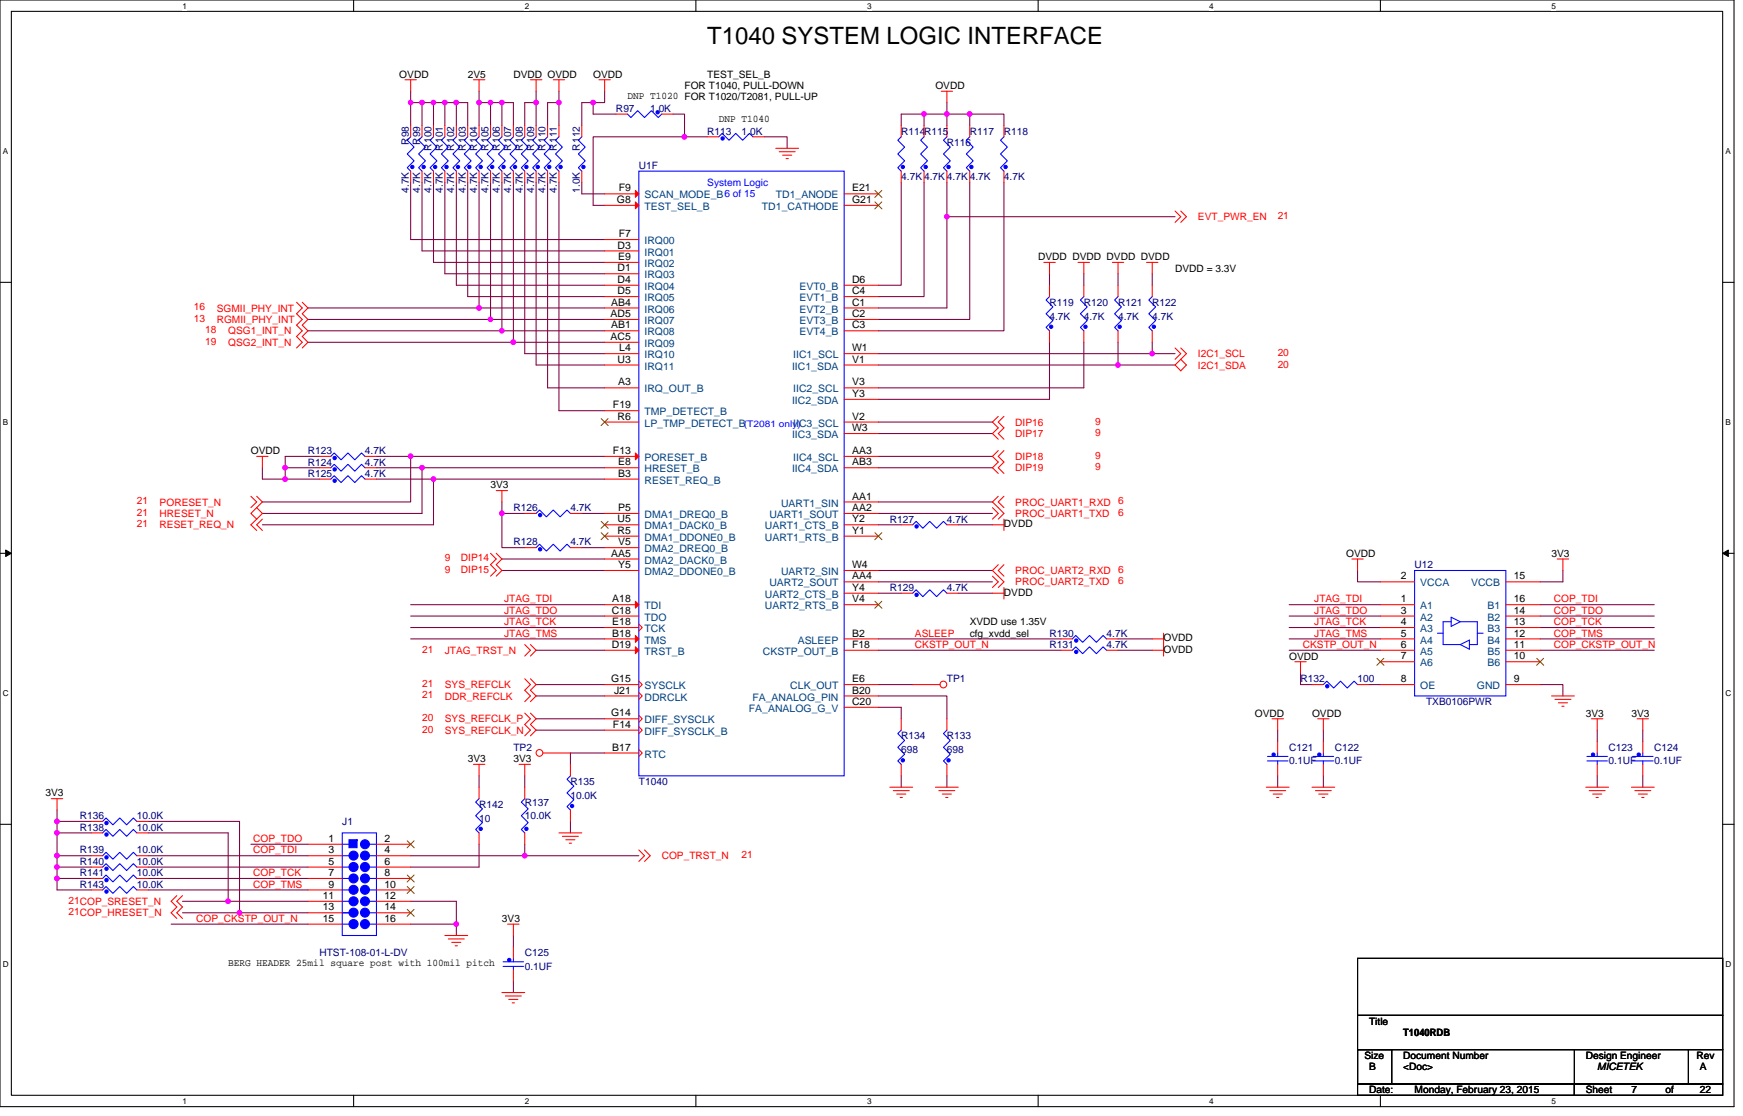
[picture p7: page 7]

IRQ01 D3
IRQ02 E9
IRQ03 D1
IRQ04 D4
IRQ05 D5

DVDD DVDD

IRQ11 U3

BERG HEADER 25mil square post with 100mil pitch

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

Date: Date: Date: Monday, February 23, 2015 Monday, February 23, 2015 Monday, February 23, 2015 | | Sheet Sheet Sheet 7 7 7 of of of 22 22 22

# T1040 ETHERNET and SERDES INTERFACE

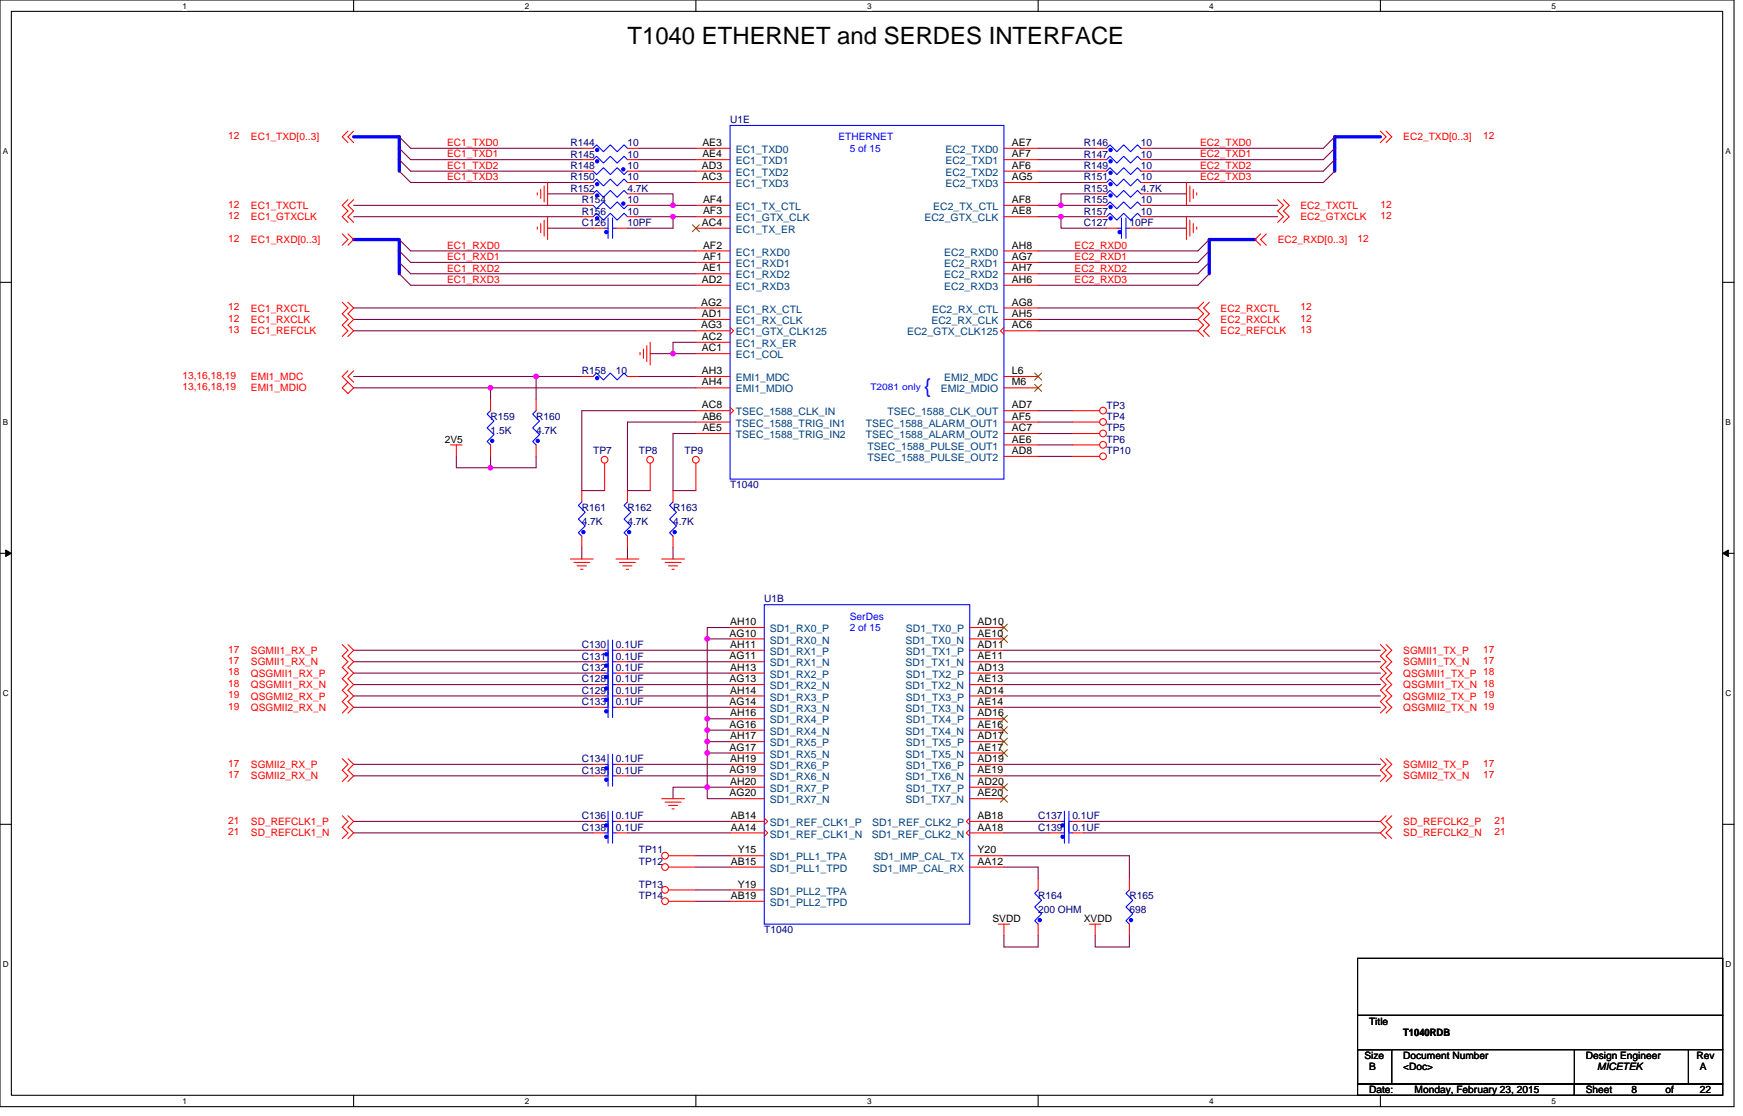
[picture p8: page 8]
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

Date: Date: Date: Monday, February 23, 2015 Monday, February 23, 2015 Monday, February 23, 2015 | | Sheet Sheet Sheet 8 8 8 of of of 22 22 22

# T1040 QE INTERFACE & USB INTERFACE

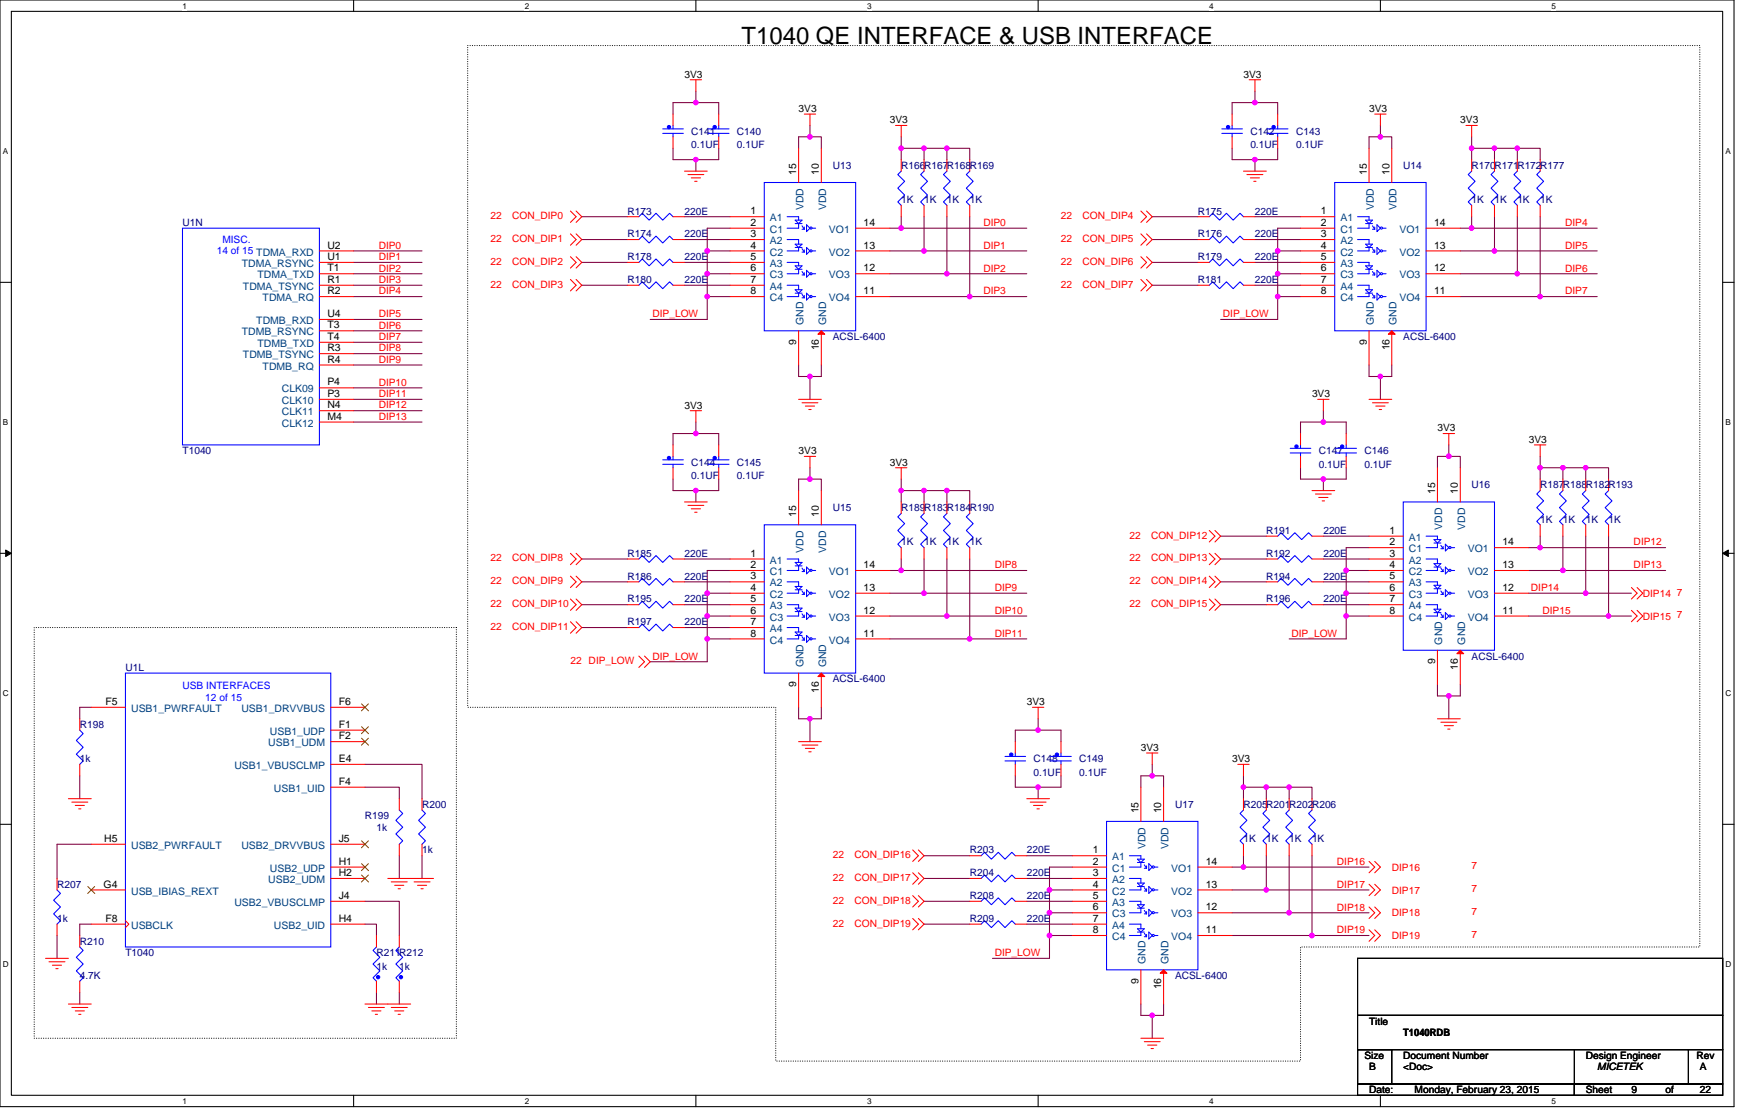
[picture p9: page 9]
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

Date: Date: Date: Monday, February 23, 2015 Monday, February 23, 2015 Monday, February 23, 2015 | | Sheet Sheet Sheet 9 9 9 of of of 22 22 22

# T1040 POWER SUPPLY

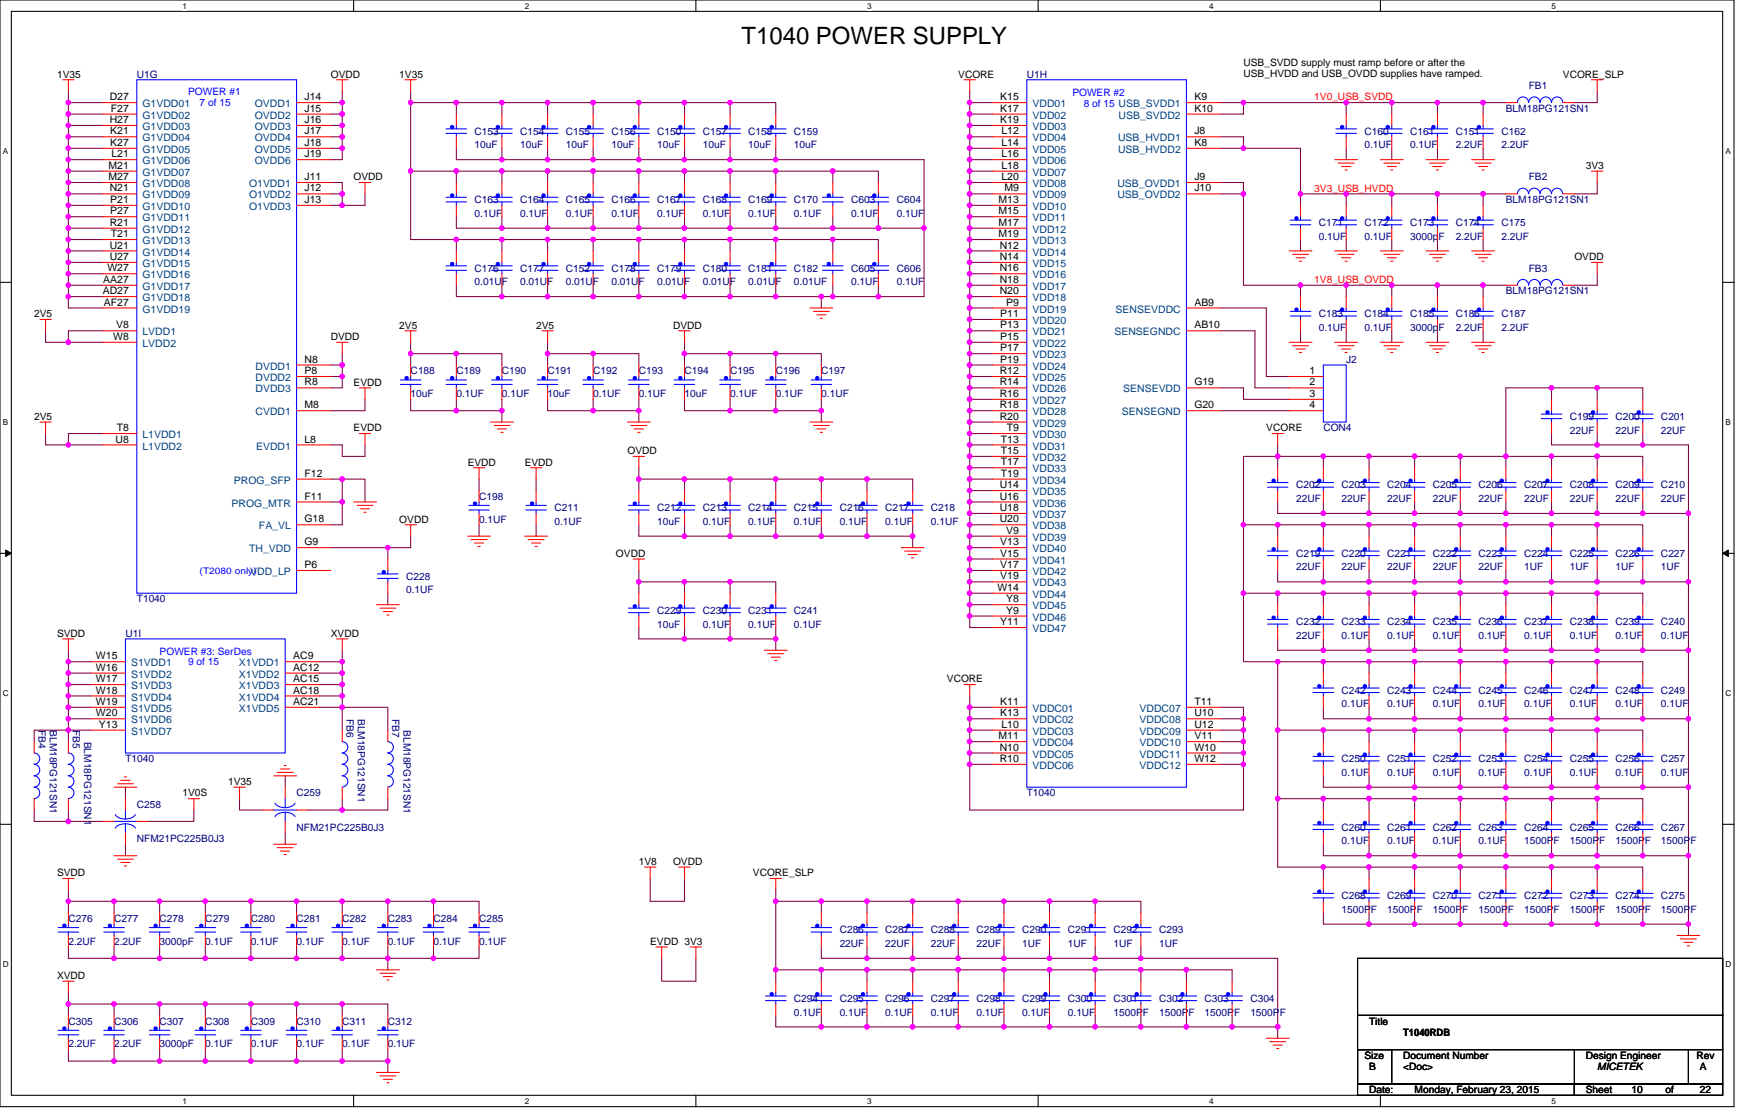
[picture p10: page 10]

USB_SVDD supply must ramp before or after the
USB_HVDD and USB_OVDD supplies have ramped.

VDD28 R18 | 4
VDD29 R20 | VCORE

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

Date: Date: Date: Monday, February 23, 2015 Monday, February 23, 2015 Monday, February 23, 2015 | | Sheet Sheet Sheet 10 10 10 of of of 22 22 22

# T1040 PLL FILTERs and GROUND

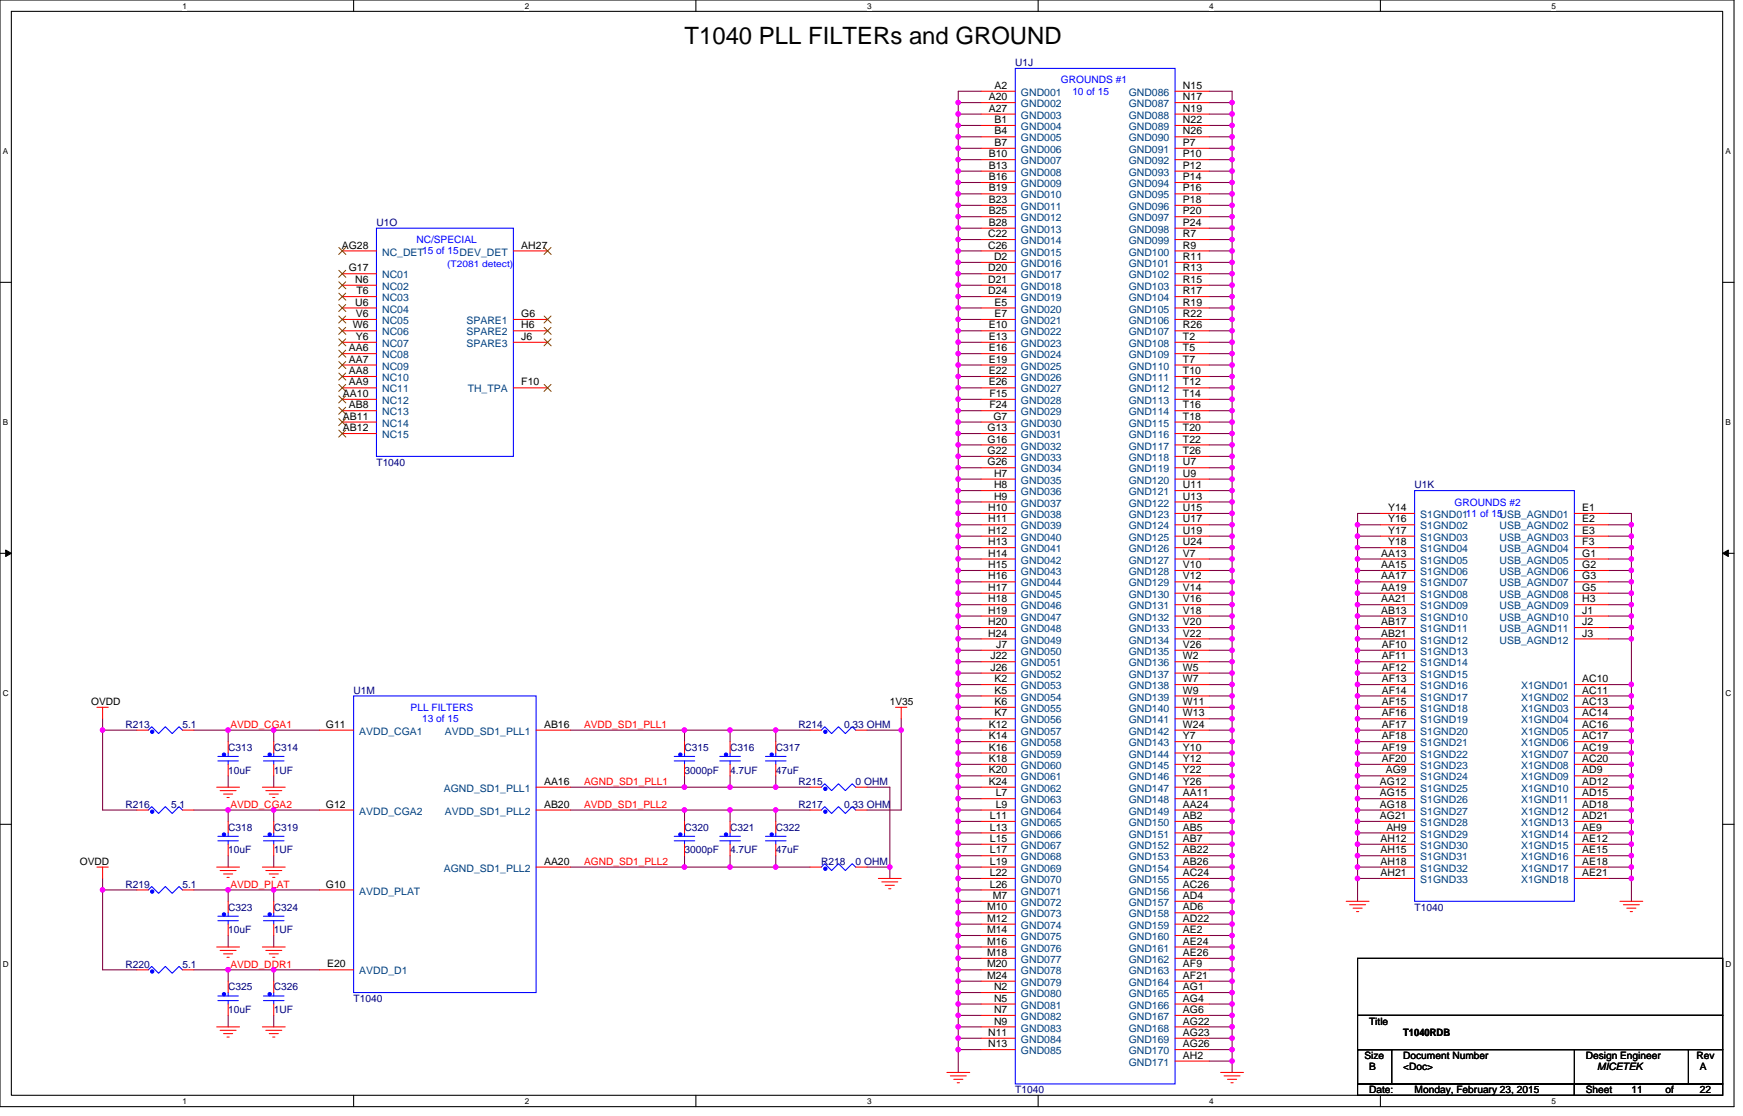
[picture p11: page 11]
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

Date: Date: Date: Monday, February 23, 2015 Monday, February 23, 2015 Monday, February 23, 2015 | | Sheet Sheet Sheet 11 11 11 of of of 22 22 22

# RGMII ETHERNET PORTS

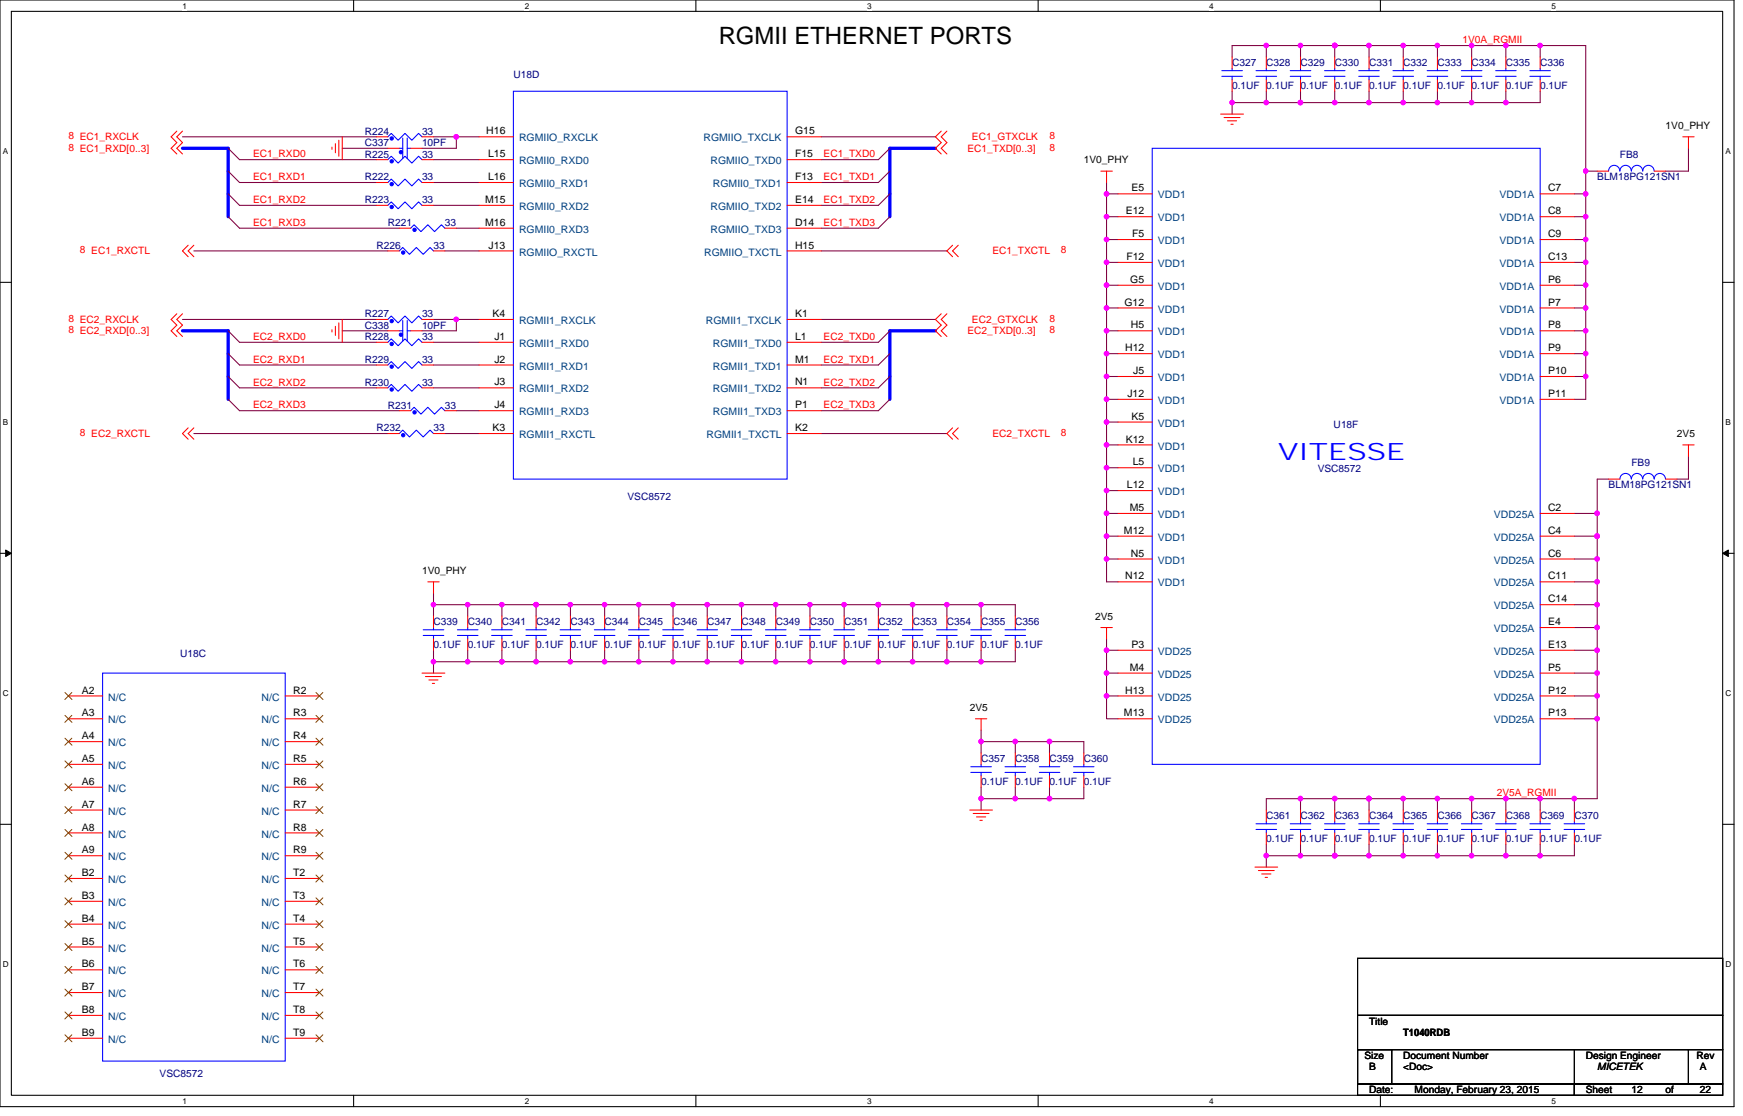
[picture p12: page 12]
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

Date: Date: Date: Monday, February 23, 2015 Monday, February 23, 2015 Monday, February 23, 2015 | | Sheet Sheet Sheet 12 12 12 of of of 22 22 22

# RGMII ETHERNET PORT 2

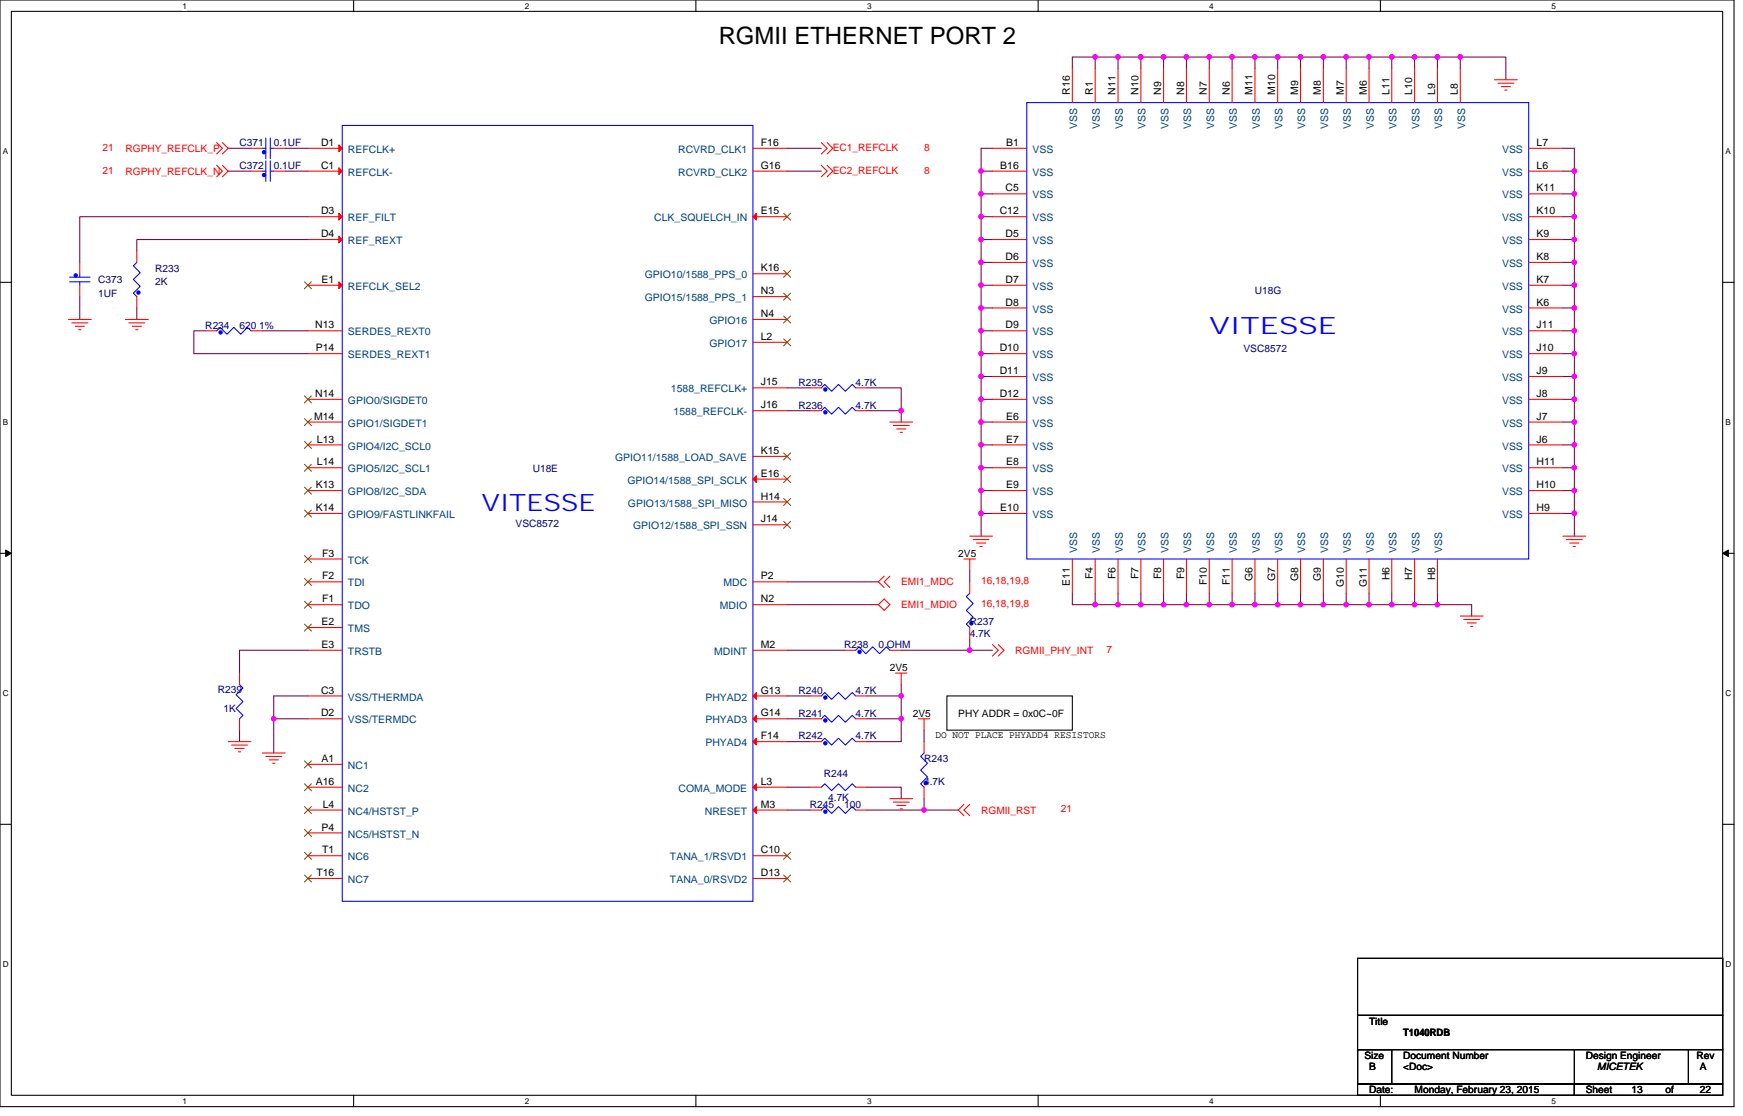
[picture p13: page 13]

DO NOT PLACE PHYADD4 RESISTORS

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

Date: Date: Date: Monday, February 23, 2015 Monday, February 23, 2015 Monday, February 23, 2015 | | Sheet Sheet Sheet 13 13 13 of of of 22 22 22

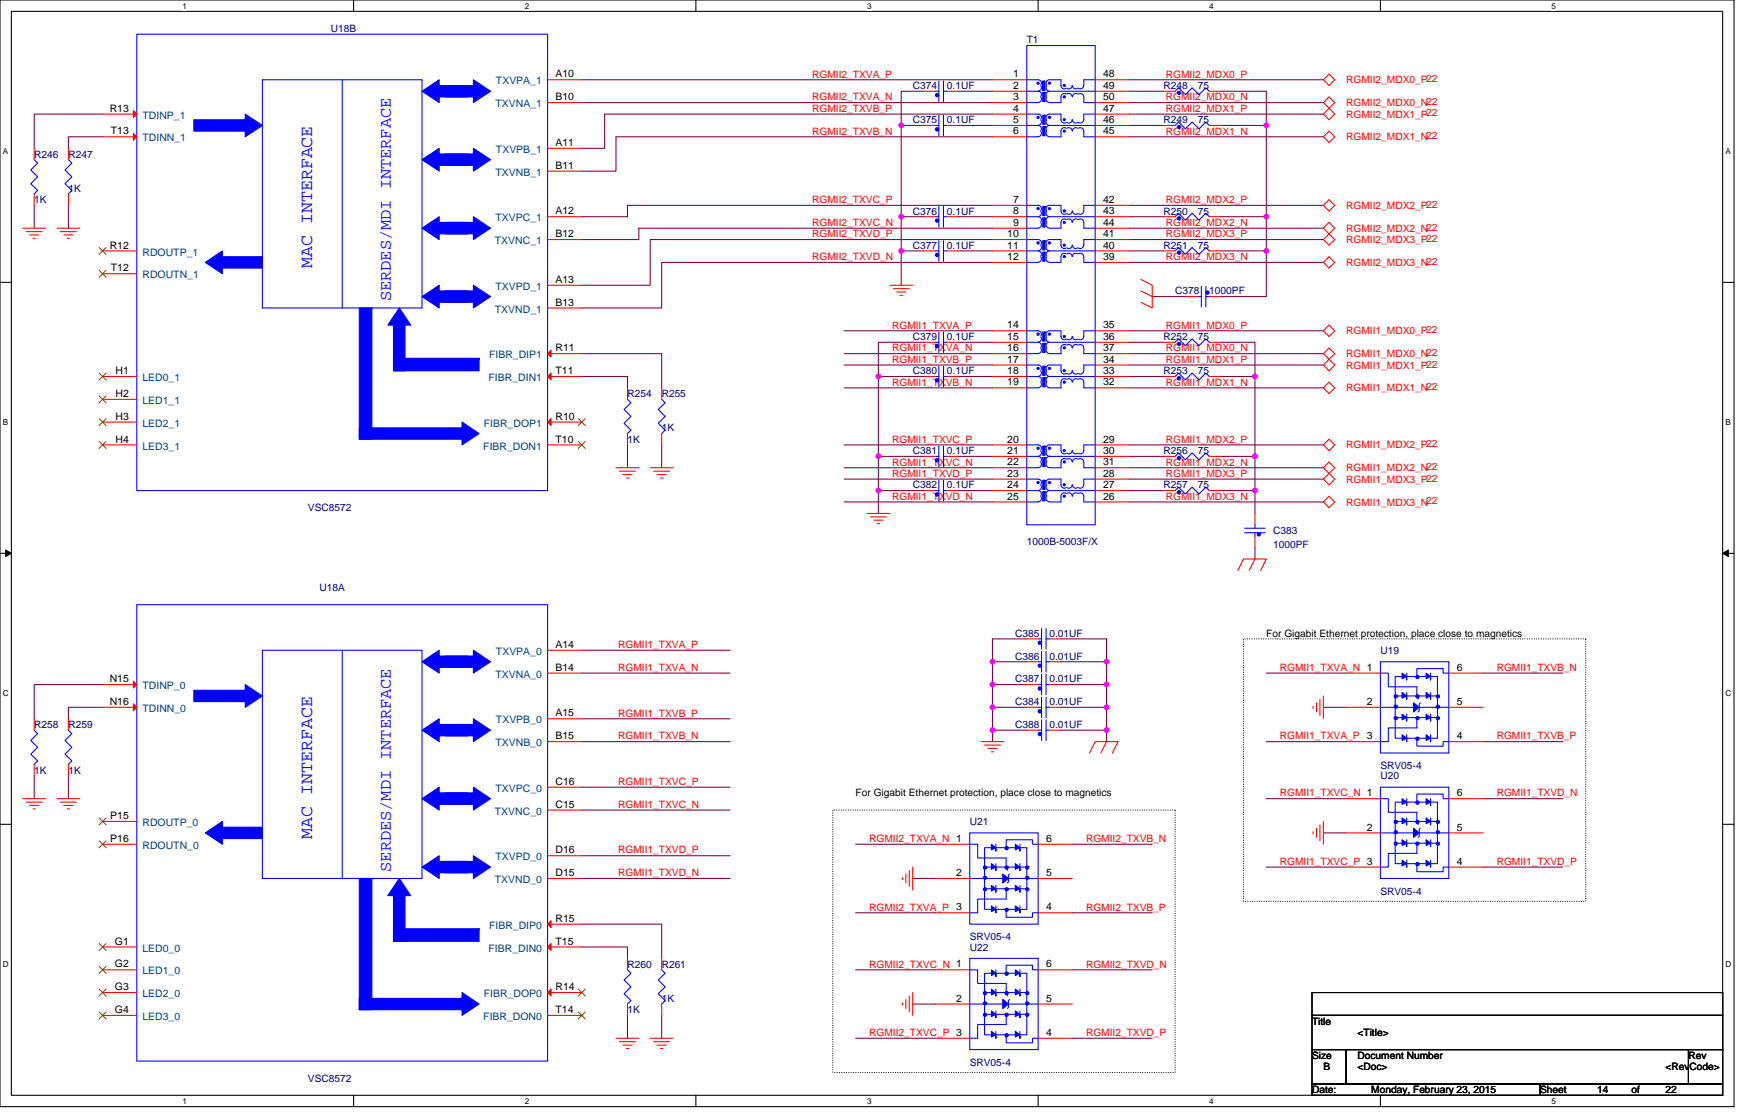
[picture p14: page 14]

For Gigabit Ethernet protection, place close to magnetics

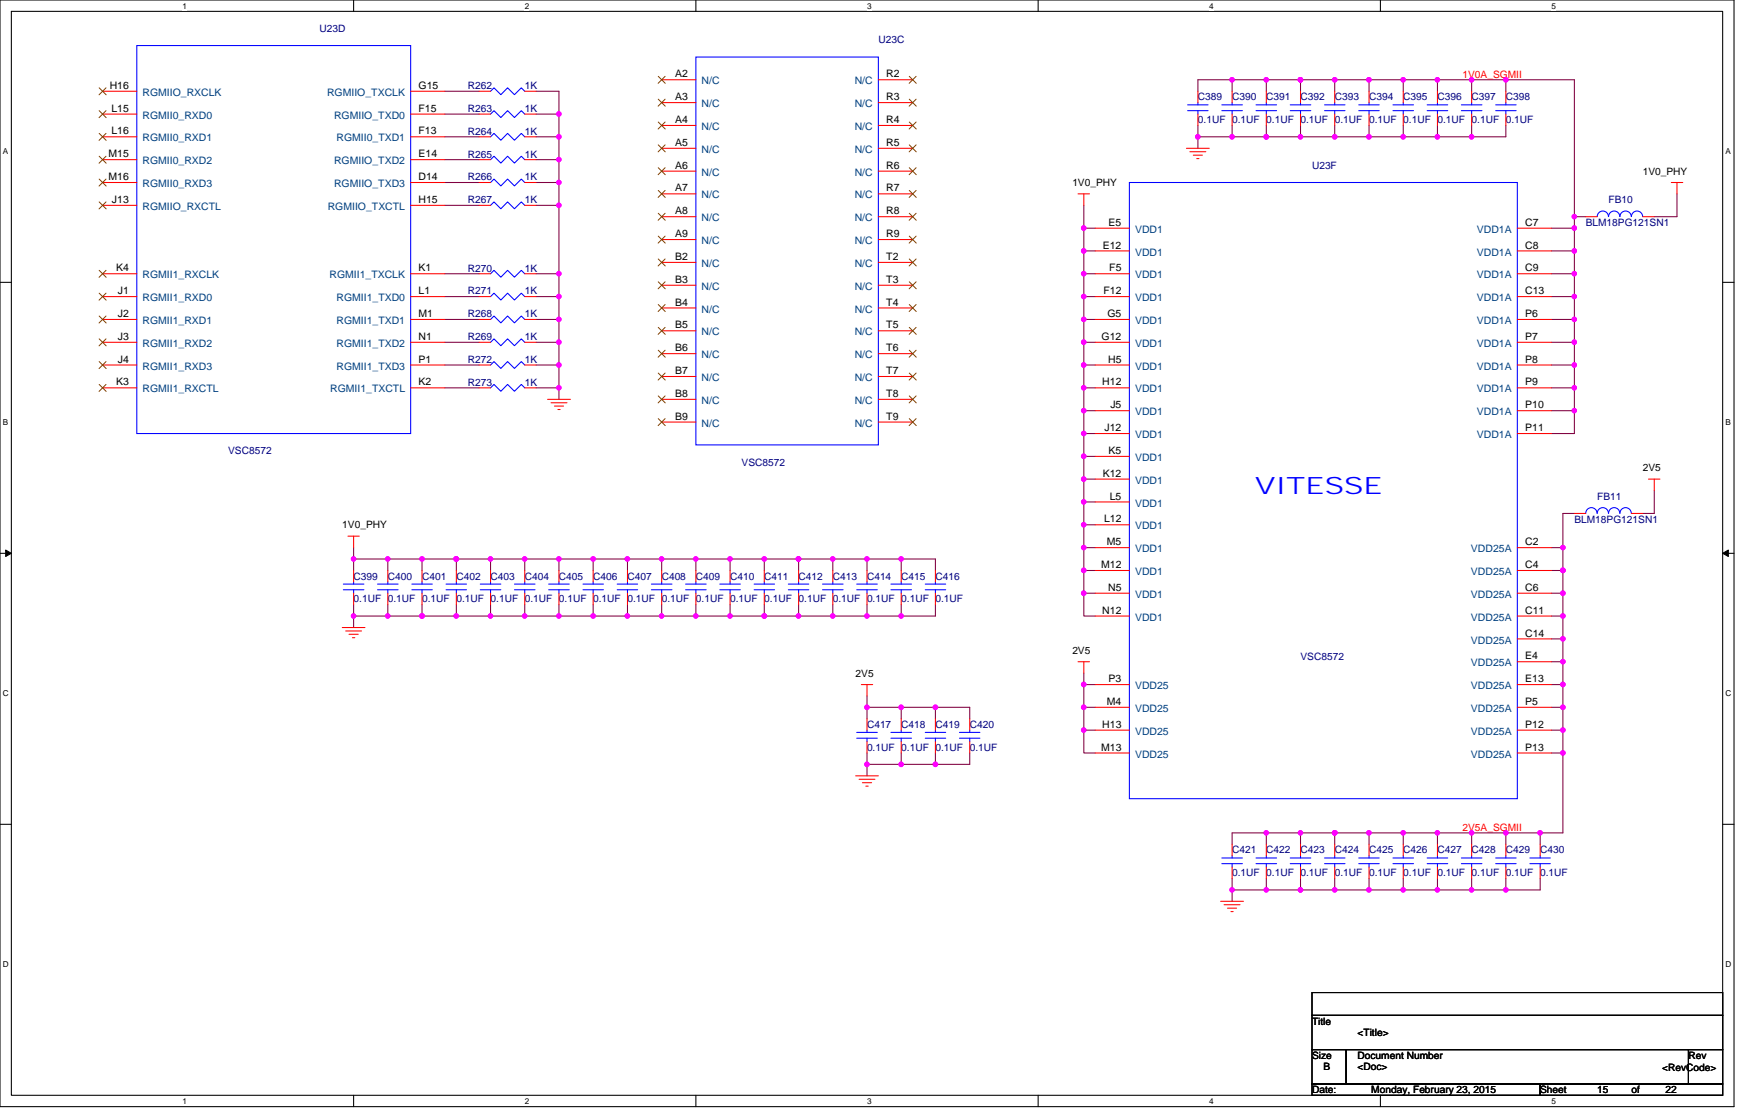
[picture p15: page 15]
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

Date: Date: Date: Monday, February 23, 2015 Monday, February 23, 2015 Monday, February 23, 2015 | Sheet Sheet Sheet 15 15 15 of of of 22 22 22

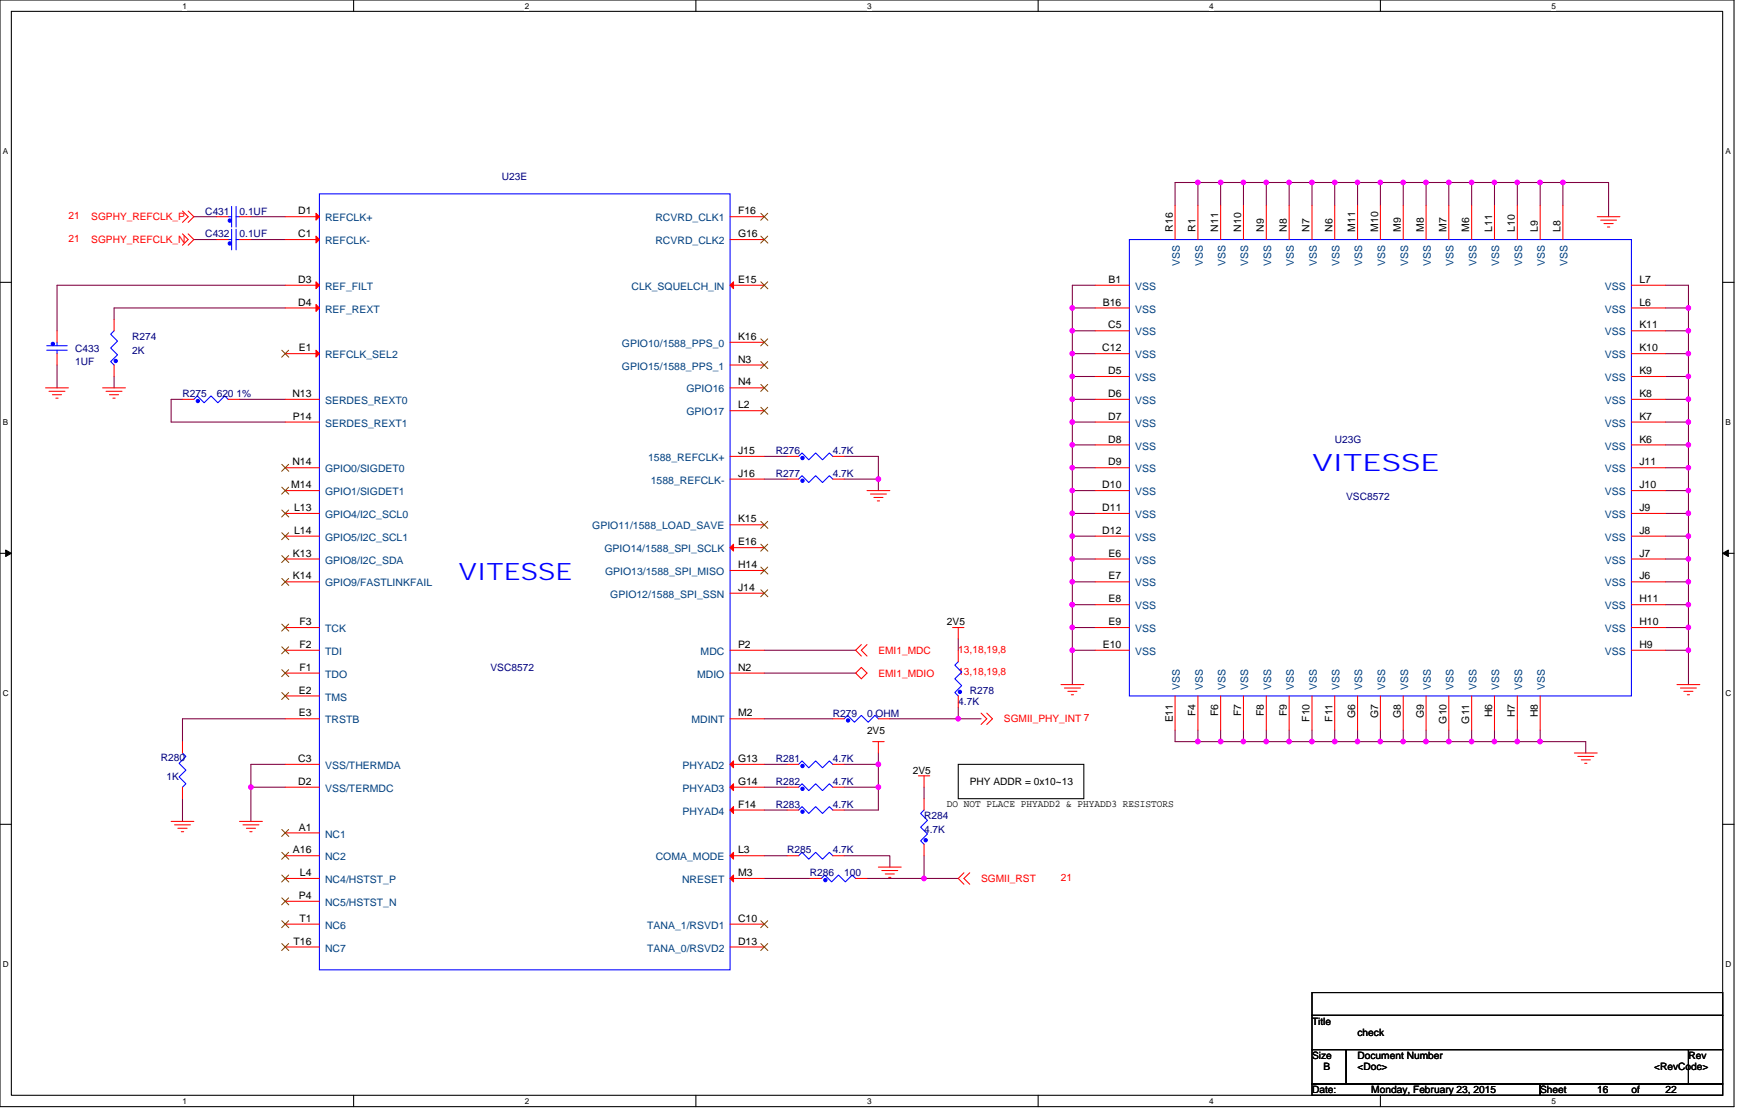
[picture p16: page 16]
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

Date: Date: Date: Monday, February 23, 2015 Monday, February 23, 2015 Monday, February 23, 2015 | Sheet Sheet Sheet 16 16 16 of of of 22 22 22

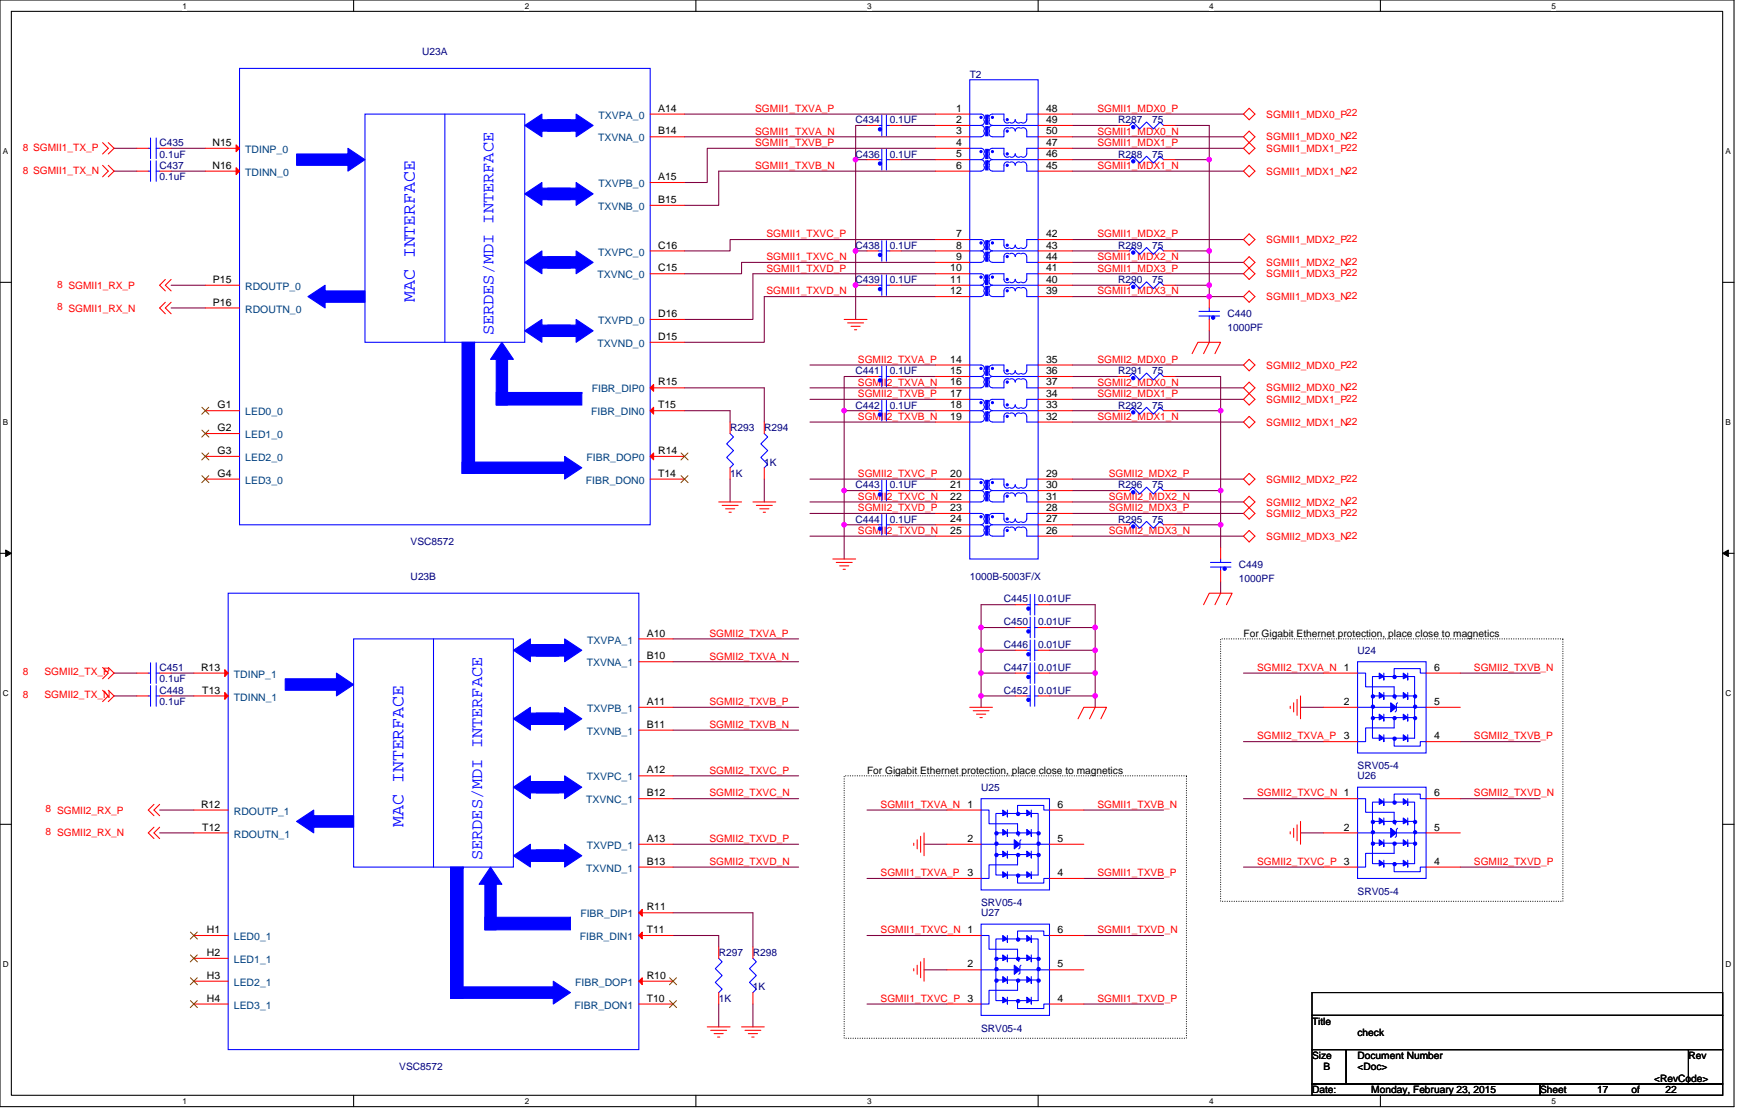
[picture p17: page 17]

C434 SGMII1_TXVA_N | 0.1UF 2

TDINP_0 N15

For Gigabit Ethernet protection, place close to magnetics

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

Date: Date: Date: Monday, February 23, 2015 Monday, February 23, 2015 Monday, February 23, 2015 | Sheet Sheet Sheet 17 17 17 of of of 22 22 22

# QSGMII PHY 1

## T1040 ONLY!

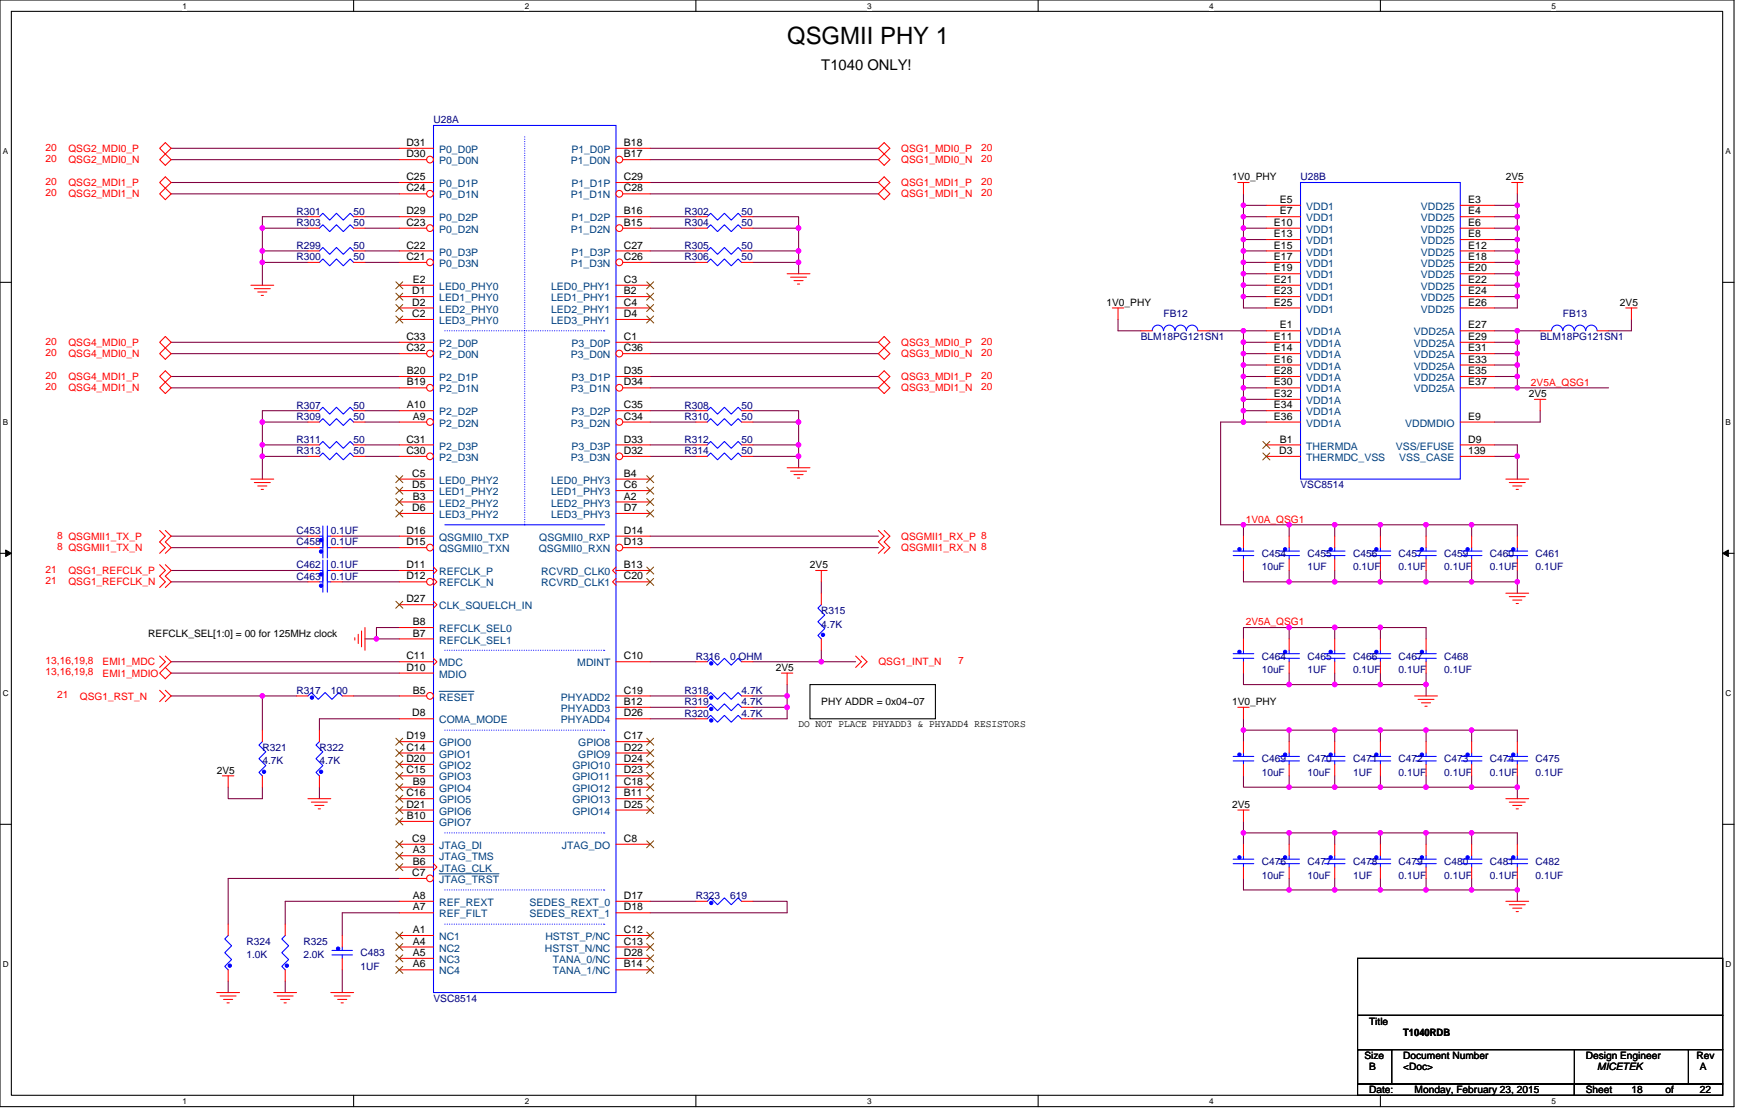
[picture p18: page 18]

DO NOT PLACE PHYADD3 & PHYADD4 RESISTORS

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

Date: Date: Date: Monday, February 23, 2015 Monday, February 23, 2015 Monday, February 23, 2015 | | Sheet Sheet Sheet 18 18 18 of of of 22 22 22

# QSGMII PHY 2

## T1040 ONLY!

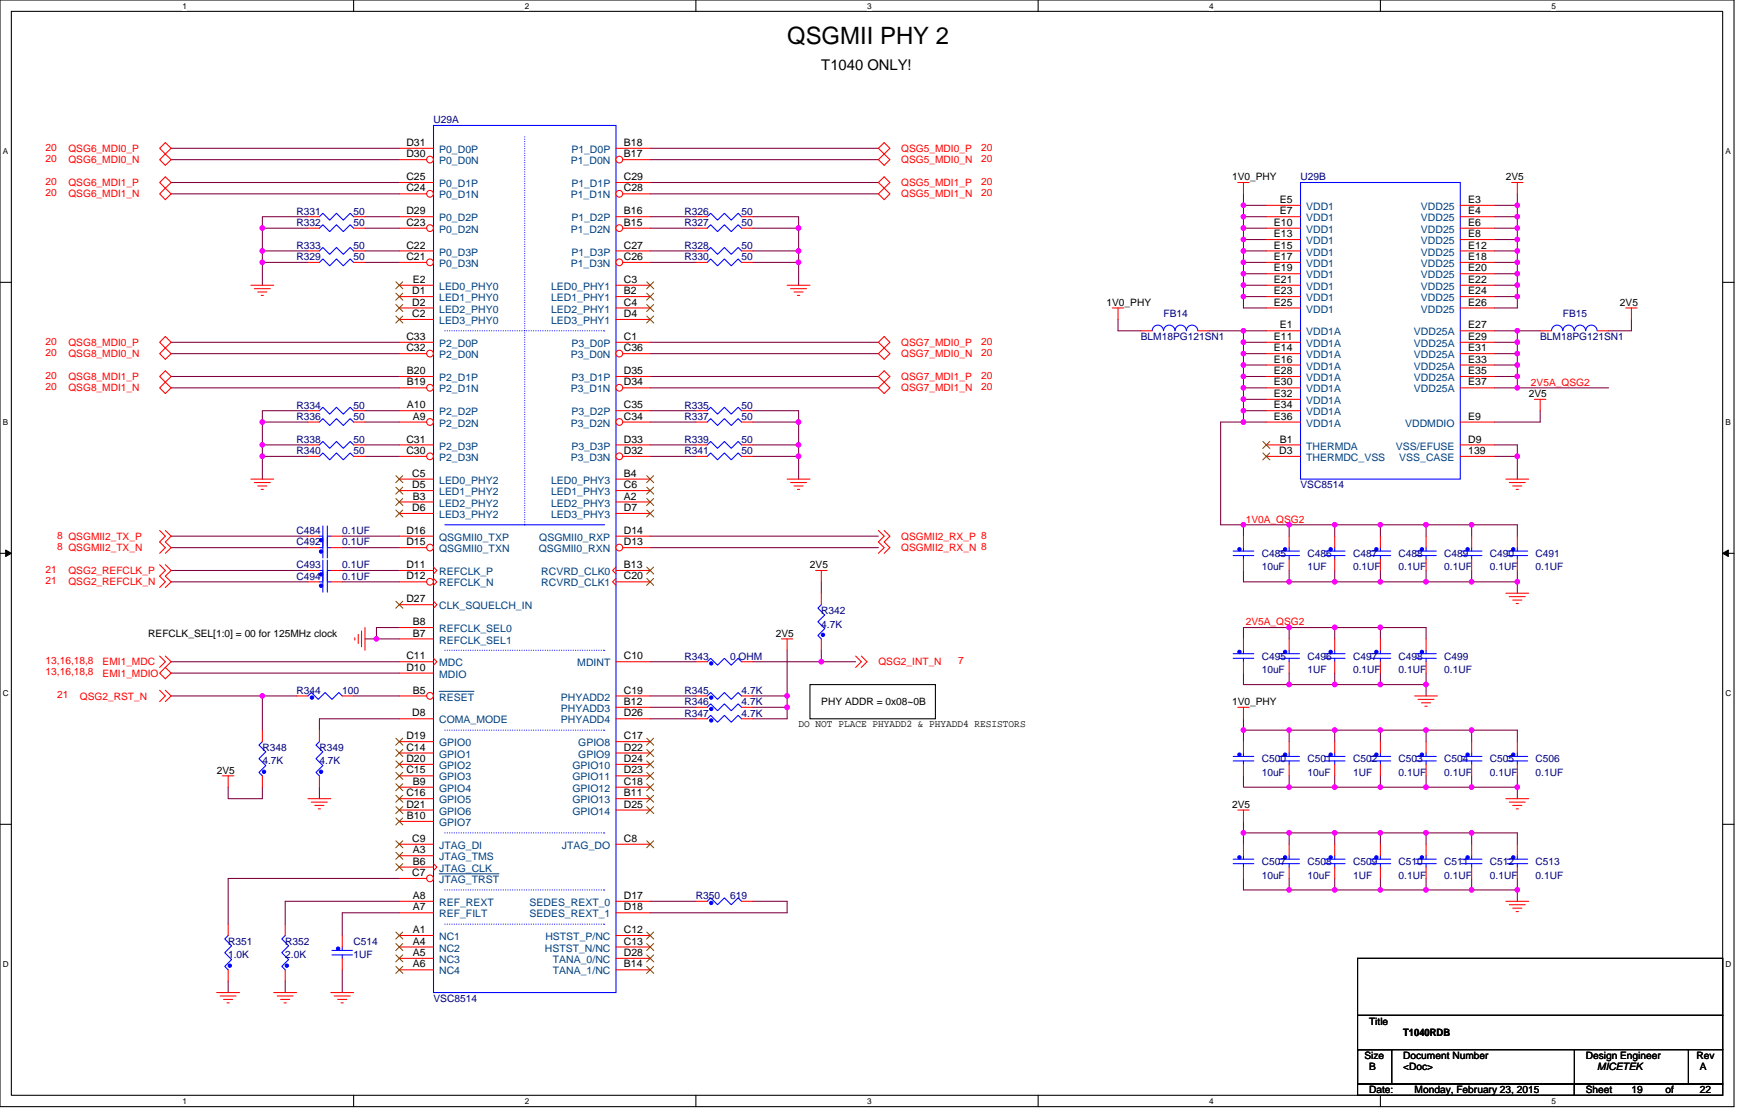
[picture p19: page 19]

DO NOT PLACE PHYADD2 & PHYADD4 RESISTORS

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

Date: Date: Date: Monday, February 23, 2015 Monday, February 23, 2015 Monday, February 23, 2015 | | Sheet Sheet Sheet 19 19 19 of of of 22 22 22

# QSGMII ETHERNET PORTs

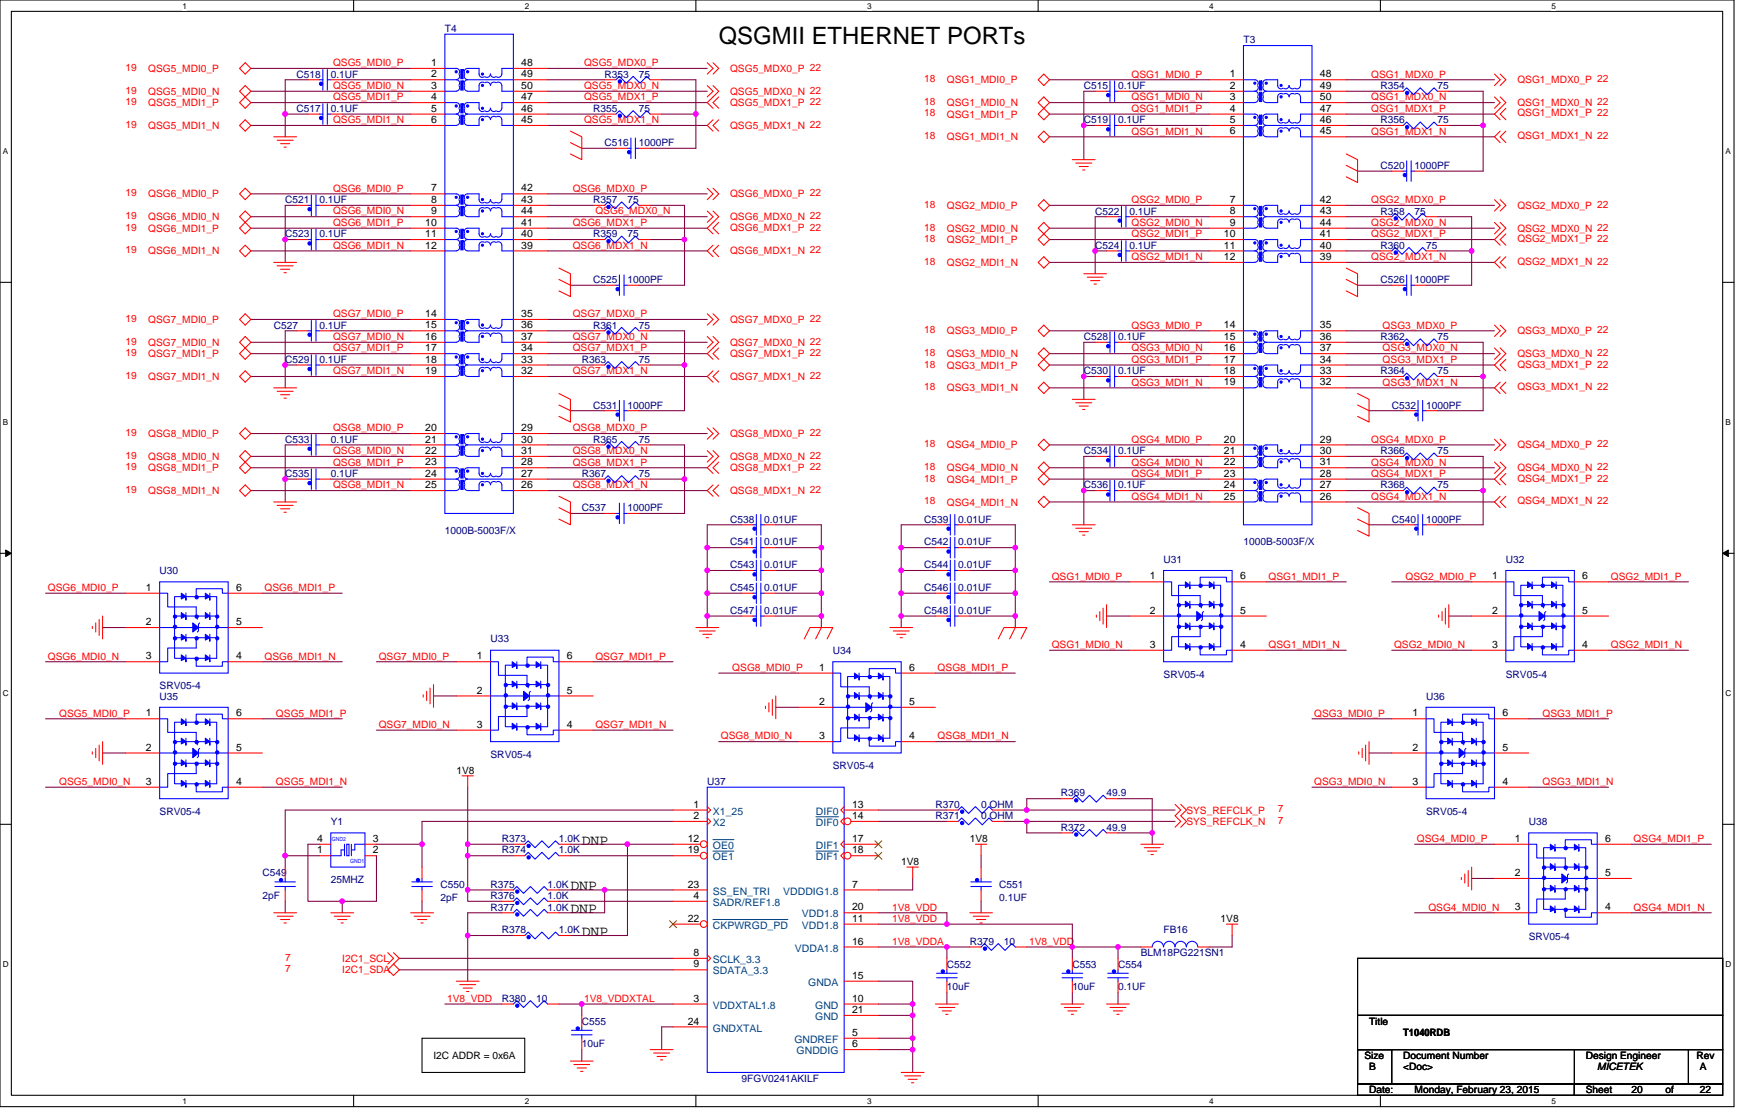
[picture p20: page 20]
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

Date: Date: Date: Monday, February 23, 2015 Monday, February 23, 2015 Monday, February 23, 2015 | | Sheet Sheet Sheet 20 20 20 of of of 22 22 22

# SYSTEM CLOCK GENERATORs

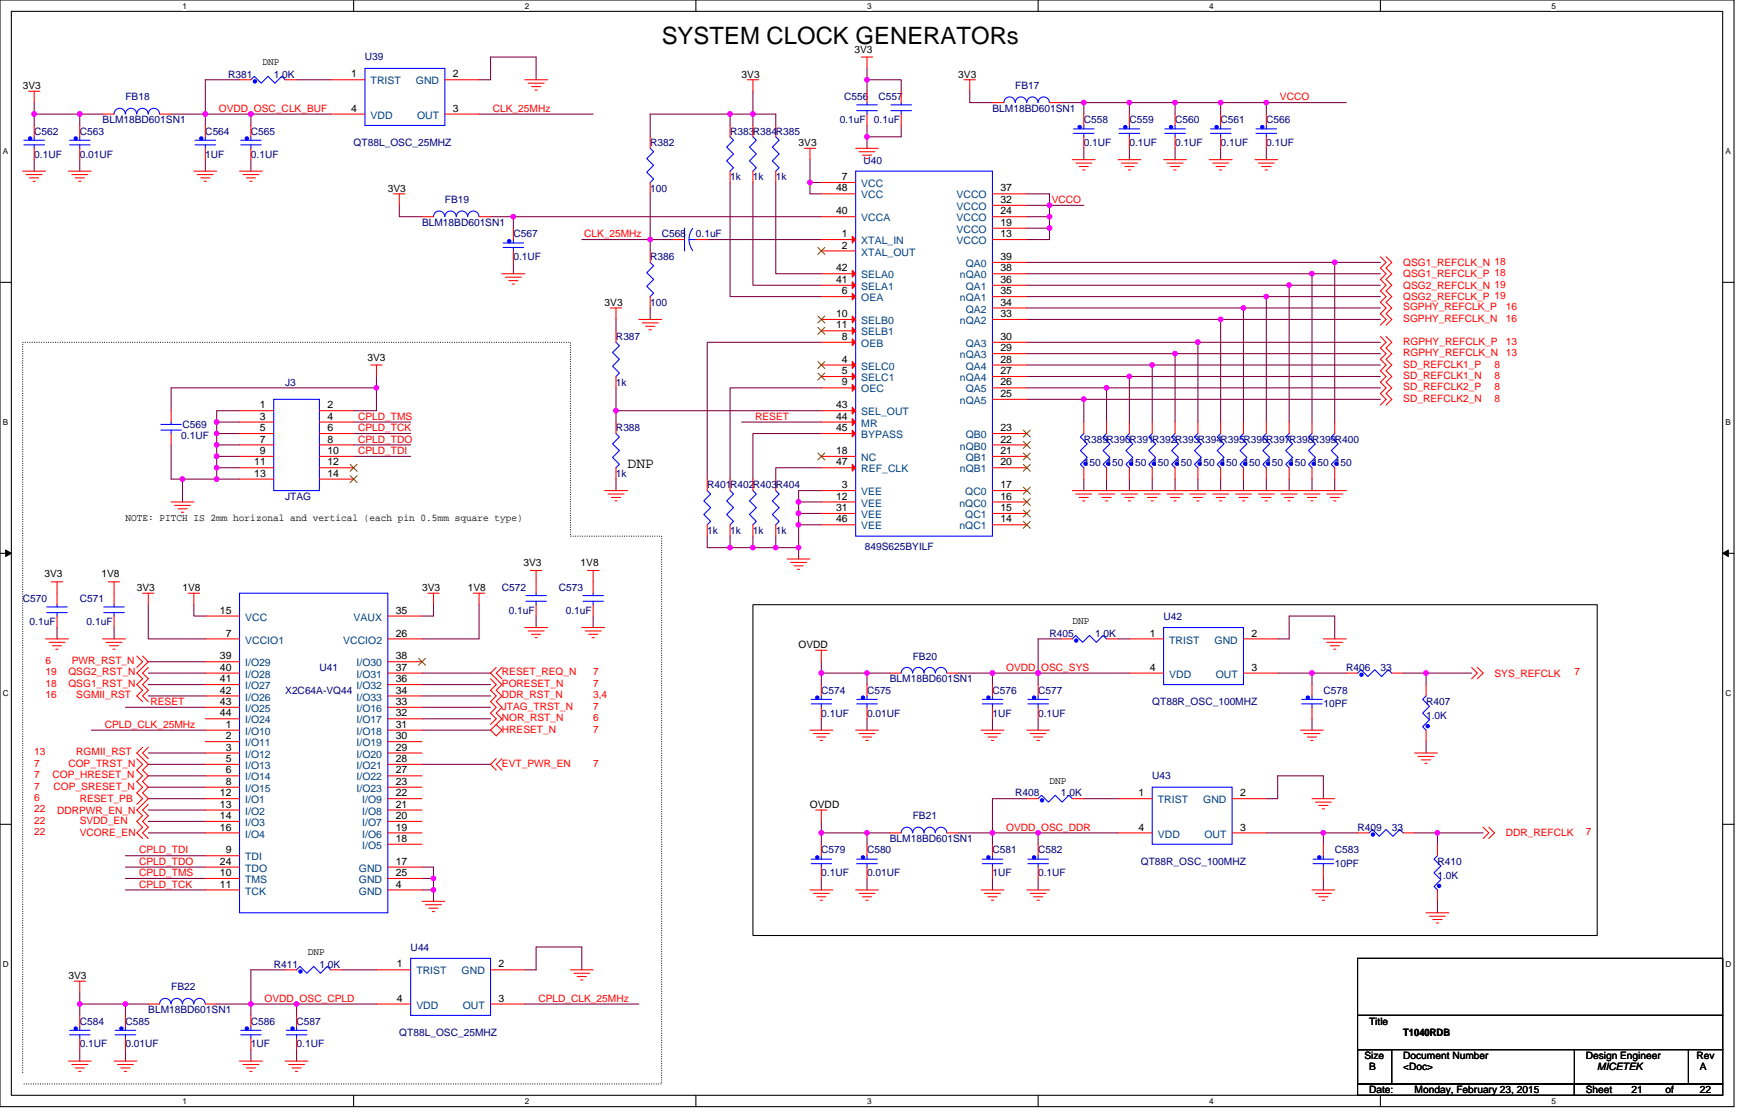
[picture p21: page 21]

NOTE: PITCH IS 2mm horizonal and vertical (each pin 0.5mm square type)

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

Date: Date: Date: Monday, February 23, 2015 Monday, February 23, 2015 Monday, February 23, 2015 | | Sheet Sheet Sheet 21 21 21 of of of 22 22 22

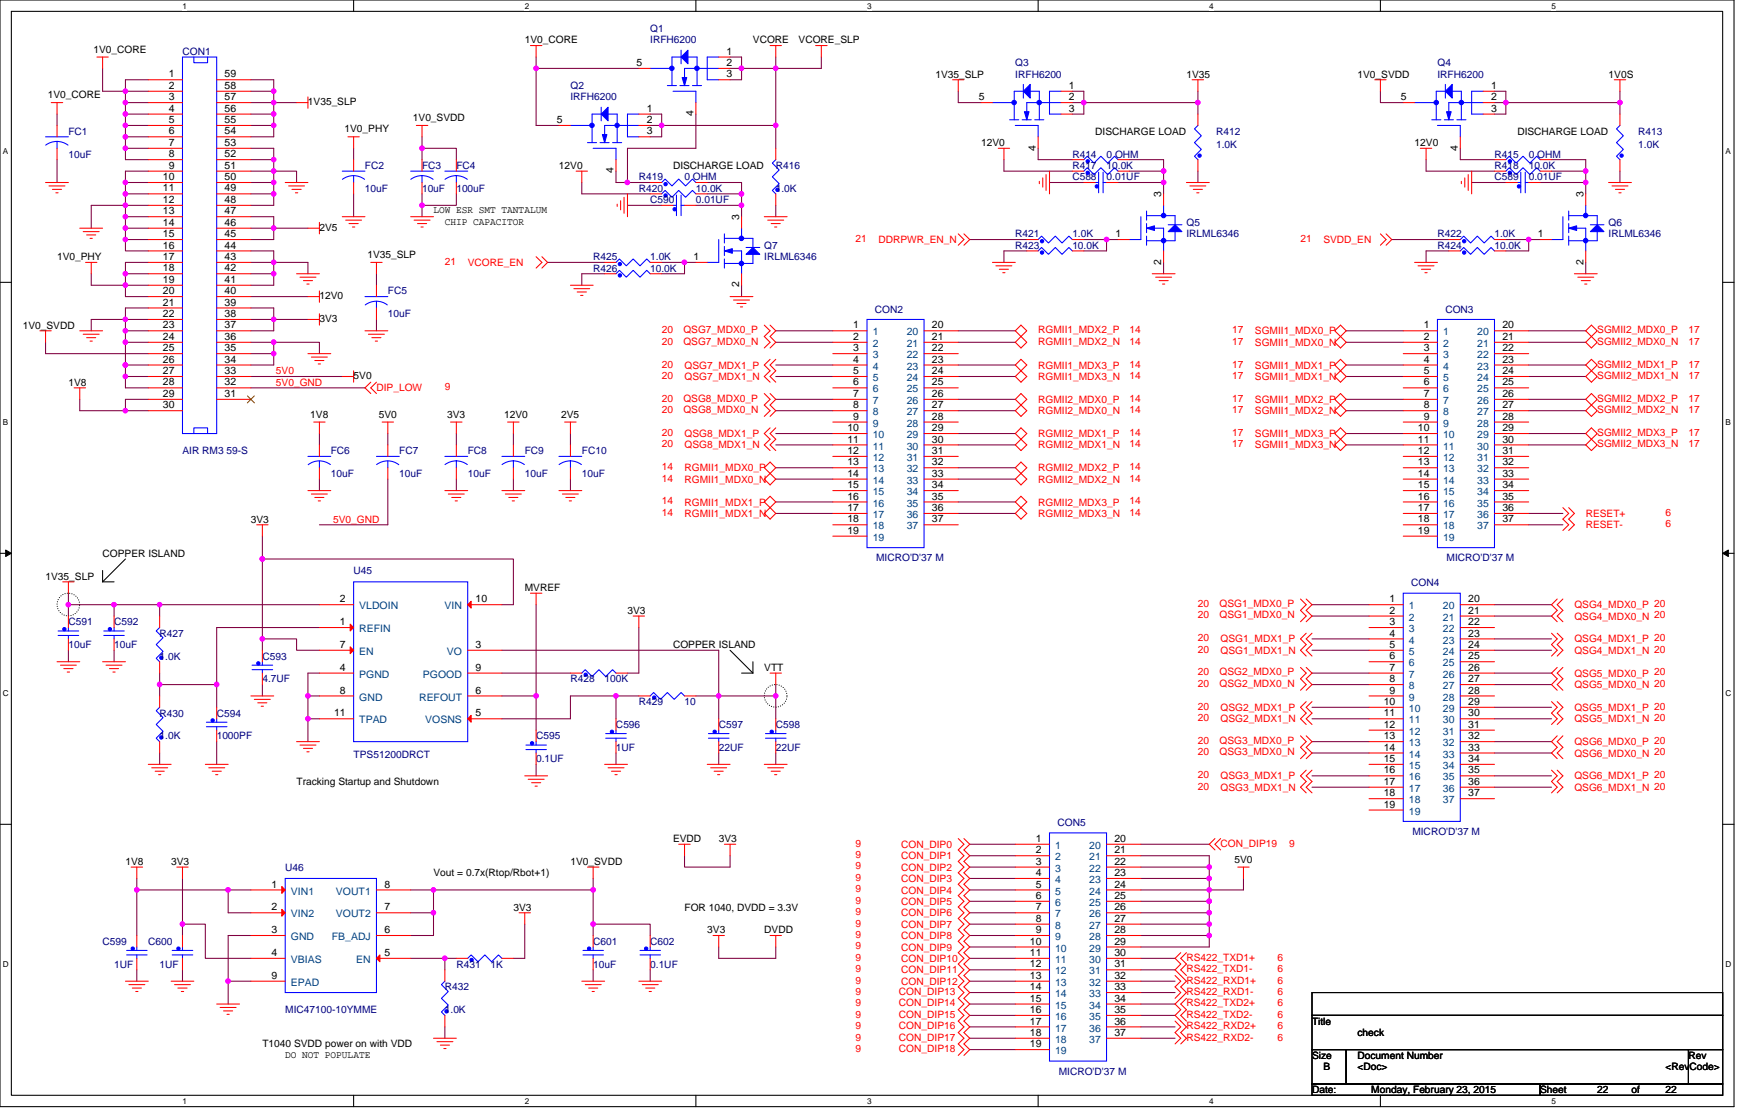
[picture p22: page 22]

7 | 53
8 | 52

LOW ESR SMT TANTALUM
CHIP CAPACITOR

18 | 42
19 | 41
20 | 40

Tracking Startup and Shutdown

T1040 SVDD power on with VDD
DO NOT POPULATE

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

Date: Date: Date: Monday, February 23, 2015 Monday, February 23, 2015 Monday, February 23, 2015 | Sheet Sheet Sheet 22 22 22 of of of 22 22 22
