siddharthnarayanan/RCI/(list of files, drawings)

Other design files:
sch-28215.opj
TEST.DSN
